Chandanpanda/ART-Forum-2017-Stan-Tutorial/sim/batline/README.md

# IMU bat: automated build and calibration line

A snapshot, 1 October 2026, of the design doc of the same name; and, from 2 October, the first five milestones (M0 to M4) of its simulation plan, "IMU bat line: MuJoCo implementation plan". Where the two differ, the plan wins: it keeps a person for six manual tasks, including the sleeves, and builds every station as a gantry module. Whether the 5-DOF arm stays is still open; none of the five depends on it.

`sim/batline` is the design of an unattended line that builds, calibrates and tests the IMU bat, the study that decided the bat, the specs, the derived bat and the fast line model that the rest of the simulation builds on, the station module that every station is a copy of, the calibration station's eight-camera rig, the IMU's calibration on its gimbal, and the tests: station 2's board self-test, the factory iPhone's test and the full-speed swing rig.

    python3 sim/scripts/batline/check_all.py                # check_bat, check_line, check_gantry, check_cameras, check_imu, check_calibration,
                                                            # check_link and check_swing, about 48 minutes on four cores
    python3 sim/scripts/batline/demo_bat.py [--bat adult]   # the bat rendered: twelve views, one contact sheet
    python3 sim/scripts/batline/demo_station.py [--station unseen] [--window T0 T1]
                                                            # a station commissioning itself and running every op, filmed at 0.1 fps
    python3 sim/scripts/batline/demo_rig.py [--bat unseen] [--window T0 T1]
                                                            # the rig calibrating itself and measuring a bat, through its eight cameras
    python3 sim/scripts/batline/demo_calibration.py [--bat adult] [--window T0 T1]
                                                            # a bat's IMU calibration plan, filmed beside its stream and the steppers' lag
    python3 sim/scripts/batline/demo_swing.py [--bat adult] [--weak] [--window T0 T1]
                                                            # the swing rig through the rated swing on its dummy pack, beside its traces
    python3 sim/scripts/batline/demo_phone.py [--bat adult] # what the factory iPhone sees through the slow swing, and where the app puts the bands
    cd sim && python3 -m batline.line [--demand 1000]       # the bat and the line sized for it, as text

| file | what it is |
| --- | --- |
| `README.md` | this design: the bat, the stations, transport, calibration, testing, unattended running, capacity, how it maps onto `sim/truss` and `sim/rfgyc26`, build order, risks; and what M0 to M4 found |
| `spec.py` | the facts (an AA cell's IEC envelope, the printer, the board's placeholder drawing, the knit), the product rules, the two task specs (`Bat`, `Line`), and the estimates (`Est`, `Faults`, `Person`), each naming the milestone that replaces it |
| `product.py` | the bat derived from a `Bat`: the handle's section, the board slot and its snap, the cell stack, the frame's truss, the sleeve blank, the bands' zones, the tube and the tray, every part's mass, and every fit as a margin |
| `mjcf.py` | the derived bat in MuJoCo, one body per part, with liners that measure the fits to the micrometre, and the views `demo_bat.py` renders |
| `line.py` | the line sized from a `Line` and a derived bat: station times, the floor, printers, mandrels, stores, trays, racks, the person's minutes, and which station saturates first; each station's module, and its moves timed on that module's own axes |
| `station/` | the station module (M1). `spec.py` derives a station from what its head must reach: the head, the travel, each axis' drive, preload, limits and dynamics. `mjcf.py` builds it in MuJoCo as built, play and all; `sim.py` runs it behind `hal.py`'s contract (steppers, encoders, home switches, the load cell, the camera); `vision.py` finds a fiducial's centre; `ops.py` is the executor; `commission.py` is the station measuring itself from its drawing |
| `rig/` | the calibration station's camera rig (M2). `spec.py` derives the gimbal, markers, balls, lens and standoff from the bat and the catalogue; `place.py` places the eight cameras; `mjcf.py` builds the rig as drawn or as built; `lens.py` is the camera model; `vision.py` is what the cameras see, modelled or rendered; `track.py` is association, self-calibration and tracking; `calib.py` is the bundle adjustment and the drift test; `pose.py` is the clamp's pose; `colour.py` reads the card and the bands; `inertia.py` is the gimbal's masses from its own MJCF, without MuJoCo; `judge.py` holds results against the truth, for the checks only |
| `imu/` | the IMU's calibration (M3). `kin.py` is the gimbal's motion in closed form; `part.py` the datasheet's IMU and its codes; `plan.py` designs the gimbal's plan from the targets; `fit.py` is the calibration fit and its verdict; `record.py` the record on the bat and the factory's database; `golden.py` the golden bat's daily check. For the checks only: `model.py` (the part's true errors), `scene.py` (the gimbal in MuJoCo), `sim.py` (a bat through the station) and `judge.py` |
| `board/` | the bat's board and link (M4). `power.py` derives what the board draws, its hold-up and the station's current limits from the parts; `sync.py` recovers the bat's sample clock on a central's; `procedures.py` is station 2's flash and self-test, the link station 4 writes the record over, and the factory iPhone's pairing; `hal.py` the instruments' contract. For the checks only: `firmware.py` and `radio.py` (the board as a state machine and its link as a channel) and `sim.py` (a board on the bench, with planted faults) |
| `phone/` | the factory iPhone's test (M4). `camera.py` is the phone's camera through the fold mirror; `app.py` the game app's fusion; `test.py` the slow swing, its limit from the accuracy budget, and the test. For the checks only: `sim.py` (the gimbal, the bat's stream and the camera's frames) and `picture.py` (the phone's view rendered in MuJoCo) |
| `swing/` | the full-speed swing rig (M4). `rig.py` fits the rig to the rated swing, picks its motors, plans its motion and runs the test; `hal.py` its contract. For the checks only: `sim.py` (the rig, its servo loop and the sprung dummy pack in MuJoCo) |
| `executive/des.py` | the fast line model: a month of the line, with faults, rejects and a robot outage, in under a second |
| `imu_fusion_sim.py` | Monte Carlo of how well an IMU bat, anchored by the phone camera, knows its sweet spot at contact. numpy only: `python3 sim/batline/imu_fusion_sim.py [--quick]`. `product.py` sizes the frame against its hardest swing |
| `m4_review.md` | the adversarial review of M4's changes: 38 open findings, 7 blocking, each with its fix |
| `imu_fusion_results.md` | what that simulation found |
| `results_raw.md` | its full output |
| `line-layout.png` | the line at a glance |
| `../scripts/batline/` | `check_all.py`, `check_bat.py`, `check_line.py`, `check_gantry.py`, `check_cameras.py`, `check_imu.py`, `check_calibration.py`, `check_link.py`, `check_swing.py`, `demo_bat.py`, `demo_station.py`, `demo_rig.py`, `demo_calibration.py`, `demo_swing.py`, `demo_phone.py` |

Every number in this folder is a model or a planning estimate, not a measurement.

## Milestone 0: the specs, the bat and the line model

Nothing in M0 is placed or sized by hand. The bat is derived from its envelope (length, handle, grip, width, depth) and the facts in `spec.py`; the line is sized from the derived bat and a `Line`. A second bat size is a second `Bat`, not a second drawing: `check_bat` derives an adult's bat the code was never developed on, and it passes unchanged.

**The kid's bat** (770 mm, handle 270, grip 32) weighs 214 g with two AA cells and 168 g as shipped, and balances at 0.26 of its length. Its frame is a 48 mm triangle of 2 mm chords and 1 mm diagonals with 30 joints, 14 g, inside the truss cell's gantry reach (891 x 216 mm of 1,400 x 300). Under the hardest swing in the accuracy study it takes 4.2 N m at the shoulder, with a buckling margin of 5.13 against the truss cell's rule of 5. All 33 fits pass. The adult's bat (860 mm, handle 300, grip 34) weighs 255 g, gets 3 mm chords and a buckling margin of 10.

**What M0 found that needs a decision or a later milestone:**

1. **The printed handle bends.** Under the rated swing the sweet spot moves 0.4 mm with the blade's bend but about 3.8 mm with the handle's (an estimate, for PETG at 2 GPa), against the 0.5 mm of lever-arm error the accuracy study assumed. M5 (`check_frame`) has to settle it; a stiffer handle may be needed.
2. **The bands have no room for the knit's stretch.** Each band's zone (5 mm either way) is used up by printing and placement scatter, and band 1 moves about 1 mm for every 0.01 of error in how much the knit narrows when it is stretched. M7's sleeve rig has to measure that, or the zone has to grow.
3. **The core only fits a 256 mm printer bed on the diagonal**, one a plate, so 13 of the 16 printers at 300 a month print cores.
4. **Cutting rods by hand is the person's biggest task**: about 5 of the 11.5 minutes a bat the event model measures (the sleeves take nearly 4). With rods bought cut to length, or cut by a machine at station 1 (`Line(rods_by_hand=False)`), the event model measures about 7.
5. **A tray of four bats is 816 x 296 mm and has to span the 700 mm between a dock's rails**, so bats lie along the aisle and docks sit 0.82 m apart. Each station's gantry is then longer than the truss cell's (0.8 to 3.3 m along the aisle, against 1.4 m), and the aisle is about 26 m long at 300 a month (41 m at 1,000).
6. **The 3-day promise has no slack for a bat that fails after its sleeve is fitted**: the new sleeve waits for the next visit. In ten simulated months that made one order late, by 0.9 days.

**The line at 300 a month** (16 hours a day, a visit each morning, a restock each week): station 1, the frame, takes 28 minutes a bat (23 by the truss cell's own planner, 4.5 of moves) and is the only busy station, at 31%; the other four are under 5% and the robot 8%. It needs 16 printers, 16 mandrels, a stock of 25 frames, and 13 bat, 8 tube, 8 stretcher, 4 mandrel and 11 parts trays. Ten simulated months with station and robot faults and an 8-hour robot outage shipped every order inside the promise apart from the one above, with no store running dry and no rack overflowing.

**At 1,000 a month station 1 saturates first**: it can build about 970 a month. The robot comes next by the plan's estimate (about 3,800), though the event model measures it 17% busier than that estimate at 300; then the sleeve station (about 6,700). At 1,000 the event model's frame stock runs dry every month.

**The checks.** `check_bat` (188 checks) holds every fit, overlap, mass and band on both bats, then builds both in MuJoCo and measures the fits against liners and the masses against the derivation. It also derives 13 bats that must fail; nine of them have one spec pushed 0.05 mm (or 0.05 g) past the room their fit reports, and must fail by exactly that much, which shows each margin is the real room. `check_line` (73 checks) tests the sizing maths against a direct sum and a simulation of the print farm, every fit of the plan, ten months at 300, and three lines that must fail: one asked for more than station 1 can build, one restocked short and one with too few stretchers.

**What is still an estimate:** every station's work inside a job (`spec.Est`), every fault and reject rate (`spec.Faults`), the person's minutes (`spec.Person`), the board's drawing, the knit, the robot's speed, and the dock. Each names the milestone that replaces it.

## Milestone 1: the station module

Every station is one module, copied: X, Y and Z on MGN12 rails, a NEMA 17 with an encoder on each axis, a head carrying that station's tools on a 3-axis load cell, and one camera looking down. Nothing about a copy is typed. `station/spec.py` takes what a station's head must reach (the docks, fixture and test pieces `line.py` laid out, and which tool works on each) and derives the head, the travel, each axis' drive, preload and speed limits, and the dynamics MuJoCo builds from. `check_gantry` then runs two copies in MuJoCo: the kid's electronics station (X 1,643 mm, four tools), which the module was developed on, and the adult's pack station (X 2,728 mm, five tools, two of them never carried before), which it had never seen. Both pass unchanged: 80 checks, about 5 minutes on four cores.

**The drives.** The plan's 12 mm ball screw whips before it reaches the rated 60 mm/s on any X longer than about 1.15 m, and a 20 mm screw past about 1.6 m. Four of the five stations need 1.6 to 3.6 m of X, so their X is rack and pinion (module 1, a 20-tooth pinion through a 16:1 planetary, 0.0196 mm a step), driven from both sides as a bridge is; chan chose this on 2026-10-02. The calibration station's X (0.8 to 0.9 m) and every Y and Z keep SFU1204 screws. A must-fail builds the adult's pack station on screws alone and shows it missing its rated speed and acceleration. Every axis reaches the rated speeds, so the line's times from M0 do not move: station 1 still takes 28 minutes a bat.

**Repeatability.** Each axis on both stations returns to the same place within 0.0001 mm, from both sides, at both ends and the middle of its travel, against the brief's 0.05 mm. That is the model's floor, not a prediction: the model has no rail wear and no drift during a run. What it shows is that nothing in the design loses repeatability once the next finding is in.

**Every axis needs a preload, not a one-way approach.** A rack's play (15 arcmin at the gearbox plus 0.05 mm at the mesh, 0.094 mm in all) is about twice the module's repeatability. Ending every move travelling the same way, as CNC machines do, did nothing in the rig: the rotor rings at the end of a move and the carriage stops anywhere in its play. What works is a constant force pulling each carriage toward home (a constant-force spring; on Z, a counterweight that overbalances), larger than anything that could pull it off the loaded flank: about 21 to 23 N on X, 9 to 11 N on Y and 12 to 14 N on Z. With it, every axis holds its place within 0.0008 mm under the largest force a process may put on it (11.2 to 11.6 N on X). Without it, X is pushed across its whole 0.094 mm of play; that is the must-fail. Plain moves without the preload still repeat to 0.032 to 0.038 mm, which is why a repeatability test alone never found this. The rule that follows: a process force must push the way the preload pulls, or stay under it.

**Lost steps and homing.** A jam mid-move (a stop in the carriage's path) is caught by the encoder, 5,236 and 8,700 steps short, and the move fails; homing again from the middle of the travel puts X back within 0.0012 mm. Homing seeks the switch at a quarter of full speed from wherever the axis is, backs off, and creeps onto it at 1 mm/s, the speed the switch's 0.005 mm repeat is quoted at.

**Commissioning: the station measures itself from its drawing.** Each build is drawn with its own errors (tools, camera offset and tilt, docks, fixture, home switches; `spec.Build`). The station homes, measures its camera's scale, turn and tilt using its own steps as the ruler, finds each dock and the fixture by their fiducials, and measures every tool against a reference pin by touching it from four sides and on top through the load cell. The kid's electronics station takes 333 s of station time for four tools; the adult's pack station takes 475 s for five. After that, every tool sent over the pin, and over the four corners of the farthest region it works on, lands within 0.035 mm on the kid's station (0.021 rms) and 0.030 mm on the adult's (0.023 rms), and at the height asked for within 0.020 mm. Sent by the drawing alone, the same tools miss by 1.5 and 0.8 mm.

**Accuracy is set by the camera, and the check says so.** The bound is not a millimetre figure picked to pass: each target must land within 4 sigmas of what the camera can know there. One look is good to about 0.0096 mm (0.07 px at the look range), growing to about twice that at a corner nobody looked at. The worst target was at 2.6 sigma. With the camera's noise switched off, commissioning lands within 0.008 mm rms, so the camera, not the mechanics, is the limit.

**What M1 found:**

1. **Two fiducials a region are not enough.** The head's steps are the ruler, and a rack or screw a few kelvin warmer than when it was cut is a longer ruler, each axis by its own amount. With two fiducials and a rigid fit, the adult's 1.7 m fixture was 0.14 mm out at each end; a fit that also took a scale still left 0.08 mm at the corner nobody looked at. Each region now carries three fiducials in an L, as a circuit board panel does, and an affine fit takes up each axis' scale and their squareness. Commissioning records the scale it found.
2. **The camera's centroid error is measured, not assumed.** The rendered frames put a fiducial's centre within 0.016 px rms of the model camera on the kid's station and 0.069 px on the adult's, a bias common to its flat discs that is not the light's fall-off, the headlight's reflection or the renderer's smoothing. The larger, 0.07 px, is now `HeadCam.CENTROID_PX`, and `check_gantry` re-measures it every run. It still has to be measured on the real camera.
3. **The camera must centre over what it measures.** The 20 mm reference pin seen off-centre is found 12 px away from where it is, by parallax; `look()` centres first.
4. **Unexplained:** the press reads the 2.0 N/mm test plunger 2.7% low (1.945 and 1.948 N/mm, inside the 10% it is held to). The load cell's own spring accounts for only 0.4% of that.
5. **Two MuJoCo modelling lessons**, kept so they are not relearned. A force that pulls from the frame (the preload, a disturbance) has to be applied to both the drive and the carriage, so the motor carries it; applied between them, it hid lost steps. And friction on a light, spinning joint did not stop the test nut spinning off its stud when the collet spun up, so a weld stands in for the self-locking thread and is released while the collet holds the nut.

**The checks.** `check_gantry` (80 checks) first holds every station of both bats to the module's rules in arithmetic: all ten meet their 20 to 22 rules, and each travel takes in every region and fiducial wherever 200 drawn builds put them, with 0.76 to 1.43 mm to spare. Then, in MuJoCo on each of the two stations, it checks repeatability, holding under process forces, lost steps and re-homing, commissioning and accuracy against the camera's bound, every op on the module's test pieces, and the camera's centroid against rendered frames. The ops are: each pick tool (gripper, vacuum cup, magnet, collet) takes a steel token and sets it back upright inside its nest's 0.25 mm clearance; the press reads the plunger's rate; the spindle runs a nut 8.8 turns down its stud until it seats; and the pogo block closes all five pins on its pad. Four must-fails show each finding is real: screws only on a long X, X without its preload, a tool sent by the drawing, and the pin seen off-centre. `check_line` now also holds every station's module to its rules when it sizes the line (176 checks, up from 73). `demo_station.py` films a station doing all of this at 0.1 fps, from the aisle and from a camera riding Z beside the tools; the frames of both stations were read for this milestone, and at 1 fps through the screw op, where the nut is seen to run down its stud and seat.

**What is still an estimate:** every hardware fact marked [VERIFY] in `spec.py` (the motor's pull-out curve, the rack and gearbox, the rails' drag and damping, the load cell, the camera, every tool), the build errors in `spec.Build`, and the test pieces. The ops ran on test pieces, not on bat parts; those come with the stations, M5 to M8.

## Milestone 2: the camera rig

Station 4 is the station module plus a two-axis gimbal that turns the bat through every orientation, and eight cameras round it that measure the clamp's pose in every frame and read the bands' colours. Nothing in it is placed by hand. `rig/spec.py` derives the gimbal, its markers, the ball size, the lens and how far the cameras stand off from the bat and the catalogue; `rig/place.py` places the cameras; the rig then calibrates itself from a certified bar. `check_cameras` runs all of it on the kid's bat, which it was developed on, and on the adult's, which it never saw, with two implementations of the cameras: a fast model, and frames rendered in MuJoCo and warped through each camera's true lens. Both bats pass: 116 checks, about 14 minutes on four cores.

**The rig.** For the kid's bat: 19 mm retroreflective balls on M3 stems, a 3.6 mm M12 lens, the cameras 1.35 m from the gimbal's centre (1.48 m for the adult's), eight markers on the inner ring and eight balls on the bar. The gimbal sweeps a ball 0.99 m across, its centre 0.50 m up. Station 4 needs 2.78 x 2.53 m of floor; its gantry homes above the sweep, so Z has 0.98 m of travel and the frame's rails sit 2.24 m up, clear of it. A bat takes 276 s there.

**The placement rule had to change.** The plan asked for every marker on the clamp to be seen by three cameras at every pose. No set of eight cameras does that: at some poses the ring hides its own balls from too many directions. The rule now is that with any one camera lost (blocked, knocked, dead), every pose still rests on at least three markers each seen by three cameras, and the pose is fixed within the rig's share of the calibration budget (a quarter of the 0.2 degree mounting and 0.5 mm lever-arm targets, 1 sigma). A view counts only if the tracker would use it: the ball whole on the sensor, nothing within a guard band of its outline, its stem side-on enough to correct, and its image clear of every other ball's. The solver searches 207 allowed camera positions against 288 gimbal poses and is judged on 576 poses it never saw. With any one camera lost, both bats' rigs keep at least 4 such markers, with the pose fixed to 0.0057 degrees and 0.054 mm (kid) and 0.0060 degrees and 0.059 mm (adult). The best seven cameras fail the rule on both bats (2 markers), so the eighth camera is needed. Eight cameras spread evenly at the gimbal's height also meet the rule, with one marker less to spare, so the solver buys margin here, not feasibility.

**Self-calibration finds the planted lens errors.** Each build is drawn with its own errors: every camera's place (5 mm), tilt (1 degree), focal length, principal point (15 px) and lens curve, the gimbal's axes and encoder zeros, the markers, the stems' pull, and each sensor's colour response. The gimbal turns the certified bar through an 8 x 8 grid of poses; the rig associates blobs to balls, bundle-adjusts every camera and marker, and repeats until the matches settle. Afterwards every calibrated camera puts every ball within 0.009 to 0.015 px rms of where the camera as built does with the model cameras (0.052 px at worst), and 0.008 to 0.019 px from rendered frames, against the 0.07 px centroid budget. Every lens parameter and marker lies within 4 sigmas of its own stated sigma, and every sigma is one the data fixed.

**The clamp's pose, on poses no calibration saw** (a quarter step off its grid, none of them a calibration pose), is good to 0.0047 degrees and 0.018 mm per axis with the model cameras on the kid's bat (0.0046 and 0.020 on the adult's), and to 0.0028 degrees and 0.006 mm from rendered frames (0.0013 and 0.005 on the adult's). The budget is 0.05 degrees and 0.125 mm, so the margin is at least 6 times. The gimbal's encoders alone, judged through the gauge that suits them best as the cameras are, are 0.14 to 0.22 degrees and 0.6 to 1.3 mm off, which is why the cameras are needed.

**The shift-start check** looks at the ring's markers at 16 poses and tests the residuals against the noise, and each camera's share of the balls it should have matched and did not. It passes the rig as calibrated. It catches a camera knocked by 0.05 degrees (the rig's whole rotation share), whichever of the eight it is, and names it; and it catches and names a camera gone dark, or knocked 1.5 degrees, so far that nothing it sees can be matched.

**Colour.** A designer's colours are sRGB; a print reflects their decoded, linear values, and the cameras read linear. A card of four printed patches (white, red, green, blue) of certified reflectance on the clamp gives each camera's colour response, fitted over the cosine and the ring light's fall-off with distance, and weighted by the sensor's own noise. The sleeve's own reflectance is then measured through the card, and each band is read against the sleeve beside it on the same flat face, which cancels what is left of the light and the angle. Every colour written reads back within 0.04 to 0.31 dE (CIE76), against the 2.3 dE limit: the design's colours, the two bands swapped, both bands the sleeve's white, one band printed 4.6 dE off, and the design's bands on a knit 4.6 dE darker than drawn. The line passes the design's bands, on either knit, and refuses the others, including the design's sRGB numbers printed as if they were reflectances (22 to 27 dE off).

**What M2 found:**

1. **The stems pull the centroids.** A ball's stem, seen from its own side, hides a strip of the ball and drags the centroid away from it, by up to about 0.3 px in the rendered frames, several times the noise. Placing cameras to avoid that cost about a third of all views and broke the placement rule. Instead the pull is corrected: its shape follows from the geometry, and its scale is one number for the rig, which self-calibration solves along with everything else (to about 0.02). Rendered frames pull 1.27 to 1.32 times the simple area model; after the correction, what is left is 0.023 to 0.025 px rms, against 0.17 to 0.18 px uncorrected. Left uncorrected, the shift-start check refuses a healthy rig.
2. **The placement must count only views the tracker will use.** At first about one view in ten that it counted was one the tracker refuses: a ball whose image touches another ball's, or with something just outside its outline. Judged by the tracker's own test, that placement left a pose with only 2 markers. The placement now uses the same test, `check_cameras` holds it to counting nothing the tracker refuses, and re-placed under it both rigs keep 4.
3. **A camera that sees nothing passes a residual test.** The shift-start check tested only the residuals of what it matched, so a camera gone dark, or knocked far enough that nothing matched, left no evidence and passed. It now also counts the balls each camera should have matched and did not, against all the cameras together, so no failure rate has to be assumed.
4. **The card has to be under the clamp too.** The gimbal turns a flank's normal only about its outer axis, so no pose faces a flank down the aisle, and two of the kid's cameras never saw the card. The card now also has a row on the clamp's underside, which can face any direction.
5. **The card buys margin, not a pass.** Without it the bands read 1.1 to 2.2 dE off: inside 2.3, with almost no room for a real sensor's drift.
6. **The supplier's lens curve alone already holds the pose budget.** Holding the lens curve at the catalogue value instead of solving it leaves the cameras 0.11 to 0.45 px off, 1.6 to 6.5 times the centroid budget, yet the pose stays within 0.008 degrees and 0.07 mm. Solving the lens is what lets the shift-start check work at the noise, not what holds the pose.
7. **The marker balls hide card patches.** A visibility test that ignored the balls let one camera read a patch half covered by a marker, which put that camera's colour response 10% out. Colour visibility now counts everything a ray can hit.
8. **The stated noise must be the budget, not the scatter.** Rendered centroids scatter by 0.02 px, but the solution's own sigmas built on that understated the markers' and poses' errors by up to 2.7 times, because the residuals cannot see what the solution absorbs. Calibration and tracking now state their covariances at the 0.07 px the rig is held to. That 0.07 px is a budget carried over from the head camera, not a measurement of this one: the rendered frames come in at 0.023 px, and `check_cameras` fails if they ever exceed it.
9. **The station gripper cannot take the bat by its handle.** `Gripper2` opens 20 mm and the grip is 32 to 34 mm. M3, which loads the bat into the clamp, needs a wider gripper or a different hold.
10. **The line model now uses common random numbers.** M2's larger station 4 changed the floor, which re-dealt the event model's random month and moved a `check_line` result that had nothing to do with it. Each source of chance (orders, each resource's faults, each station's rejects) now has its own random stream, so a change elsewhere deals the same month.

An adversarial review of M2 after it was pushed confirmed 24 findings. The ones that changed results:

11. **Colours are reflectances, not sRGB numbers.** The scene printed the design's sRGB numbers as if they were reflectances, and the card's certified values were compared with them as if both were the same thing. Everything is now linear until the band is encoded back to sRGB to compare with the design; a print with the sRGB numbers as reflectances reads 22 to 27 dE off and is refused.
12. **The ring light falls off with distance.** The card was fitted as if every patch were lit equally. Its fit now carries the cosine and the inverse square of the distance, and what it leaves is the sensor's own noise (chi-square per degree of freedom 0.72 to 1.27); fitted without the fall-off it leaves 12 to 460 times that.
13. **The sleeve is measured, not assumed.** Each band is read against the sleeve beside it, so a knit darker than drawn darkened every band. The sleeve's reflectance is now read through the card, to within 0.1 dE.
14. **No light reads below dark.** The sensor's colour mixing was drawn signed, so a channel could read negative light, which the sensor then clipped at zero; and a dark pixel's noise was clipped at zero too. Either way a band's 1 % green read 2 to 5 %, 3 to 10 dE off on half the cameras. A channel now leaks into its neighbours only positively, and the sensor reads on a black level, as real ones do, so a dark pixel keeps its noise either side of zero.
15. **The renderer's 8 bits are coarser than the sensor's 10.** A dark channel on the rendered canvas is a few counts, so the rendered card left twice the sensor's noise. The colour canvas is now drawn twice, the second time 16 times brighter, and the check states the canvas's remaining step beside the sensor's noise. A card patch is read at whole pixels, each once, so no two samples share a pixel's noise (a patch seen obliquely had been read nine times from the same four pixels).
16. **A ball's own stem hid it from the model camera.** A quarter of the most strongly pulled balls went missing in the model camera, unlike in rendered frames, so its checks ran on a thinned population. A ball's own stem no longer hides it there, in the tracker or in the placement; the pull correction is what accounts for it.
17. **The stems' pull is solved inside the bundle adjustment.** It was fitted between rounds, which gave it no honest sigma. As one more unknown of the solve it gets its marginal sigma, and the rendered tier now checks it against the scale the same frames measure: 1.318 against 1.275 for the kid, 1.304 against 1.265 for the adult, 2.2 and 1.8 sigma apart, with the area model's 1.0 refused at 12 to 14 sigma. The gap is a small share of the pull the free markers absorb.
18. **The checks were looser than they said.** The held-out poses included calibration poses (all 16 of them in the rendered tier); now none do, and a check says so. The encoders' must-fail was judged without the gauge the cameras get. A parameter the data did not fix passed its z test with a z of zero; now it fails. The procedures were trusted not to read the scene's truth on the strength of a text scan that missed the most direct ways; the checks now hand them an object that has only the cameras' contract (cams, snap, colour), and the scan, now of code only, is shown to catch a dozen ways of reaching past it.

**The checks.** `check_cameras` (116 checks): the placement on both bats, judged on held-out poses, with the best-seven must-fail and the tracker's own test; in arithmetic, the rig, its site and station 4's module against their rules, and a scan that no procedure reads the scene's truth; then, per bat, self-calibration, the held-out pose, the shift-start check and colour with the model cameras, and the centroids, self-calibration and pose from rendered frames, plus colour from rendered frames on the kid's. Its must-fails are: the supplier's lens curve held, the encoders alone, the best seven cameras, the stems' pull left uncorrected (in the centroids and in the shift-start check) or left at the area model's scale, the card fitted without the light's fall-off, the bands read without the card, four wrong band prints, and the truth scan shown a dozen ways of reading the scene. `demo_rig.py` films the bar's calibration sweep and the bat's poses through the eight cameras at 0.1 fps, with the drawing's and then the calibration's predicted ball positions drawn on each view; the kid's sheet was read for this milestone.

**What is still an estimate:** every [VERIFY] fact about the cameras, lenses, ring lights, markers, gimbal and card, the rig's build errors (`spec.RigBuild`), the scale of the stems' pull on a real ball, and the colour model (a matte surface lit from the lens). The IMU's own calibration from these poses is M3.

## Milestone 3: the IMU's calibration

Station 4 now calibrates the bat's IMU and checks itself at the start of every line day, and nothing in either is a recipe. `imu/plan.py` designs the gimbal's motion from the calibration targets and the gimbal's own limits; `imu/fit.py` fits each bat's errors from the board's stream, the encoders and the cameras' poses, and judges it; `imu/record.py` writes the result to the bat and to the factory's database; `imu/golden.py` sizes and judges the golden bat's daily run. `check_imu` holds the simulated IMU and gimbal to the physics, and `check_calibration` runs 120 healthy simulated bats through the station, plus faulted ones: 100 of the kid's, which it was developed on, and 20 of the adult's, which it never saw. Both suites pass, 80 checks each.

**The plan.** For the kid's bat it is 79.9 s: three stills and three spins (two about the outer hinge at 2.7 and 2.9 rad/s, one about the inner at 5.2), chosen by a greedy search over stills and spins, ordered into one closed tour from the gimbal's zeros and back to them, and checked against every term's threshold on the exact information of that tour. A term's threshold is the 1 sigma that lets 100 bats' RMS error meet its target at the qualification's 0.1% (`fit.thresholds`). The gimbal runs at its steppers' pull-out torque less gravity's and the rates', and every quiet interval starts once the ringing of the move before it, at that pose's own natural frequency, is below what a window of samples can see. The simulated lag, the steppers' sine-law compliance under every load in MuJoCo's dynamics, stays within the plan's own bound (0.280 of 0.326 degrees) and under the angle at which a stepper slips a step (at worst 62% of it). The adult's plan is 118.2 s: three stills and four spins. M2 timed station 4 by a hand recipe for the gimbal; the line now takes the plan's own duration, and station 4 takes 5.0 minutes a bat with the loads, the iPhone test and its share of the full-speed swings (M2's 4.6), and is 5% busy at 300 a month.

**The fit.** 46 parameters: each sensor's 3 x 3 map (scale, cross-axis and mounting together), the biases and their temperature coefficients, the gyro's g-sensitivity, the IMU's position in the clamp, gravity's direction, and the board's clock (its first sample and its rate), with the gimbal's own geometry refined jointly under the cameras' prior. On 100 kid bats every group's RMS error is within its target, the worst (the lever arm) at 0.34 of it; on 20 adult bats the worst is at 0.39. No term is biased, the fit's covariance covers its errors (pooled NEES 3029 on 2800 dof for the kid, 647 on 560 for the adult, both inside their bounds), and no healthy bat of either size is rejected. A stuck gyro axis, a noisy accelerometer axis, a part 8 sigma off its scale, a gap in the stream and a stream cut short at either end are each rejected for their own reason. A fit takes 4.7 s at worst, well inside the next bat's plan.

**The golden bat.** A rig fault the fit cannot absorb moves every bat's terms the same way: an encoder's scale (it reads (1 + eps) q where its axis turned q, so the fit reads every bat's gyro scale wrong by eps), the station's clock, an encoder's cyclic error. A golden day is the bats' own plan run on a golden bat, clamped once, before the day's first bat, as many times as it takes for the smallest drift that puts a group of bats out of target, along its worst direction, to stop the line 99 times in 100 while a healthy rig stops it once a year. The plan itself is designed for both: of the plan designed for the bats alone and one that also holds each watched term to what one golden run needs, the station keeps whichever makes its day shorter. On the kid's bat that is the second, 79.9 s run once, against 99.7 s run 19 times (879 s against 2893 s for the station's day of bats and golden runs). The golden bat watches the scale and cross-axis terms, one lever-arm term and the clock. It cannot watch the biases (each power-up redraws them by about their target) or the mounting and the rest of the lever arm (each re-clamp redraws them by more than their margin); the cameras' drift check guards the seat's, and the power-up's are a stated gap. Two golden bats run on alternate days, and after a stop the other decides between a drifted rig and an aged bat. Each is certified on 20 commissioning days, and the certificate, from what those days scattered by, sets how many runs its golden days take: both bats' came out at one run, the weakest group at lambda 87 and 67 against the 51.6 needed. No undrifted day stopped the line; the smallest encoder-scale drift that matters (8.9e-5 on the outer hinge, half what each bat's following-error test can see) stopped all six days it was planted on; and `attribute()` told a drifted rig from an aged bat.

**The record.** 512 bytes, written to the bat's flash and read back, and kept with its full covariance in the factory's database (`imu/record.py`). Every field's float32 step is within 1% of its target, the biases stay within it across the die's plausible excursion with the stored coefficients, the CRC covers the header too, and every single-bit flip and truncation is refused. A stored row cannot be changed, deleted or replaced. The bat's geometry (its axis, sweet spot and bands) is not in it yet; a later minor version appends it.

**What M3 found:**

1. **The gyro's rounding is not noise.** The part's gyro noise is 0.38 of a code, too little to dither its rounding, so a still's mean keeps a rounding error that averaging does not remove, and its variance depends on where between two codes the true rate sits: 1.11 times the white-noise model's on a code and 1.60 times halfway between (Widrow's quantisation theory; a Monte Carlo agrees within 1%). Modelled as white noise, 6 of 20 bats were refused, for gyro sigmas and spin chi-squares. The fit now carries the rounded noise exactly, each still's at its own place, and with the spins' own scatter in the noise solve every bat's measured noise is 1.00 ± 0.02 of its model.
2. **The cameras' misfit was counted twice.** The fit scaled the poses' covariance up by their chi-square, and the verdict then tested the same chi-square. The poses now enter as the cameras state them, and only the verdict judges their fit.
3. **No chi-square sees a stuck axis.** A channel that holds one code has no measured noise, so every test scaled by measured noise passes it, and the check's first must-fail had that backwards. Before the fix a stuck gyro axis threw the starting clock 235 ms off and the fit crashed. The station now refuses a channel that holds one code through the plan before it fits anything.
4. **The noise solve could run away.** A target that was not a number drove its root bracket to e^40 codes and the process to 12.9 GB before it was killed. The solve now has a closed form past 1.65 codes and refuses a target that is not finite.
5. **A noisy part is refused for what its noise costs, not for the noise.** An accelerometer axis measured at 1.8 times its datasheet's noise still meets every target and is accepted; at 4.7 times its sigmas pass their thresholds and it is refused. Screening a part on its noise alone is open.
6. **The steppers were planned past pull-out.** The gimbal's motors were modelled as linear springs. At the planned accelerations the spring carried 2.68 N m against the motor's 1.80 N m peak, 49% more than it has, and under the motor's true sine law the first plan would have lost a step 0.79 s in. Its check compared the linear model with itself, so it could not fail. The motor is now the sine law, which raises a lost step; the plan budgets every move's ring and keeps spins below the held hinge's resonance. The kid's accelerations fell from 1.9 and 9.5 to 0.65 and 3.0 rad/s^2 and its inner spin from 28.9 to 11.7 rad/s.
7. **The plan did not come home.** It ended with the gimbal's cable at full wrap, and the return to the zeros was outside its duration: 6.3 s on the kid's then 61.6 s plan (10%), 7.4 s on the adult's. The tour now closes at the zeros, inside the duration the line takes.
8. **Each corner rings at its own frequency.** The hinges' natural frequency falls from 28.8 to 25.5 rad/s across the kid's poses. With one frequency for all, quiet intervals started at twice the ring they allow. Each settle now uses its own corner's frequency.
9. **The golden day belongs in the bats' plan.** Run on the bats' plan alone, a golden day took 27 runs (3691 s, the kid) and 53 (5989 s, the adult), because nothing in that plan valued the golden bat's terms: the gyro's z scale sat at 0.77 of its target, leaving little margin to watch. Designing the plan for both makes the golden day one run.
10. **Ten days cannot measure the rig's scatter.** The golden test needs how much the golden bat scatters from day to day, and commissioning measures it. Guarded for being measured on ten days, the test lost the power it was sized for (lambda 37 and 39 against 51.6), or, once the certificate set the runs, took 2.5 runs a day and refused 15% of healthy rigs; taken as measured, a rig whose days scatter twice their measurement along one direction stopped the line 2.7 times as often as it may (2.4 times on 20 days: per-term variances cannot see a direction). Guarded on 20 days it stops 1 such day in 2000, 0.2 times as often, and the certificate, not the plan, sets the runs, so a golden bat that scatters more than the spec says runs more rather than failing. Commissioning is therefore 20 days (`Quality.GOLDEN_RUNS`).
11. **The golden bat guards the encoders' scale, not the gear ratio.** Each encoder is on its axis, so a belt that slips or stretches shows as following error, which each bat's own verdict refuses. The check had planted a gear-ratio drift as a change in the encoders' reading. The drift a golden bat must catch is an encoder's own scale, and the check now plants that, at the least size that puts a group out of target.
12. **SQLite's INSERT OR REPLACE deletes without firing a delete trigger.** The database's triggers refused an UPDATE and a DELETE, and a REPLACE overwrote a stored calibration anyway. Inserting onto a stored id is now refused too, and the check tries all four ways.
13. **The daily test failed open.** A failed golden run gave a T^2 that was not a number, which compares false with any threshold, so the line ran. A day whose runs give no calibration now stops the line, and a commissioning day with one refuses the certificate.
14. **The board's clock is not the station's.** The board starts sampling some time after power, and its oscillator's rate is off by 0.5% (1 sigma); one adult bat's was off by 1.2%. The first clock paired gyro and encoder events by time, and on the adult's longer plan it ended 470 ms off; still windows straddled moves, the noise read 4.7 times the datasheet's, and every adult bat was refused. Matching the two streams' rates of change over the oscillator's whole tolerance, then timing each move from rest by angle, puts every quiet sample within 3.4 ms of the bat's own clock on either size, inside the windows' 5 ms margin.
15. **The check's faults were on the wrong clock.** The check placed a gap in the stream by the datasheet's clock, in samples the fit did not use, so the fit saw no gap and the check reported it accepted. Faults are now placed on the bat's own clock, the fit reads the stream by its sample counter, and a gap mid-move, where nothing is read, costs nothing.

**The checks.** `check_imu` (80 checks, about 3 minutes): MuJoCo's gimbal against the closed-form kinematics and dynamics, the steppers' lag against the sine law, the simulated part against its datasheet (filter, noise, rounding, rails, clock, warm-up), and a scan that no production module reads the simulation's truth. `check_calibration` (80 checks, about 12 minutes): the plan on both bats; the fit on 100 kid bats and 20 adult, with its covariance, its starting clock, and two terms left out to show their bias is what the fit predicts; every rejection for its reason; the record; the golden bat's sizing, certificate, daily test, drifts and attribution; the same golden functions on 2000 drawn days; and the line's use of the plan. `demo_calibration.py` films a bat's plan through two of the eight cameras beside the stream it produced and the steppers' lag; the kid's sheet was read for this milestone.

**What is still an estimate:** every [VERIFY] fact about the IMU (`spec.Imu`: its datasheet, warm-up, power-up repeatability and the firmware's boot), the gimbal's steppers and belts, the clamp's seat, and the rig's build errors. Not modelled: the encoders' accuracy beyond their resolution, the steppers' microstep angle error, and noise a real part shows beyond its datasheet. Open: the plan's search is greedy, and the plan designed to the golden bat's tighter thresholds came out 20% shorter than the one designed for the bats alone, so the bats' own plan is not the shortest that meets their targets. Spins are capped below the held hinge's resonance, which on the kid's inner hinge is 11.7 rad/s; a stiffer gimbal would shorten the plan. Loading the bat into the clamp is station work for a later milestone, so M2's finding about the gripper stands.

## Milestone 4: test and swing

Every bat's board is now flashed and self-tested at station 2, every bat goes through the factory iPhone's test at station 4 after its calibration, and one bat in `Est.SWING_EVERY` is swung at full speed on a dummy pack in an enclosed rig beside the gimbal. None of the three is a recipe: each limit comes from a datasheet, a rule or the accuracy budget, and each station's time is its procedure's own plan. `board/` is the board, its power and its link; `phone/` is the iPhone's test and the app's fusion; `swing/` is the swing rig. `check_link` (51 checks) runs the board, the link and the iPhone's test with no physics, and `check_swing` (30 checks) runs the rig in MuJoCo. Both pass.

**Station 2.** The probe erases the board, flashes the image and writes the serial over SWD, then the self-test runs 20 steps: the supply, the debug port, the image read back, the serial, advertising and its current, connecting, the board's report of itself, the IMU answering, its own self-test, the stream, no stuck channel, gravity's direction and size, a still gyro, noise, the board's clock against the station's, the current streaming, the hold-up and the current asleep. Every limit is derived (`board/procedures.py`): the currents from the cells lasting `Rules.PLAY_H` streaming and `Rules.SLEEP_DAYS` asleep, less the instrument's accuracy, and each sensor's from its datasheet's spread, all sharing `Quality.TEST_ALPHA` by Bonferroni. Of 200 healthy simulated boards 1 is refused (4 allowed), and each of 19 planted faults, from a shorted supply to a leaky sleep, is refused at its own step. The station takes 5.51 s on the mean board against 5.55 s planned; M2 booked 40 s.

**The power.** The board runs straight off the two cells, so it must ride through a cell's contact opening. `board/power.py` derives what it draws in any window from the parts' currents and the radio's charge per event. Riding through a 10 ms bounce (`Rules.BOUNCE_S`) at 1.92 V, the cells at 90% of their life, streaming to the phone, needs 206 uF. A 220 uF part at its -20% tolerance falls short, so `Board.HOLD_C` is 330 uF until a board is chosen. In simulation a contact break browns the board out 31 to 45 ms later, never sooner than the derived 15 ms. A simulated board streams for 1,701 h on fresh cells, against the design doc's 200 h floor.

**The record and the clock.** M3's record goes to the bat over the station's dongle and reads back bit for bit. It survives a 30% lossy link, a link dropped mid-write and power lost mid-commit: 41 cuts leave the old record or the new, never neither. A stuck flash bit is refused with nothing stored, and a record gone bad in the field is refused at pairing and restored from the factory's copy. The bat's sample clock is recovered on the central's as the lower convex hull of the packets' arrival times against their counters, the linear-programming estimator for one-way delays (Moon, Skelly and Towsley, 1999). It comes within `Quality.SYNC_S`: 0.83 ms rms at the dongle, 0.76 ms at the phone, where least squares is 4.3 and 10.7 ms off.

**The factory iPhone's test.** The gimbal turns the bat through 58.4 degrees, the turn past which doubling buys no more power to catch a bad record. The phone films its bands at 4 m through a fold mirror while the app (`phone/app.py`) fuses: the record applied, the stance levelled, the heading given by the rig, the position solved from the two bands, then the IMU alone. The fused sweet spot is judged against the rig's by a chi-square on the budget, which is the accuracy study run on this swing. Of 30 calibrated simulated bats none is refused (2 allowed), and their errors sum to d^2 40.5 against a bound of 117.1. Of 30 fused with the datasheet's record instead of their own, 24 are refused, against at least 13 needed for the designed 77%. The test takes 4.32 s against 4.42 s planned; M2 booked 60 s.

**The swing rig.** A planar rig: an arm on a hub carries the hands round the rated swing's arc (a Kasa circle fitted to it), and a second motor on the hub turns the bat's clamp through a belt, so neither motor rides the arm. Its motors are picked from a servo catalogue: the arm is a 1 kW motor through 10:1, because the 750 W one's inertia ratio would be 18 against the drive's 10, and the wrist is a 200 W motor through 10:1. The rig's Newton-Euler torques equal MuJoCo's inverse dynamics to 1e-9. MuJoCo runs the rig, its servo loop at 1 ms on 17-bit encoders, and a sprung dummy pack of two supercapacitor cells on slides. The bat follows its plan within 1.1 and 1.9 mrad. On the dummy pack and on the shortest pair of cells the bay takes, the circuit never opens (the least plate force is 2.13 and 1.49 N), and the chip peaks at 2306 dps and 12.7 g against the 3861 dps and 31.0 g a part at the calibration's quantile reads without railing. A spring at half the swing's pull opens 39 times for up to 84.6 ms and is refused at "rides through the swing"; a 2000 dps part is refused at "never rails". The test takes 1.82 s against 1.84 s planned; M2 booked 120 s.

**The line.** Station 2 is 2.7 minutes a bat and 3% busy at 300 a month. Station 4 is 4.1 minutes a bat, with the loads, the iPhone test and its share of the swings (M3's 5.0), and 4% busy.

**What M4 found:**

1. **The bands are seen 7 mm off the bat's axis.** On the rounded-triangle section, seen side-on with a flat face edge-on to the lens (station 4's view: the bat face down, the camera level), a band's silhouette is centred R/4 off the axis: 6.9 mm on the kid's bat, 2.5 px at 4 m. Square on to a face it is on the axis. The app took each band's centre, and the simulated camera agreed with it, so no number showed it; `demo_phone`'s rendered frames did. Left in, it moves every fused sweet spot about 7 mm (3.7 mm right and 5.9 mm up on 30 bats), and the factory test passes all of them: its budget at the slow swing is 7.3 mm rms, too wide to see it. The app now puts each centroid on its band's silhouette (`app.seen`), the simulated camera traces the section's outline, and `check_swing` holds the app's model to a rendered picture within 0.29 px. In the game the bat rolls, so the offset turns with it; the game's app needs the same model, with the IMU's roll.
2. **A colour threshold's centroid is a further pixel off.** The band's shaded side falls outside a colour threshold, which moves its centroid 0.8 to 0.9 px from the silhouette's at the stance at full size, and 1.6 px at one pose of the swing. The band finder must find the band's outline, not its colour's mean.
3. **Hold-up is counted in connection events, not in microfarads.** Each radio event spends a step of charge, so a capacitor carries the board to the next event or not at all. At its low tolerance a 220 uF part carries 0.95 ms, not even one event; 330 uF carries 15.0 ms, one phone interval, past the 10 ms bounce.
4. **The phone's clock needs 3.3 s of stream.** Every packet's delay only ever adds, so least squares is pulled late by the queued ones, and the hull's own error, with the lab's characterisation of the central's delay floor, must fit inside 1 ms. At the phone's 15 ms interval that takes 3.3 s of stream (0.44 s at the dongle's 7.5 ms). The iPhone test's stance waits for it, where the bat is still and it costs nothing.
5. **The rig's moves must be smooth in jerk.** Trapezoidal moves step the acceleration, and the grid the simulated IMU runs its part's filter on (`imu/model.internal_rate`) never converged on them. The rig's moves are now minimum-jerk quintics (Flash and Hogan, 1985).
6. **The rig's return stood the bat on its pommel.** Going back to park by the nearest whole turn swung the bat through upright, which pulled the pack off its plate at 8.5 g. Each move is now stretched until it loads the pack no harder than the swing, and the rig picks whichever whole turn is fastest under that.
7. **A stiff contact never settles.** With a spring-damper contact stiffer than two time steps MuJoCo holds the pack in a chatter. The contacts are a sphere on each pip, one contact point each, their stiffness from the cells' restitution over four time steps.
8. **The swing rig needs its own cap.** The pommel cap, which carries the product's spring, goes on at the pack station, after station 4. The rig closes the bay with a cap of its own carrying the same spring.
9. **The rig is planar.** It leaves out the swing's tilt and roll, 547 and 591 dps at the chip, and is 3.6 dps (0.16%) under the swing about the axis it does turn.
10. **Healthy bats come in at 0.68 of the budget.** Their d^2 sum is 40.5 against the 60 expected, because the budget's study draws error terms, the accelerometer's nonlinearity among them, that the simulated part does not have. The test is that much looser on simulated bats than it will be on real ones.

**The checks.** `check_link` (51 checks, about 80 s): the power derivations against the simulated board, the firmware's states and its record commit under power loss, wake on motion, the stream to both centrals, the self-test on 200 healthy boards and 19 faults, the record over a lossy link, the clock, the HALs, a scan that no production module reads the simulation's truth, and the iPhone's test on 30 calibrated bats and 30 with the datasheet's record. `check_swing` (30 checks, about 50 s): the rig's load against the 3-D swing, its dynamics against MuJoCo's, its motors, its moves, the pack at rest and through the swing, the chip's signals, the circuit, the spring, the rails, the station's test on six bats, the HALs, the truth scan, and the app's band model against the rendered picture. `demo_swing.py` films the rig through the swing beside its traces, and `demo_phone.py` renders what the factory iPhone sees; the kid's sheets were read for this milestone.

**Open from the review.** An adversarial review of these changes (four reviewers, each finding put to a skeptic) left 38 findings standing, 7 of them blocking; none is fixed yet, and all are in `m4_review.md` with their fixes. The blocking ones:

- Station 2's hold-up step opens the supply between radio events, so it only ever sees the board's base draw and passes any capacitor above about 40 uF. It needs a direct measurement of the capacitance.
- The hold-up derivation spends the radio's currents as its datasheet states them at 3 V. At 1.7 to 1.9 V a DC/DC draws about constant power, so its current is 1.6 to 1.75 times higher; by that, 330 uF at its low tolerance rides 8.3 ms of the 10 ms bounce, and the part should be 470 uF.
- A board seated tilted is caught only on some rolls, because the model let the bat roll freely in station 2's cradle. The pogo block needs the window up, so the roll is known, and the test should use it. Check 11 runs each planted fault on one board, which hid this.
- The iPhone test leaves the gimbal at the end of its swing, 29 degrees from the zeros where the gantry unloads it. The move home, about 0.8 s, is missing from the test and its plan.
- The swing rig has no footprint, enclosure or clamp position on station 4's floor, and its loads are timed at the gimbal's clamp.
- `check_swing` 9's must-fail is an algebraic identity that cannot fail, and check 5's tolerances have no stated origin (its wording also has the stiffness change wrong: doubling `sim.RING` quarters the stiffness).

**What is still an estimate:** every [VERIFY] fact about the board, the radio SoC, the link, the firmware, the probe, the source-measure unit, the dummy cells, the servos, the rig and the phone, and the cells' restitution on a contact; the hosts' delays, the boards' current spread and how often a bat is swung (`Est`). Not built: the swing rig's stereo, which the design doc used to measure the swing's sweet spot (M4's contract is the rail and the contacts), its enclosure's place on station 4's floor (M11), and loading a bat into it, which still needs a wider gripper (M2's finding).

## Summary

One unattended line can build, calibrate and test the bat at 300 a month and stretch to 1,000. It uses the machines you already have: the truss assembler, the XYZ gantry, the 5-DOF arm, the mecanum robot and the multi-view camera rig. Only the electronics board is bought in, and customers fit their own AA batteries, so the line never handles a cell.

Running 16 hours a day, 300 a month means one finished bat every 96 minutes. At 1,000 a month it is one every 29 minutes. Speed is not the hard part; running for hours with nobody there is.

Five rules shape everything below:

- **Design the bat for the robot.** Every part goes in with one straight move against a datum. No cables, separate screws, batteries or loose fabric.
- **Measure, don't place precisely.** The camera rig measures where each part ended up, and those measurements become the bat's calibration, stored on the bat.
- **Coarse by robot, fine by dock.** The mecanum robot only brings a tray near a station. A kinematic dock sets its exact position.
- **Every bat is calibrated and tested.** A sample is also swung at full speed against a stereo reference.
- **Nothing waits for a person.** A failed bat goes to a reject rack, the line keeps running, and you get a message.

All times and costs here are planning estimates, not measurements.

## The bat, designed for the robot

The bat is six parts, and each goes in with one straight move against a datum. Only the board is bought.

| Part | Made by | Goes in by |
| --- | --- | --- |
| Handle core: battery tube, board slot, datum faces | printed in-house (my default) | gantry places it in the frame jig |
| Blade frame | truss assembler | built onto the core |
| Electronics board | bought, ready-assembled | slides into the slot and snaps against two datum faces |
| Battery contacts | bought springs | pressed into the core |
| Printed sleeve with two tracking bands | printed in-house | pushed off a mandrel onto the bat |
| End caps | printed in-house | pressed on along the bat's axis |

**The board** should carry:

- **An nRF52840-class microcontroller.** It runs straight from 2 AA cells (1.7 to 3.6 V) with no boost converter. Bluetooth streaming draws a few milliamps, so 2 alkaline AA should last on the order of 200 hours of play (estimate).
- **A ±32 g / ±4000 dps IMU**, for example the TDK ICM-42686-P (check the datasheet). The simulation showed ±2000 dps saturating on hard swings.
- **Test pads on one face for pogo pins:** power, programming and serial. The line powers, flashes and calibrates the bat without a battery.
- **A hold-up capacitor and brownout-safe firmware**, because AA cells can bounce off their contacts in a hard swing.
- **Wake on motion from the IMU**, so there is no power switch to fit.

**Three rules keep the calibration valid for the life of the bat:**

- The board seats in the fixed core, never in the removable battery cap. Otherwise every battery change would move the calibrated IMU.
- The customer fits 2 AA in line through a screw-on pommel cap. The line never touches a battery.
- The sleeve's two tracking bands sit in reserved zones of fixed colour, about 30 mm wide and 0.45 m apart. Everything else on the sleeve is free artwork.

## The line at a glance

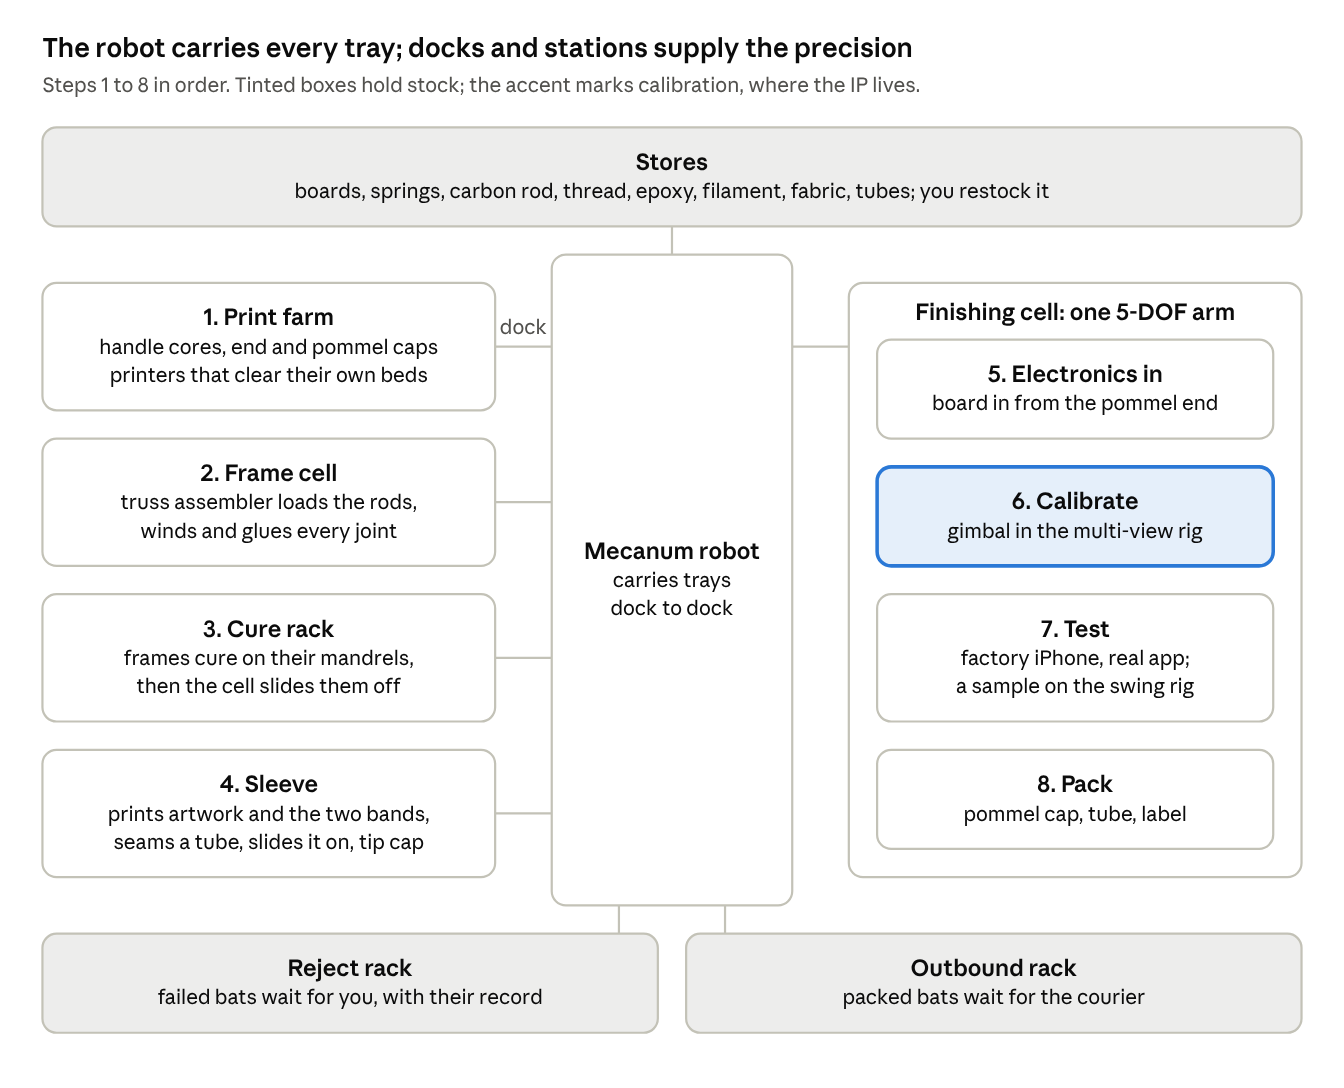
[picture p1: sim/batline/line-layout.png]
The robot carries every tray; docks and stations supply the precision


Every station has one dock. The robot sets a tray on it and later takes it away; all precise handling happens inside the station.

Steps 1 to 3 make identical frames to stock. An order enters at step 4 with its artwork, and the bought board only goes in at step 5, so boards are never tied up in unsold bats. You restock the stores and empty the two racks on your own schedule; nothing on the line waits for you.

## The stations

Each station reads the tray's tag and each bat's serial, does one job, checks its own work, and adds what it measured to the bat's record.

### 1. Print farm

Prints the handle cores, the blade-tip end caps and the pommel caps. Unattended printing needs printers that clear their own beds, such as belt printers or printers with an automatic plate changer, so finished parts drop into a tray at the dock. A camera at the dock checks the count, and that each core's board slot and battery bay are clear.

### 2. Frame cell

This is the truss assembler you already have. Its XYZ gantry loads carbon rods from magazines into a fixture on a collapsible mandrel, the C-ring winds Kevlar thread round each joint, and the dispenser puts epoxy on each band. For the bat, the handle core sits on the end of the mandrel, so the chords seat into its sockets and the frame is built onto it.

The bat's frame is a new task spec, and the existing code computes the fixture, the winding clearances and the cycle time from it. The cell's camera finds each joint before winding, and the inspector judges the finished frame from the ring's counted turns and where each rod was measured.

### 3. Cure rack

Wet frames cure on their mandrels in a rack, so the cell can start the next frame at once. When a frame has cured, the robot brings its mandrel back to the cell. The cell pulls the draw rod to collapse the mandrel (the one-pull release already designed in `collapse.py`), slides the frame off and reuses the mandrel. Finished frames wait on the rack as stock until an order needs them.

The number of mandrels follows from the cure time and the takt, so it is computed once the epoxy is chosen.

### 4. Sleeve

The one station that handles fabric, and the riskiest. It prints the customer's artwork, with the two tracking bands in their reserved zones, onto polyester knit by dye sublimation. A laser cuts the panel, which also seals the polyester's edges, and an ultrasonic head seams it into a tube; the cutter and the seam head ride an XYZ gantry.

A mandrel stretches the tube, a linear axis pushes the frame into it along the bat's axis, and the mandrel withdraws so the sleeve closes onto the frame. A press fits the blade-tip end cap, which clamps the sleeve's end. A camera checks the bands' colours and order against the artwork file; their exact positions are measured at step 6.

### 5 to 8. Finishing cell

The cell is built around the 5-DOF arm, which stays in this cell. The robot docks one tray of sleeved bats, and the arm takes each bat through four steps and puts it, packed, on an outbound tray.

- **5. Electronics in.** The arm slides the board into its own slot beside the battery bay, from the pommel end, until it snaps against its datum faces, then presses the contact spring in. A pogo block touches the board's pads at the pommel end to power it, flash the firmware, write the serial number and run a self-test: the IMU answers and reads gravity within its datasheet tolerance, and Bluetooth advertises. The board goes in this late so it never sees the epoxy's cure, and only ever into a bat that has an order.
- **6. Calibrate.** The arm loads the bat into a 2-axis gimbal inside the multi-view camera rig. The calibration section below covers what it measures.
- **7. Test.** A factory iPhone running the real app pairs with the bat and watches it at playing distance while the arm moves it slowly. A sample of bats also goes to an enclosed swing rig. The testing section below has the detail.
- **8. Pack.** The arm screws on the empty pommel cap, slides the bat into a cardboard tube with a quick-start card, caps the tube and applies a label with the serial and order number. A tube makes packing one axial move, which folding a box is not. A camera reads the label back against the order.

While the gimbal runs a calibration, the arm packs the previous bat and fits the next board, so one arm keeps up with the line.

## Moving bats between stations

- **Trays, never loose bats.** The robot carries trays. A tray holds several bats in V-cradles (four is my default) and carries a tag the stations read. Part totes, mandrels and packed tubes ride in trays of the same footprint, so one robot and one kind of dock move everything.
- **Coarse by robot, fine by dock.** Every dock is the same: two rails the robot drives between, carrying three balls. Each tray has three matching V-grooves underneath with chamfered lead-ins, a kinematic coupling. The robot only has to arrive within the lead-ins' capture range. When it lowers its lift, the tray drops onto the balls and lands in the same place every time, to well under a millimetre. The station's camera reads the tray's tag to confirm what arrived.
- **Where to stop is computed, never taught.** The stopping pose comes from the solver the competition robot already uses (`station.stand_for`), which ranks poses by their margin in millimetres against the dock's capture range. Moving a station is an edit to the floor map, not a re-teach.
- **Navigation.** Paths come from `nav.plan` on a costmap of the room built from the floor plan. The robot localises from wheel odometry and fiducial markers on the floor or walls, and the dock's camera corrects it over the last metre. Mecanum wheels let it slide sideways into a dock instead of shuffling.
- **One robot carries the volume.** Each tray makes about six to eight trips between print farm and outbound, shared by the bats on it, so a bat costs about two robot moves: a few minutes of robot time against a takt of 29 to 96 minutes (estimate).
- **But one robot is a single point of failure.** Every station's input and output buffers are sized to keep it working through a robot outage of the length you choose. A second robot then buys redundancy rather than throughput, and the fleet executive already in the code (`fleet.py`) handles two robots sharing narrow aisles.
- **Its own battery.** The robot charges at a dock between jobs, and the scheduler plans around its charge like any other resource. A LiFePO4 pack keeps the fire risk low; it is the least fire-prone common lithium chemistry.

## Calibration: the camera rig is the reference

The calibration cell needs neither a precise clamp nor a precise gimbal. The multi-view cameras measure where the bat actually is, at every moment, in 6-DOF, and the calibration fits the IMU's errors against that measured truth.

**What happens to each bat** takes a few minutes, mostly gimbal motion (estimate):

1. **Power and data.** The pogo block on the gimbal's clamp powers the board through a slip ring. The bat streams over Bluetooth, the link it will use in play.
2. **Geometry.** The cameras measure the bat's axis, its length, the sweet spot, and the two bands' positions and colours. These define the bat frame the game uses.
3. **Accelerometer.** The gimbal holds the bat still in a set of orientations, where gravity is the only input. The cameras measure each orientation, and a least-squares fit gives each axis's bias, scale and cross-axis error (the standard multi-position method). The same still periods give the gyro's bias and its sensitivity to gravity.
4. **Gyroscope.** The gimbal spins the bat through whole turns about each axis. The angle turned is known exactly from the counted turns, which the cameras confirm, so the fit gives each gyro axis's scale and cross-axis error.
5. **Mounting.** A spin about the bat's own long axis shows which direction the IMU takes as "along the bat", so the board's angle in the bat is measured, not assumed.
6. **Lever arm.** A spin with the IMU off the spin axis produces a centripetal acceleration that grows with its distance from the axis. With the cameras' geometry, that places the IMU relative to the sweet spot and the bands.
7. **Timing.** The offset between the bat's clock and the cameras' clock is estimated from the motion itself, by matching the gyro's rate to the rate the cameras see, as open-source camera-IMU calibrators such as Kalibr do.

**The target.** The simulation's 6 to 12 mm result assumed these residuals after calibration: gyro bias 0.02 dps, scale and cross-axis 0.05 %, accelerometer bias 2 mg, mounting 0.2°, lever arm 0.5 mm. Before any hardware exists, a check plants known errors in a simulated IMU, runs the gimbal plan through a camera model, and requires the fit to recover them to these values. Bias also drifts with temperature and each power-up, so the game keeps re-learning it in play; the factory's job is the terms that drift little.

**Keeping the rig honest.** Each shift starts with a golden bat, a reference bat measured many times. If its numbers move by more than the rig's own measured repeatability, the cell stops calibrating and messages you, rather than shipping bats calibrated by a drifting rig. The cameras are recalibrated against a target on the same trigger.

**Stored on the bat**, in its flash and in the factory database under its serial:

- serial number, firmware version, calibration date and temperature
- gyro and accelerometer bias, scale and cross-axis terms, and the gyro's gravity sensitivity
- the IMU's rotation and position in the bat frame
- the bat's geometry: axis, length, sweet spot, and the two bands' positions and colours
- a checksum

The game reads this record over Bluetooth when the bat pairs. The factory copy lets a corrupted record be restored, and lets a returned bat be compared with its day of manufacture.

## Testing: every bat slowly, a sample at full speed

**Every bat** is tested in the finishing cell straight after calibration:

- **Pairing.** A factory iPhone running the real app pairs with the bat and reads its calibration back.
- **Bands at playing distance.** The iPhone must find both bands from where a player's phone would stand. A mirror can fold that distance into the cell.
- **A slow fused swing.** The arm moves the bat along a slow path while the app fuses the IMU with its camera. The multi-view rig measures the same motion, and the fused sweet spot must agree with it within the product's accuracy budget for that speed. The limit comes from the budget, never from a number picked to pass.
- **Current draw**, asleep and streaming, measured through the pogo block. This catches a board that would flatten its cells early.

**A sample at full speed.** The arm cannot swing a bat at 20 to 30 m/s, so an enclosed swing rig beside the cell does. A motor swings the bat through a full arc while your Pi stereo rig, at high frame rate and short exposure, measures the true sweet spot to compare with the bat's own estimate.

During the swing the bat runs from a dummy pack of two AA-sized supercapacitors, weighted like two AA cells, which the rig charges. So the line still handles no batteries, and the swing still tests the contacts for bounce.

The first bat of each batch is sampled. After that, the sampling rate is set from how much bats turn out to differ, once a few hundred have been measured. Every result goes into the bat's record.

## Running with nobody there

- **One record per bat.** Each bat's record moves through fixed states: core printed, frame wound, cured, sleeved, electronics in, calibrated, tested, packed, then shipped or rejected. Every station writes what it measured. If the controller restarts, it rebuilds the line's state from the records and the tray tags.
- **Build to stock, finish to order.** Frames are made ahead whenever the frame cell is free. An order starts at the sleeve with its artwork, so it waits only for steps 4 to 8.
- **Who moves what next.** Stations, docks, mandrels and the robot are resources, and transport jobs are allocated by auction over one shared task list, as the repo's rules require. With one robot this reduces to a priority queue, and it extends to two unchanged. Travel times come from the path planner with a measured pace factor, never from a table.
- **Buffers instead of babysitting.** Buffer sizes are computed from the stations' cycle times and the longest outage you want the line to ride through, not picked. The stores hold enough for the time between your visits, and you get a reorder message when stock falls to a supplier's lead time.
- **Nothing hangs.** Every action has a timeout, the rule the competition robot's missions already follow. A step retries once only where a retry is safe, such as re-docking a tray. Otherwise the bat goes to the reject rack with its record, the station runs its own self-check, you get a phone notification, and the line carries on.
- **Stop only what threatens many bats.** A station that fails its self-check takes itself offline. A golden-bat failure stops calibration. A safety fault stops everything.
- **Safe when empty.** No cells are on the line. The printers, and the cure rack if it is heated, have independent thermal cut-outs, and a smoke detector cuts the power and messages you.
- **Visible from your phone.** The records and a camera view of the line are on your phone.

What you still do: restock the stores, empty the outbound and reject racks, and maintain the machines, on your own schedule.

## Capacity and cycle time

At 16 hours a day, 300 bats a month is one every 96 minutes, and 1,000 a month is one every 29 minutes. The times below are planning estimates unless marked as coming from the repo, and each is replaced by a measurement as its station is built.

| Station | Time per bat | At 300 a month | At 1,000 a month |
| --- | --- | --- | --- |
| Print farm | about 2 hours of printing, if a core and its caps print together (estimate) | 2 printers | 5 printers |
| Frame cell | not yet planned for a bat; the 300 mm test truss simulates at 9.4 min and the 1 m truss plans at 24.1 min (repo) | 1 cell | 1 cell, if the bat frame plans under 29 min |
| Cure rack | off the cell; set by the epoxy | mandrels = cure time ÷ takt, plus one | same rule |
| Sleeve | a few minutes of fitting; printing runs in batches (estimate) | 1 | 1 |
| Finishing cell | 5 to 10 min, mostly gimbal time (estimate) | 1 arm | 1 arm |
| Robot | about 2 moves per bat (estimate) | 1 | 1, plus 1 for redundancy |

Printers needed = printing hours per bat ÷ takt in hours, rounded up.

**What it means.** At 300 a month every station has slack, which leaves room for retries, maintenance and rejects. At 1,000 a month the printers and the frame cell set the pace, and both scale by adding a machine rather than by redesigning. Before anything is built, the whole line runs as a fast simulation with no physics, at both volumes and with robot outages and rejects injected, to size the buffers.

## How it maps onto the existing code

The line becomes a third fixture for the same codebase, beside the competition robot (`sim/rfgyc26`) and the truss cell (`sim/truss`). Most of the hard parts already exist in a general form. My default is a new package, `sim/batline`, with its own spec, hardware layer, model and check suite.

| Part of the line | Reuses | New work |
| --- | --- | --- |
| Frame cell | all of `sim/truss`: `spec`, `structure`, `fixture`, `collapse`, `approach`, `schedule`, `motion`, `process`, `hal`, `cell`, `vision`, `inspector` | the bat as a truss spec, swing loads in place of camera loads, the handle core as a fixture part |
| Docking | `station.stand_for` and `station.reachable` | the dock as the region, the lift as the effector, robot plus tray as the footprint |
| Robot transport | `nav` (its costmap already takes a size), `world`, `trajectory`, `estimator` | the workshop's floor map, and mecanum kinematics, since both competition robots are differential drive |
| A second robot | `fleet`: reservations, live avoidance, priority | aisles as the shared resources |
| Scheduling | the pattern of `planner` (an exact solver over a small task set) and the auction rule in `CLAUDE.md` | a flow-shop scheduler with buffers, with travel times from `nav.plan` and a measured pace factor |
| Calibration cell | the IMU error model from the fusion simulation (`imu_fusion_sim.py`, in this folder) as the simulated bat, and the two-implementation camera pattern of `truss/vision.py` | the gimbal, the calibration fit, the stored record |
| Test verdicts | `truss/inspector` and `rfgyc26/referee`: a pure function of what was measured against an acceptance table | the bat's acceptance table, from the accuracy budget |
| Hardware layer | both `hal.py` contracts: one file, a simulator backend and a machine backend, raise rather than lie | gimbal, pogo link, camera rig, arm, robot lift, printers |
| Review | `truss/filmstrip.py` contact sheets | none |

**New checks, each one a rig that can fail:**

- `check_calibration` plants known errors in a simulated IMU, runs the gimbal plan through the camera model, and requires the fit to recover them within the calibrated budget.
- `check_dock` compares the robot's arrival error, from the estimator, with the dock's capture range, as a margin in millimetres.
- `check_tray` measures the kinematic coupling's repeatability in MuJoCo, a mechanism question where physics earns its cost.
- `check_line` runs the whole line as a fast event model at 300 and 1,000 a month, with outages and rejects injected, and reports buffer levels and missed takt.

The repo's rules carry over unchanged: no dock pose, path, buffer size or pass limit is written by hand. Each is computed from the specs of the bat, the machines and the floor, so a new bat size is a new spec, not a re-tune.

## Build order

Each step replaces hand work, so bats can ship before the whole line exists.

1. **Measure real swings.** Put a ±32 g / ±4000 dps IMU logger in a prop bat, and film swings with the iPhone and your Pi stereo rig. This settles the IMU part, the accelerations the bat must survive, and how close the fusion gets to the simulation. It is the cheapest step, and every later one depends on it.
2. **The calibration cell, hand-loaded.** Gimbal, multi-view rig, calibration fit and golden bat. Prove that calibration buys the accuracy the simulation promised, by comparing calibrated and uncalibrated bats on the stereo swing test. This is the IP, so it comes first.
3. **The bat, designed for the robot.** Printed core, board slot, pogo access at the pommel end, sleeve. Hand-assemble the first 10 to 20 bats and put them in players' hands.
4. **Sleeve fitting**, prototyped alongside step 3, because it is the riskiest station.
5. **The frame cell for the bat**: the bat as a truss spec, the mandrel with the core, the cure rack.
6. **The finishing cell's arm**: board insertion, gimbal loading, the slow test swing and packing.
7. **Robot, trays and docks**, developed on the fast simulated line first, then on the floor.
8. **Stores and racks**, with stock counts and reorder messages.
9. **Unattended runs**: a watched overnight run, then unwatched ones, logging every stop and reject.

## Risks and open questions

**Risks, most serious first:**

- **Fabric handling.** Fitting a stretchy sleeve by machine is the step most likely to fail. If it cannot be made reliable, the fallback is printed panels that clip onto the frame.
- **Swings harsher than modelled.** More acceleration means more error, possible IMU saturation, and AA cells bouncing on their springs. Build step 1 measures this.
- **Carbon near the antenna.** Carbon fibre conducts and can weaken a 2.4 GHz antenna. Keep the antenna in the printed handle, clear of the chords, and test range early.
- **Heading at home.** The largest error in the simulation is the IMU's heading relative to the customer's phone. The factory cannot calibrate it, so the game must re-estimate it on every swing.
- **The robot and the floor.** Mecanum rollers dislike uneven or dusty floors, and one robot is a single point of failure. A sealed, clean floor and buffers sized for an outage cover both.
- **A frame the head can wind.** The winding ring sets a minimum truss section; the 300 mm test truss needed a 66 mm side. The bat's shape has to pass the existing clearance check before it is committed.
- **Epoxy cure** sets the number of mandrels and how long frames take to reach stock, so choose the epoxy with that in mind.
- **Radio approval.** Selling a Bluetooth product in India needs WPC approval; check what a pre-certified module on the bought board covers. I have not verified the current rules.
- **Google TV.** Whether the Streamer accepts a custom Bluetooth LE peripheral is unverified. The iPhone path works either way, at a slightly longer connection interval.

**Open questions for you:**

- **Bat sizes.** Kid and adult? Each is a spec rather than a redesign, but each needs its own tray cradles and mandrels.
- **Battery count.** Two AA in series suit the board directly. Three or four would need a regulator and add about 23 g per cell, so two is my default.
- **How long the line runs between your visits.** Overnight, a weekend or a week sets the size of every buffer and store.
