Chandanpanda/ART-Forum-2017-Stan-Tutorial/sim/batline/m4_review.md

# M4 adversarial review: open findings

Four reviewers read the M4 changes (the board and link, the factory iPhone's test, the swing rig, and their integration into the line), and a skeptic per area tried to refute each finding. These 38 survived, 7 of them blocking. None is fixed in the commit that adds this file. Each entry gives where, what, and the fix the skeptic agreed with (or corrected).

## Blocking

1. **Station 2's hold-up step only ever sees the base draw: undersized capacitors pass** (`board/procedures.py:402`, board)

   _holdup opens the supply 2*ci after the INFO answer arrives. That answer reaches the host about 1-6 ms after a connection event (dongle floor 1 ms plus 0.5 ms exponential spread). So the 10 ms open always ends before the next event at 15 ms, and no radio event or resent packet ever falls inside it. power.holdup_c_needed sizes the part for that event and those packets: 43 uC, 206 uF. The step only checks the ~7.6 uC the IMU and idle draw take. It cannot refuse a capacitor anywhere above about 40 uF. The planted fault is 10 uF (sim.FAULTS['no_holdup']), so small that the base draw alone browns it out, so check 11 cannot show this gap.

   Fix: Measure the capacitance directly. With the board in a steady state whose current the SMU has just read, open the supply and time it to reset (or read the droop). Compute C = I*t/(V0 - v_min). Accept only if the guard-banded value, C*(1 - Smu.ACC) less its floor (as power.accept does), is at least power.holdup_c_needed. Compare with holdup_c_needed itself, not holdup_c_needed/(1-HOLD_TOL): the measurement already is the part's actual value. Alternatively, inject the worst case explicitly: an open spanning an anchor with the queue pre-loaded to window_charge's 'sent' packets. Also add a planted fault with a capacitor just under holdup_c_needed (e.g. 0.8-0.9x), so check 11 shows the step catching an undersized part, not just a missing one.

   Skeptic: Confirmed. Probe over seeds 50000+ with draw_board(rng,'no_holdup',C): the hold-up step passed 12 of 12 boards at 40, 60, 100 and 150 uF. It starts refusing only at about 30-35 uF. The derived requirement is 206 uF (window_charge 43.3 uC over 0.21 V). Tracing the open: no connection event fell inside it in any run, and it started 1.5-3.1 ms after the last event. The open starts 2*ci after the INFO answer arrives (event + air + 1 ms dongle floor + exp(0.5 ms)), so the 10 ms open ends before the next event 15 ms later. The charge drawn during the open was 5.4-7.9 uC, i.e. base draw only. Check 11 cannot see this because the planted 10 uF part fails on base draw alone. One correction to the proposed fix: opening across an anchor with the bat streaming still would not reach the derivation's worst case. In 10 ms the stream makes only about one packet, while window_charge assumes 3 sends, 2 of them resent losses. That would refuse only parts below about 110 uF.

2. **Planted 'tilted' fault is caught only by the luck of one seed: station 2 misses it about half the time** (`../scripts/batline/check_link.py:535`, board)

   The bat lies in a V cradle with its roll free (Lying.roll uniform over 0-360 deg). The 'gravity along' test reads only the component along the bat's axis. A board seated 10 deg off about bat-y adds -sin(10 deg)*cos(roll) to that reading. When the roll puts gravity near the tilt axis, |cos(roll)| < 0.55 and the reading stays inside the 0.095 g limit, so the mis-seated board passes every step. Check 11 runs each fault once, on seed 100+i. Seed 111 has roll 158 deg, which happens to expose the tilt, so the check passes while station 2 cannot reliably see a mis-seated board. The same single-seed design makes the step names fragile: accel_range is refused at 'gravity along' instead of 'gravity size' on another seed.

   Fix: Make the seat pitch observable at any roll: key the cradle's roll, or take the still reading at a second roll about 90 deg away and test the tilt from both readings. In check 11, run each planted fault over many seeds and poses. Require the miss rate to be no worse than the step's designed power at the binomial's Z tail (binomial_least), not one seed per fault.

   Skeptic: Confirmed. Board.IMU_AXES is the identity, the cradle's roll is uniform over 0-360 deg, and 'gravity along' reads only a@along_axis + sin(pitch). A tilt about bat-y shows up as about sin(10 deg)*cos(roll), which is zero at roll 90/270 for any tilt size. A healthy board can match the other two components at some roll, so with an unknown roll the along component is the only thing that discriminates. Probe of run_station's draw at seeds 111+1000*j, j=0..19: 9 of 20 tilted boards passed station 2 outright (ok True, last step 'sleep current'). For example seed 3111 (roll 298, along -0.092), 8111 (roll 77, -0.062) and 19111 (roll 82, -0.0035), all against a limit of 0.0951 g. Check 11's own seed, 111 (roll 158), reads 0.124 and is refused, so the check passes on the luck of one seed.

3. **Hold-up derivation applies the radio's 3 V DC/DC currents at 1.92-1.71 V** (`board/power.py:177`, board)

   spec.Mcu says its currents are typical 'at 3 V on the DC/DC'. The board runs straight from the cells (no regulator ahead of it), and window_charge, holdup_s and holdup_c_needed spend those currents and charges (Q_EVENT, Q_NOTIFY, I_TX, I_CPU, I_IDLE) unchanged while the capacitor falls from v_hold = 1.92 V to v_min = 1.71 V. A buck converter draws roughly constant input power, so input current scales with about 3 V / V_in, which is 1.56-1.75x at these voltages. On the internal LDO the currents are larger still. The firmware sim draws the same constants, so check 6 agrees with the derivation and cannot catch it. A smaller effect pushes the same way: v_hold is the cells' open-circuit voltage, but the capacitor starts at N*(V_oc - I*R_cell), and power.py itself models R_cell at 0.705 ohm a cell at 90 %. That costs 2-15 mV of the 210 mV budget.

   Fix: Give the Mcu currents their reference voltage (V_REF = 3.0). In window_charge/holdup_s, treat the MCU's draw as constant power, I*V_REF/V, and integrate from v0 down to v_min. Do the same in firmware._drain (base current) and pulse (charge scaled by V_REF/v), so check 6 exercises it. Keep the IMU's I_RUN constant. Optionally start v0 at N*(V_oc - I_mean*R_cell). Then re-derive HOLD_C: by these numbers the next E6 value whose low tolerance clears the need, 470 uF.

   Skeptic: Confirmed. spec.Mcu states its currents are typical 'at 3 V on the DC/DC', and Q_EVENT/Q_NOTIFY come from a development kit, also at 3 V. power.window_charge/holdup_s/holdup_c_needed and firmware._drain/pulse spend them unchanged between v_hold = 1.92 V and v_min = 1.71 V. Decomposition of the 10 ms window: IMU 7.00 uC, MCU 36.32 uC. With only the MCU part scaled by 3/V: x1.56 gives 63.8 uC, so 304 uF is needed; x1.75 gives 70.7 uC, so 337 uF. The low-tolerance part is 264 uF. Integrating C dV/dt = -(I_imu + P_mcu/V) with P_mcu taken at 3 V: 264 uF rides 8.27 ms and 330 uF rides 10.34 ms, against Rules.BOUNCE_S = 10 ms. The firmware sim uses the same constants, so check 6 agrees with the derivation and cannot catch it. The LDO alternative is worse still. The cell-resistance point is real but small: 0.705 ohm a cell at HOLD_LIFE costs about 2 mV at the 1.65 mA mean.

4. **Check 9's must-fail is an algebraic identity and does not run the check's test** (`../scripts/batline/check_swing.py:363`, swing)

   Check 9 passes when `pull < SR.spring_force(d, SR.SHORTEST)`. Its must-fail never calls spring_force and never uses the shortest pair. It multiplies weak_rate(d) by the dummy pack's spring length, and that product is 0.5*n*m*F_MAX by the definition of weak_rate. pull = (n*m + tip)*F_MAX is always at least twice that, so `not pull < fw` is true for every spring, geometry, F_MAX and spring_force implementation. The must-fail cannot fail, which breaks the suite's own rule that the same test must reject a wrong variant.

   Fix: Run the passing comparison on the wrong spring: `with patched(CapSpring, RATE=weak_rate(d, SR.SHORTEST)): fw = SR.spring_force(d, SR.SHORTEST)`, then `check(..., not pull < fw)`. The value still comes out as 0.5*n*m*F_MAX by construction (probe: 0.195 N), but the must-fail now goes through the same spring_force, the same pack and the same inequality as the passing check. A spring_force that ignored RATE or the pack's seated length would then make it fail.

   Skeptic: Confirmed. weak_rate(d) defaults to the DUMMY pack, so fw = weak_rate(d)*(L_FREE - seated(d, DUMMY)[1]) is exactly 0.5*n*m*1e-3*F_MAX. Probe: fw = 0.195348 N, and 0.5*n*m*F_MAX*1e-3 = 0.195348 N. pull = (n*m + MASS/3)*1e-3*F_MAX = 0.3921 N, a ratio of 2.007. Because SHORTEST.m == DUMMY.m == Cell.MASS, `not pull < fw` holds for any F_MAX > 0 and any spring constants. The must-fail never calls spring_force and never uses the SHORTEST geometry the passing test uses, so it cannot fail and tells us nothing about check 9's test. That breaks the suite's own must-fail rule (header lines 15-17).

5. **Check 5: tolerances with no stated origin, a must-fail that misses the insensitivity half, and stiffness misdescribed** (`../scripts/batline/check_swing.py:303`, swing)

   (a) `rest` uses 1e-3*fs and `moved < 1e-2`. Neither number fits the origins the suite header allows (float rounding, a differencing step, a drive cycle, a Monte Carlo standard error), and neither says where it comes from. (b) The must-fail only shows that settle() raises ValueError with RING/2. Nothing makes the 'a softer contact changes nothing' comparison (`moved < 1e-2`) fail. If settle failed in the passing branch, `s.settle(MO.park)` would crash the suite with a traceback instead of reporting a FAIL. (c) The docstring says doubling sim.RING halves the contact stiffness. solref timeconst = RING*dt/zeta, and MuJoCo's k = d/(dmax^2*timeconst^2*dampratio^2), so doubling RING quarters the stiffness and halves the natural frequency. The 'twice as stiff' must-fail is really 4x as stiff.

   Fix: Derive the insensitivity tolerance from what it protects: for example, require the change in the run's least + plate force to stay under that force's margin above zero (check 8's criterion), stated as such. Give that half its own must-fail: a contact model that does move the least force, run through the same `moved` comparison. Wrap the passing branch's settle/run in try/except ValueError and report FAIL. Reword to 'quartering the contacts' stiffness (sim.RING doubled)' and 'the contacts four times as stiff (RING halved)', and fix the detail string.

   Skeptic: (a) `rest` uses `<= 1e-3*fs` and the insensitivity half uses `moved < 1e-2`. Neither states an origin, and neither fits the origins the suite header says every tolerance has (float rounding, a differencing step, a drive cycle, an MC standard error). The 1e-3 only repeats settle()'s own hand-set stop criterion. (b) Confirmed in the code: the must-fail only checks that settle raises with RING/2. Nothing shows `moved < 1e-2` rejecting anything. settle at line 300 and run_of are not wrapped, so a settle failure in the passing branch gives a traceback, not a FAIL. That still exits non-zero, so this part is robustness only. Probe: with RING=2, settle raises and ends with contact forces [0.0, 1.239] N, as reported. (c) solref = (RING*dt/zeta, zeta), and MuJoCo's k = d/(dmax^2*timeconst^2*dampratio^2) = d/(dmax^2*RING^2*dt^2). Doubling RING therefore quarters the stiffness, and RING/2 makes it four times as stiff, not twice. The header (lines 39-43) and the detail string ('twice the softness') are wrong. (c) on its own is a minor docstring fix; (a) and (b) break the stated tolerance-origin and must-fail rules.

6. **The swing rig is timed at the gimbal's clamp and has no floor space or gantry reach** (`line.py:503`, integration)

   Station 4's new 'swing' job loads the bat into the swing rig using `load`, which is the transfer from the slots to the gimbal's own fixture centre F, with the gimbal's rise. The station's footprint and `around` come only from the gimbal rig (`rig.footprint()`, `rig.reach()`). Nothing in line.py or swing/rig.py gives the swing rig a footprint, an enclosure or a clamp pose. As a result the floor plan, the station's reach (h.points) and the module travel derived from it (station_spec.from_line) all leave out a machine that sweeps a disc about 2.2 m across, which the README places 'beside the cell'. The comment 'its clamp where the head reaches as it reaches the gimbal's' sets the station pose by hand, and that pose is physically impossible because the gimbal already occupies that point.

   Fix: In swing/rig.py, derive the rig's envelope: the disc swept about Rig.hub, radius rig.L plus the hands-to-tip length plus the enclosure clearance, and the hub height that disc needs above the floor. Also derive the clamp's pose at Motion.park (hub + L(cos phi0, sin phi0), bat level). In line._layout, place it beside the gimbal, either widening station 4's footprint or adding it as its own floor item. Time the swing job's load and unload as h.transfer(slot, swing_clamp_uv, swing_rise) so that point enters h.points and st.reach. Give from_line a region for the rig's clamp so the module's travel covers it.

   Skeptic: Confirmed in line.py:476-509. Station 4's footprint and `around` come only from rig_spec.design(d) (the gimbal and its cameras). The new swing job times its load and unload with `load = _mean_transfer(h, slots, F, rise)`, the gimbal clamp's transfer and rise. station_spec.from_line (station/spec.py:752-791) builds regions only from the docks and the gimbal's `st.work`, so no module region, travel, footprint or floor_plan item contains a swing rig. A probe on KID gives L = 0.465 m, hub [0.002, 0.470] m and 629 mm from the hands to the tip, so the arm and bat sweep a disc of about 1.09 m radius. Nothing in swing/rig.py gives a hub height, a clamp pose or an enclosure. The comment 'its clamp where the head reaches as it reaches the gimbal's' stands in for a station pose that CLAUDE.md says must be computed. floor_plan therefore also leaves out a machine about 2.2 m across from the aisle length and the robot's trips. One caveat: the claim that the pose is 'physically impossible' reads too much into the comment, which more likely means 'at the same transfer cost'. The defect is that the pose is never computed. Also note that M2 already left the rig off the floor (an est op). M4 newly borrows the gimbal's pose for its timing.

7. **The iPhone test leaves the gimbal at q_b; the gantry unloads at the zeros and no move back is planned** (`phone/test.py:416`, integration)

   iphone_test moves the gimbal from its zeros to q_a, swings it to q_b, judges, and returns. Nothing brings the gimbal back to the zeros. imu/plan.py says the station's tour 'ends back at the zeros, where the gantry unloads the parked gimbal'. line.py goes straight from the iPhone test to 'the bat back into its slot'. The production procedure therefore hands the gantry a clamp tilted about 29 degrees. The plan() that line.py books also leaves out that move, which is about 0.8 s per bat.

   Fix: In iphone_test, after the verdict is decided on either path (a try/finally around the body, before disconnect), add home = K.Path(st.gimbal.encoders()).move(np.zeros(2), sp.lim.w_max, sp.lim.a_max, tag='home'); st.gimbal.run(home); st.clock.wait(home.T + settle_at_zeros), with the settle from kin.settle at the zeros' w_n (sp.settle was computed at q_a). Add a 'parks' entry to plan(): K.Path(sp.q_b).move(zeros, ...).T + that settle, and update the SwingPlan docstring to say the test ends at the zeros. check_link's timing check then covers it.

   Skeptic: Confirmed. In iphone_test (phone/test.py:390-423) the only gimbal motions are to_a (encoders to q_a) and sp.swing (q_a to q_b). Both the pass return (line 417) and the _Fail path (418-423) end with the gimbal wherever it is. No production code anywhere moves the gimbal back: grep finds encoders() used only in phone/test.py. imu/plan.py's module docstring makes the tour end 'back at the zeros, where the gantry unloads the parked gimbal', and line.py follows the iPhone test directly with 'the bat back into its slot' timed to the parked clamp F. M4 put the test between the tour and the unload and so broke that invariant. plan() (line 432) books only to_a.T + settle + 2 req + record_s. Probe (KID): q_b = [0, 0.510] rad, the home move = 0.820 s, and plan_s = 4.42 s, so the test's plan is about 19% short. check_link 25 cannot see this because the simulated procedure omits the same move.

## Minor

1. **Clock offset is held to Quality.SYNC_S only at the window's mean counter, the most favourable point** (`../scripts/batline/check_link.py:754`, board)

   recovered() measures the offset error only at cm.k0, the mean counter, where the envelope's error is smallest. sync.envelope_rms, and so packets_needed and listen_s, measure the error at the same point (err = t0 - k0/spp*dt). The ClockMap is used across the whole window, though. phone/app.fuse reads cm.at(k[0]) and cm.at(k[s]) at the stance, which starts at the window's first sample. The study applies sync_ms at the contact sample k_c. Away from k0 the rate error adds to the offset, and the error passes SYNC_S. Check 17 cannot see this, and the stream length is sized on it.

   Fix: Hold the error where the map is read. Have envelope_rms (and check 17) report the error at the span's ends, or the worst over the span the consumer uses, and size packets_needed/listen_s on that. Alternatively, have the app or game recover the clock from a window centred on the samples it reads (stance end or contact), and say in sync's docstring that SYNC_S holds at the window's mean counter.

   Skeptic: The facts check out. recovered() takes the error at cm.k0, and envelope_rms takes it at k0 too (err = t0 - k0/spp*dt). A Monte Carlo of sync's own model at packets_needed (phone n=176, 3000 trials) gives an RMS of 0.955 ms at k0, 1.231 ms at the first sample and 1.244 ms at the last. Dongle n=23: 1.008 / 1.718 / 1.301 ms. SYNC_S is 1.0 ms. app.fuse reads cm.at(k[0]) and cm.at(k[s]) with spare = Z*SYNC_S, so the spare assumes SYNC_S where the error is about 25 % larger. Downgraded to minor: in this milestone the map only selects stance frames. With Z=4 the spare is still about 3.2 sigma, k[s] already sits before motion (mv[0] - mem), and the fused sweet spot does not use the clock at contact. The gap matters for the game, where the contact is read near the window's end, and for sync's docstring, which says the recovered clock is held to SYNC_S.

2. **packets_needed bisects on Monte Carlo noise; the dongle's n=23 misses the sync budget** (`board/sync.py:185`, board)

   envelope_rms runs 200 trials with a different seed for each n (12345 + n), so its value moves by several percent and is not monotone in n. packets_needed doubles, then bisects for the first n whose noisy estimate falls under the budget, which favours an underestimate. For the dongle it returns 23, but a precise estimate at n=23 is over the budget. The phone's 176 is fine (0.955 ms), but only just.

   Fix: Use common random numbers: one seed, independent of n, drawing the same per-trial stream prefix. Run enough trials that the estimate's standard error is a small share of the budget. Compare rms + Z*se (the rms's standard error from the trials) with the budget, so the noise cannot favour an underestimate.

   Skeptic: Confirmed. envelope_rms seeds with 12345+n at 200 trials. Dongle values: 22:1.042 23:0.949 24:0.966 25:1.041 26:0.888 ms, which is not monotone in n. packets_needed returns 23 for the dongle, but at 5000 trials n=23 gives 1.011 ms against a budget of sqrt(SYNC_S^2 - HOST_FLOOR_SD^2) = 0.980 ms. The true first n under budget is about 24-25. The phone's 176 measures 0.950 ms at 3000 trials, so it passes but with little margin. At 200 trials n=180 reads 0.996 and n=170 reads 0.971, so the bisection's answer is noise-driven.

3. **Check 14's 'power lost mid-commit' cuts power before the commit reaches the bat** (`../scripts/batline/check_link.py:663`, board)

   brown() opens the circuit 1 us after the REC_COMMIT request is issued, with hold_c = 1 uF. The next connection event's Q_EVENT pulse browns the board out before the central's slot delivers the commit, so the firmware never receives that commit. What the scenario really tests is losing the staged buffer, not a cut between the page erase and the write. That case is covered only at firmware level, in check 7, without BleLink's retry.

   Fix: Cut from the firmware's receipt of the commit: wrap fw._commit to call open_circuit(t + Mcu.ERASE_PAGE_S/2, t + 0.15) after the original runs. Use a hold_c that survives the event pulses until then, or schedule the open inside the erase so the next pulse lands in it. Assert that a commit ran before the brown-out with its target page erased, and that the retry then restored the record.

   Skeptic: Confirmed by code and probe. brown() opens the circuit 1 us after the REC_COMMIT request is queued, with hold_c = 1 uF. At the next event, the central's fw.pulse(Q_EVENT) (5.5 uC on 1 uF) browns the board out before the slot delivers the commit. Probe: cut at 3.0549 s, browned at 3.0609 s, and the only _commit ran at 3.7527 s (boots 3, after 1 brown-out), with 1 retry. So the scenario tests a staged buffer lost to a brown-out plus BleLink's retry. It does not test a cut between erase and write, which the code comment ('browns it out inside the commit') and the check's name claim.

4. **Packet make-time (Firmware.CPU_PACKET_S) is missing from both the sim and sync's delay floor** (`board/firmware.py:296`, board)

   The firmware charges q_cpu but queues the packet at the instant of its last sample. spec.Firmware.CPU_PACKET_S says the CPU spends 0.3 ms reading the FIFO and handing the packet to the stack. sync.floor = HOST_FLOOR_S + link_floor leaves that time out too: the host floor's lab method times from the bat sending, not from the sample. On real hardware the recovered sample times would be at least 0.3 ms late, 30 % of SYNC_S. Check 17 cannot see the bias because the sim omits the same delay.

   Fix: Queue the packet at t + FW.CPU_PACKET_S in firmware.py. Add the bat's make time to sync.floor, or define HOST_FLOOR_S's lab measurement as starting from the sample, and keep the two consistent.

   Skeptic: Confirmed. firmware._on_event charges pulse(P.q_cpu()) but queues the packet at t, the time of its last sample: self.txq.append((t, "stream", pk, None)). spec.Firmware.CPU_PACKET_S (0.3 ms) is the time spent reading the FIFO and handing the packet to the stack. sync.floor = HOST_FLOOR_S + link_floor counts from the event's opening (link air) and from air to callback (host), so the bat-side make time is in neither. On hardware the lower envelope would sit at least 0.3 ms late, and check 17 cannot see that because the sim omits the same delay.

5. **Flash retry re-programs without erasing, breaking SwdHAL.program's 'erased' precondition** (`board/procedures.py:281`, board)

   _flash calls erase_all once, then program(0, img) up to twice. The second program writes over programmed flash. Flash programming can only clear bits, and SwdHAL.program's contract says '(word-aligned, erased)'. SimSwd.program's image path simply overwrites (fw.image = data), while its UICR path correctly ANDs. So the sim accepts a retry that real flash would not, for a bit wrongly programmed to 0.

   Fix: Erase before the retry (erase_all, or the image's pages), and re-write the serial afterwards if the retry needs erase_all. Make SimSwd.program AND the image into what is there (erased = 0xFF, starting from fw.image or all-0xFF), so a retry without an erase shows its effect.

   Skeptic: Confirmed. _flash calls st.swd.erase_all() once, then program(0, img) up to twice. SwdHAL.program's contract is '(word-aligned, erased)'. Real flash can only clear bits, so a retry over programmed words cannot repair a bit wrongly left at 0. SimSwd.program overwrites the image (fw.image = data) but ANDs in the UICR path, so the sim accepts a retry real flash would not. Check 11 is unaffected because image_flip corrupts every write.

6. **Check 2's must-fail runs a different, stricter test than the check** (`../scripts/batline/check_link.py:287`, board)

   The passing test counts bursts of windows over window_charge and compares the count with binomial_most(n_win, TAIL, TAIL). The must-fail checks got.max() <= mean*w, which fails on any single window over the bound. It does not show that the burst-count test rejects a wrong bound, which is the standard the suite's docstring states.

   Fix: Compute the must-fail's episodes with the same burst-count code, using P.draw(ci).streaming*w in place of P.window_charge(w, ci, pe) (at the bounce window, or every window), and require episodes_mean > binomial_most(n_win, TAIL, TAIL).

   Skeptic: Confirmed. The check is `episodes <= most`, a burst count over window_charge(w) against binomial_most. The must-fail is `mean_ok &= got.max() <= P.draw(ci).streaming * w` at w == BOUNCE_S, which rejects on any single window over the bound. That is a different, stricter test, so it does not show that the burst-count test rejects a wrong bound. The suite docstring requires the same test.

7. **Tolerances with no stated origin (checks 13 and 18)** (`../scripts/batline/check_link.py:633`, board)

   Check 13 passes pairing if p.seconds <= timeout(plan)/2, which is 1.5x the plan, while its name says 'within its plan'. Where the /2 comes from is not stated. Check 18 compares with 1e-9 s, 1e-15, 1e-12 s and 1e-18, also with no stated origin; presumably float rounding of counters near 2^32, but not derived.

   Fix: Derive check 13's bound, for example plan + Z*sd of the pairing time from the host spread and the advertising phase, or hold it to timeout(plan) and say so. For check 18, assert exact equality (the inputs are identical after unwrap and trimming), or write the bounds as k*EPS times the magnitudes involved.

   Skeptic: Check 13's `p.seconds <= PR.timeout(plan) / 2.0` is 1.5x the plan, and nothing says where the /2 comes from. Check 18's 1e-9, 1e-15, 1e-12 and 1e-18 are not derived from EPS as the rest of the suite's rounding tolerances are. A probe shows all four differences are exactly 0.0, because the unwrapped or trimmed inputs are identical integer and float arrays, so those bounds are harmless but have no stated origin.

8. **Link.LL_OVERHEAD misstates the L2CAP header and leaves out ATT's** (`spec.py:259`, board)

   The comment counts 'the L2CAP header's 2'. The L2CAP basic header is 4 bytes (length and channel ID), and a notification also carries ATT's 3-byte opcode and handle, which notification_bytes() (MTU - 3) excludes. Around a 244-byte value the true on-air overhead is 22 bytes, not 17: 244 + 3 + 4 = 251 = LL_PAYLOAD. The empty PDU used in link_floor (air_s(0)) has no L2CAP header and no MIC. Air time and q_air are a few percent off, and link_floor is off by tens of us.

   Fix: Split the constant into the link layer's own bytes (preamble 2 + access address 4 + header 2 + CRC 3, plus MIC 4 on encrypted non-empty PDUs) and the per-notification L2CAP 4 + ATT 3. Use the first alone for empty PDUs and both for notifications and control writes, in power.air_s, sync.air_s and radio's slots. Correct the comment.

   Skeptic: The comment is wrong. The L2CAP basic header is 4 bytes, not 2, and the ATT notification's 3-byte opcode and handle are not counted (MTU 247 + L2CAP 4 = 251 = LL_PAYLOAD). An empty PDU carries neither L2CAP nor MIC, about 11 bytes, but air_s(0) charges 17. The stated impact is overstated, though. q_air does not use LL_OVERHEAD: it is the measured Q_NOTIFY plus value bytes over 20. In link_floor the overcounted empty PDU (+6 bytes) nearly cancels the undercounted notification (-5 bytes): the code gives 1376 us against about 1372 us encrypted (1356 us unencrypted), so it is off by 4-20 us, not tens. Per-notification air time is about 20 us (2 %) short.

9. **Stale docstring: firmware.py's separation is held by check_link 21, not check_imu** (`board/firmware.py:3`, board)

   The docstring says 'no procedure imports this (check_imu's separation scan holds it to that)'. check_imu's scan covers only imu/ production modules against imu's TRUTH set (scene, model, sim, judge). board/firmware is held by check_link's check 21.

   Fix: Change the docstring to say check_link's truth-separation check (21) holds it to that.

   Skeptic: Confirmed. firmware.py line 3 says 'check_imu's separation scan holds it to that'. check_imu's TRUTH is ("scene", "model", "sim", "judge") under batline.imu and its PRODUCTION covers only imu/ modules. batline.board.firmware is in check_link's TRUTH, so check 21 holds it.

10. **check_swing 15: the reference picture is wrong by about its own tolerance, and the tolerance is one frame's noise when the app averages ~118 frames** (`../scripts/batline/check_swing.py:470`, phone)

   Check 15 holds app.seen to the rendered band centroid within Phone.SIGMA_PX (0.5 px). Two problems.  (1) The reference picture is wrong on the toe band. product.py:1127 bounds the toe band's centre by x_tip1, so the 30 mm band (centre 749.2 mm) runs to 764.2 mm. That is 2.7 mm past x_tip0 = 761.5 mm, where the sleeve's rounding steps from 1.8 to 3.25 mm over the tip cap. mjcf.band_parts (mjcf.py:300) draws the band at the blade's section along its whole width, so in picture.py's render the last 2.7 mm of the band sit inside the thicker sleeve and are hidden.  Band 0 meanwhile shows a real along-axis shift of about 0.3 px that app.seen does not model. The sleeve past the band's inner end hides the band's far half there, so the visible band is its near half, pushed outward. Band 2 should show the same outward shift, but the truncation pulls it the other way. So the 0.21-0.33 px gaps the check reports mix a real unmodelled effect with a rendering error of the opposite sign. The gap is not app.seen's accuracy.  (2) The tolerance does not match how the centroid is used. The app averages n ≈ 118 still frames, so its centroid noise is 0.5/sqrt(118) ≈ 0.046 px. A systematic model error of up to 0.5 px (1.3 mm at 4 m, about 1.4 sigma of the anchor's Z sd of 0.98 mm) passes check 15 and is in no budget term. phone/sim.SimCamera reproduces app.seen to 0.03 px, so check 23 cannot see such an error either.

   Fix: In mjcf.band_parts, split each band's prism wherever the sleeve's section changes under it (x_blade0, x_tip0), each piece at the local outer rounding + INK. Re-measure check 15. Changing the toe band's placement to x_tip0 is a product decision and should not be done to fix the picture. Model the along-axis shift in app.seen and SimCamera: project the visible near half's mean depth, not the axis's. Then derive check 15's bound from what the app uses: the pose shift (J^T W J)^-1 J^T W (uv - got) held within a stated fraction of sqrt(diag(anchor_cov)), or the residual gap added to anchor_cov as a systematic term. Do not use one frame's SIGMA_PX.

   Skeptic: Confirmed. product.py:1127 puts the toe band's centre at x_tip1 - hb - tol = 749.2, so the band runs 734.2..764.2 mm, past x_tip0 = 761.505. The sleeve over the tip cap is rtri(R, 3.25). mjcf.band_parts draws the band at rtri(R, 1.0 + 0.8 + 0.15 = 1.95) along its whole width, so the last 2.7 mm are buried in the sleeve. I built the plan at the designed 58.4 deg turn (n_frames 117) and rendered check 15's five poses at full resolution. Band 2 covers 175-179 px against band 1's 194-197: about 9% fewer, the same share as 2.7 of 30 mm. Both gaps lie along the bat's axis toward the handle: band 1 -0.23 to -0.33 px, band 2 -0.20 to -0.27 px. Band 1 sits at u=875, left of centre, so its shift is outward. That fits the near half's perspective: the visible surface is about 12 mm nearer than the axis, giving f*X*dY/Y^2 ~ 0.25 px, which app.seen and SimCamera do not model. Band 2 sits at u=1045, right of centre, where the same effect should push it about +0.25 px. Losing 2.7 mm should pull it about -0.51 px, and the net matches the measured -0.23. So band 2's gap mixes a rendering error with an unmodelled effect of the opposite sign. Tolerance: anchor_cov's Z sd is 0.98 mm. A common-mode 0.5 px error shifts the pose by 1.33 mm (probe), enters no budget term, and passes check 15. Today it is about 0.2 sigma of the budget, and the check's outcome would not flip, so this is minor, not blocking.

11. **The docstring says the station commissions the phone's View against the rig; nothing does, and that error enters the test's error 1:1 with no budget term** (`phone/camera.py:16`, phone)

   camera.py says the station commissions where the phone stands against the rig (View.c, View.R), and test.py:66 calls sp.view the phone's commissioned pose. In fact SwingPlan.view is the design pose from test._plan_for's view_at.  That design pose is used three ways: as the app's frame, for the reference (test.py:412, ref = sp.view.level(...)), and as the simulated camera's true pose (phone/sim.py builds SimCamera with sp.view). So no commissioning step and no commissioning error exist anywhere: not in anchor_cov, not in the budget, not in the sim.  The anchor is measured in the real camera's frame while the reference goes through the assumed View. Any yaw or position error of the unfolded camera therefore shifts e directly, and check 23 cannot see it.  mirror_size, motion_px and still_speed, which the docstring says size the fold mirror and the still frame, have no caller and no check.

   Fix: Reword camera.py, test.py (THE REFERENCE) and sim.py to say View is taken as built to the design. State the placement tolerance that assumption needs: about 0.01-0.02 deg of mirror tilt for a tenth of the budget. Alternatively implement a measured View, e.g. PnP on the bands or gimbal markers at several hinge angles. Give it a covariance that enters the budget, and draw that error in phone/sim.ready so check 23 sees it. Delete mirror_size, motion_px and still_speed, or give each a caller and a check.

   Skeptic: Confirmed. camera.py:15-17 says 'the station commissions where it stands against the rig, View.c and View.R'. test.py:63-66 calls the view the phone's commissioned pose, and phone/sim.py:32 says 'the commissioned view'. In fact the only source of sp.view is test._plan_for:193, view_at(...), the design pose. That one object is the app's frame, the reference (test.py:412) and SimCamera's true pose (sim.py:326), so no commissioning step or error exists anywhere. No phone commissioning appears under phone/ or in README.md. A yaw error of the unfolded camera shifts the anchor by 4 m x delta relative to the reference: 7 mm per 0.1 deg, against a budget X rms of about 7.3 mm. A grep finds no caller of mirror_size, motion_px or still_speed outside camera.py, though the docstring says they size the mirror and the still frame. It is a docstring/model gap, not a wrong result inside the simulation.

12. **moved() uses the Wilson-Hilferty chi-square approximation at 3 dof and a 1e-8 tail, outside its stated validity** (`phone/app.py:137`, phone)

   The docstring of rig/calib.chi2_quantile limits it to the hundreds-to-thousands of dof a rig check has. app.moved calls it with dof 3 at TAIL/len(w) ≈ 7e-9. There the cube-root approximation puts the threshold 10% high in chi-square (5% in rate).  As a result the stance detector's real false-alarm tail is about 8x smaller than the Module.Z_SIGMAS/Bonferroni tail the docstring states, and detection lags a little more than designed. The error is in the safe direction, but the stated tail is not the one the code applies. An exact closed form exists for 3 dof.

   Fix: In app.moved, use the exact 3-dof survival function, sf(x) = erfc(sqrt(x/2)) + sqrt(2x/pi) exp(-x/2), inverted by bisection. Or give calib.chi2_quantile an exact branch for small integer dof: the regularised upper gamma has closed forms for integer and half-integer dof. Leave W-H for large dof, where it is accurate.

   Skeptic: Confirmed by probe (Module.Z_SIGMAS = 4, TAIL = 3.17e-5). At 3 dof, Wilson-Hilferty gives a threshold 9-11% high in chi-square. For n = 1000/2000/5000 samples: 41.37/43.13/45.46 against exact 37.77/39.19/41.07. The true tail at the W-H threshold is 0.17/0.15/0.12 of the TAIL/n that app.py's docstring (Bonferroni over Module.Z_SIGMAS) states. calib.chi2_quantile's own docstring claims accuracy only at the hundreds-to-thousands of dof a rig check has. The error is conservative (fewer false alarms, slightly later detection), but the stated tail is not the one applied.

13. **Docstring geometry is wrong: square on to a face the silhouette's middle is on the axis; R/4 is when a face is edge-on** (`phone/app.py:47`, phone)

   app.py step 4 and demo_phone.py:22 say that square on to a face the band silhouette's middle is R/4 off the axis. app.seen itself shows the opposite. With the line of sight along a face's normal, the extent across is symmetric and the offset is zero. The R/4 offset (6.93 mm on the kid's bat) appears when the line of sight lies in a face's plane: at this station the camera looks along y, edge-on to the bottom face, with the apex up.

   Fix: Reword both docstrings: 'seen side-on with the flat face edge-on to the lens (as at this station: face down, camera horizontal), the silhouette's middle is R/4 off the axis, 7 mm on the kid's bat; square on to a face it is on the axis.'

   Skeptic: Confirmed with app.seen at p = (-0.137, 4, 0), rolling the bat about its axis. Roll 0: offset (0, 0, +6.928) mm. At this roll the line of sight (bat y) lies in the flat face's plane: the face is edge-on and the apex points up. Roll 30 deg puts a face normal along the line of sight, and the offset is (0, 0, 0). For an equilateral rounded triangle, the extent along e is symmetric whenever the camera looks along a face normal. It is R/4 off-centre when e runs along a vertex direction, which happens when the line of sight is parallel to the opposite face. So 'square on to a face ... R/4 off the axis' in app.py:46-48 and demo_phone.py:21-23 states the opposite of what the code, correctly, computes.

14. **PICTURE_ZNEAR is a fraction of the model's extent, not metres** (`phone/picture.py:23`, phone)

   MuJoCo's visual/map znear and zfar are multiples of the model's stat.extent, not distances. The comment '# m' and the docstring's 'at mjcf.scene's 1 mm ... at 50 mm' treat them as metres. On the kid's bat, extent = 0.81 m, so the near plane is 40.6 mm (scene's original 0.8 mm), and zfar=20 is 16.2 m, not 20 m. The depth-resolution conclusion still roughly holds (about 0.024 mm at 4 m), but the unit is wrong and will mislead the next person who sizes it, for example for a larger bat or a scene that includes the mirror.

   Fix: Either keep a distance constant and convert it: build once, read m.stat.extent, and write znear = PICTURE_ZNEAR_M / m.stat.extent (or pin it with <statistic extent=...>). Or relabel PICTURE_ZNEAR as a fraction of the model's extent and correct the docstring's distances: 0.8 mm for the scene's default, about 41 mm here.

   Skeptic: Confirmed. I probed a minimal MJCF: with a box 0.1 m in front of the camera, znear=0.05 at extent 4.98 clips it, and znear=0.01 does not. So the near plane is znear * stat.extent, not metres. On the kid's scene, extent = 0.8117, so PICTURE_ZNEAR = 0.05 puts the near plane at 40.6 mm and zfar=20 at 16.2 m. The scene's original 0.001 is 0.8 mm, not 1 mm. The 24-bit depth step at 4 m is 0.023 mm, so the docstring's conclusion of about 0.02 mm still holds. Only the unit, the '# m' comment and the quoted distances are wrong.

15. **In the physics, the rig's own move to the stance loads the pack harder than the swing (planned at zero margin, plus encoder-velocity noise)** (`swing/rig.py:447`, swing)

   gentle() stretches each move until its planned pack load equals the swing's peak exactly, which leaves no margin. In sim._drive the D term uses an unfiltered difference of a 17-bit encoder over one cycle. The arm is commanded to hold still during the move to the stance, but in MuJoCo it jitters at about 3 rad/s^2, which adds about 0.1 g along the bat. The move to the stance becomes the run's harshest moment on the cells. This contradicts motion()'s docstring ('without loading the pack harder than the swing does') and check 4's claim. Check 4 holds only the planned kinematics, so it passes. On the shortest pair the move takes the + plate force below CapSpring.F_MIN, while the swing itself does not.

   Fix: Estimate velocity in sim._drive with a standard filter, either a first-order low-pass at the loop's bandwidth wc or a tracking observer, rather than (enc - enc_prev)/CYCLE_S. Or give gentle() a margin equal to the loop's stated acceleration error times its lever along the bat. Add a MuJoCo assertion to check 8 that the least + plate force during the moves is at least the least during the swing, with an unstretched Move as its must-fail. Do not reword motion()'s docstring; it describes the plan correctly.

   Skeptic: Physics reproduced. Least + plate force: dummy pack 2.1262 N during the move to the stance (t = 0.083 s) vs 2.1669 N in the swing; shortest pair 1.4921 N vs 1.5008 N (CapSpring.F_MIN = 1.5). True pack_load averaged over each drive cycle: 0.970 g during the move vs 0.864 g in the swing. Arm acceleration error during the move: RMS 1.20, max 3.51 rad/s^2. With Servo.ENCODER_BITS = 24, the arm's error RMS drops to 0.014 rad/s^2 and the move's least force becomes 2.1812 N against 2.1782 N in the swing. That confirms the unfiltered encoder difference in the D term, on top of gentle() planning to exactly f_max, as the cause. One overstatement: motion()'s docstring and check 4 are explicitly about the planned kinematics (check 4 sits under 'THE RIG, no physics'), and those claims hold. The real defect is that in MuJoCo the rig's own move is the run's harshest moment on the cells, and no physics check notices. No current verdict flips: check 8 tests opens, not F_MIN.

16. **Check 10 tests the rig's planar swing at the chip, not the rated swing the contract names** (`../scripts/batline/check_swing.py:366`, swing)

   The contract is 'fails if the IMU saturates at the rated swing'. Check 10 tests only the rig's MuJoCo run (r0). At the chip, the planar rig falls short of the rated swing on the main gyro axis and has no x/z rate and no y specific force. Check 1 already computes the rated swing's chip rates (w3) but only prints them. The margin to the rail is large today (2311 vs 3861 dps), but no check would catch it if it were not.

   Fix: In check 10, compute the rated swing's chip signals: w3 as check 1 does, plus f3_chip = Rc^T (second difference of the chip's position - GW), taken at the chip's own position p_imu rather than the pack's centre. Then require max(|r0.w|, |w3|) <= gy and max(|r0.f|, |f3_chip|) <= ac per axis. Run the 2000 dps must-fail through the same combined comparison.

   Skeptic: Confirmed. Check 10 holds only r0, the rig's planar run, against usable(z). Probe at the chip, per axis: rig |w| = [0, 2307.7, 0] dps and |f| = [12.62, 0, 8.91] g; rated swing (Swing.pose, finite differences at the chip) |w| = [547.4, 2311.3, 591.2] dps and |f| = [12.00, 3.90, 7.24] g; usable 3861 dps and 31.0 g. The rig falls 3.6 dps short of the rated swing's main-axis peak and puts nothing on x/z rate or y force, so check 10 does not test the contract's 'at the rated swing'. Margins are large today. One correction to the proposed fix: check 1's f3 is the scalar load along the bat at the pack's centre, not the chip's 3-axis specific force, so it cannot be reused as 'the matching f3 at the chip'.

17. **Check 6's tolerance cannot detect the computed-torque feedforward; its must-fail only exercises the clip branch** (`../scripts/batline/check_swing.py:321`, swing)

   The tolerance is one drive cycle's travel at peak rate: 21.4 mrad (arm) and 40.3 mrad (wrist). That is about 10 times the error of a loop with the whole Newton-Euler feedforward removed. A wrong-sign or missing coupling term in the computed torque, which THE LOOP's docstring describes, would therefore pass. The must-fail (the arm on the 750 W motor) fails because of clipping, so the `err <= lim` branch is never shown to reject anything.

   Fix: Keep the one-cycle-travel tolerance. Add a must-fail that exercises the err branch without clipping: drive the rig on its plan delayed by two drive cycles (FF and PD on Qd(t - 2*CYCLE_S)) and hold the error against the undelayed plan. The error then reaches about 2*lim at peak rate with commands unclipped, and the same `np.all(err <= lim) and not sat.any()` must reject it.

   Skeptic: Both facts confirmed. With the arm on the motor below, the error is [3.04, 1.98] mrad against lim [21.4, 40.3]: err <= lim holds on both joints, and the must-fail fails only through clipping (2.0% of arm steps). With SR.torques zeroed in sim._drive: errors [2.02, 3.94] mrad, no clip, check 6 passes. So the err <= lim half is never shown to reject anything. But the tolerance does state an origin the header allows (a drive cycle's travel at peak rate), and computed-torque correctness is check 2's job (NE against MuJoCo's inverse dynamics), not check 6's. The proposed fix is wrong: removing the feedforward moves the error only from 1.1 to 2.0 mrad (healthy error is unchanged even with a 24-bit encoder, so it is systematic), and a tolerance placed between those would be a tuned threshold of the kind CLAUDE.md forbids.

18. **sim.py docstring and solref comment describe the unstable RING=2 contact; the tip-coil claim is also wrong** (`swing/sim.py:33`, swing)

   The module docstring says a contact 'rings at half the step's rate (the stiffest MuJoCo integrates stably, a hundred times the cap spring's own rate)'. The solref comment says 'a natural frequency of half the step's rate is 2 dt / zeta'. The code uses RING = 4.0. The 'half the step's rate' setting is RING=2, and that is exactly the one that chatters and never settles (check 5's must-fail). The docstring also says the spring's tip coil 'is folded into' the last cell, but xml() gives the last cell only pack.m (CapSpring.MASS is never used in sim.py). It also says the coil pushes 'a few hundredths of a newton' against the preload; at the swing's largest pull it is about 1.4 mN.

   Fix: Reword the module docstring and the solref comment for the coded value: solref (RING*dt/zeta, zeta) gives omega_n = 1/(RING*dt); RING = 4 is a quarter of the step rate in rad/s (f_n = step rate/(8*pi)), about 86x the spring's sqrt(k/m) on the pack; RING = 2 chatters (check 5's must-fail). Say the tip coil is left out of MuJoCo and added statically in check 9 (about 1.4 mN), or add CapSpring.MASS/3 to the last cell's inertial in xml().

   Skeptic: Confirmed. RING = 4.0 at dt = 1/32000 gives omega_n = 1/(RING*dt) = 8000 rad/s, f_n = 1273 Hz, 1/25 of the step rate. The docstring's 'half the step's rate' and the solref comment's '2 dt / zeta' describe RING = 2, which chatters and never settles (probe: settle raises, plate force 0.0 N). That contradicts 'the stiffest MuJoCo integrates stably'. CapSpring.MASS is never read in sim.py (grep: only check_swing.py:357), so the tip coil is not 'folded into' the last cell. Its third of the mass times F_MAX is 1.42e-3 N, not 'a few hundredths of a newton'. The ratio to the spring's sqrt(k/m) is 85.8x, close enough to 'a hundred' but best stated.

19. **demo_swing --weak draws the healthy spring's preload in the plate-force prediction** (`../scripts/batline/demo_swing.py:109`, swing)

   The green 'spring less the pack's load' trace adds SR.spring_force(rig.d, SR.DUMMY), which reads CapSpring.RATE. With --weak the Sim runs at the weak rate, so the black trace (that run's plate force) is drawn against a prediction offset by the healthy preload. The demo exists to show where the circuit opens, so this misleads.

   Fix: Pass the rate used to traces(rig, mo, r, rail, rate) and draw rate*(CapSpring.L_FREE - SR.seated(rig.d, SR.DUMMY)[1]) - m_pack*pack_load. Default rate to CapSpring.RATE.

   Skeptic: Confirmed. traces() adds SR.spring_force(rig.d, SR.DUMMY), which reads CapSpring.RATE (2.57 N preload). The --weak rate (0.195 N preload) goes only to SS.Sim via kw['rate'], so under --weak the green prediction sits about 2.4 N above the black plate-force trace it is meant to explain.

20. **swing_angles says 'unwrapped from the stance' but takes a bare arctan2** (`swing/rig.py:226`, swing)

   phi = arctan2(h_z, h_x) lies in (-pi, pi], and only swing_state's central difference handles the branch. The rated swing's arm angle spans -158.7 to -3.0 degrees, 21 degrees from the cut. A swing, or a hub fit, that carries the hands above the hub on the -x side would make q jump by 2*pi, and Motion and the servo loop would then plan a full arm turn. The code claims to work for any swing spec.

   Fix: In fit(), store m = the unit hub-to-hands vector at the arc's mid angle. In swing_angles, use phi = atan2(m_z, m_x) + arctan2(cross2(m, h), m.h), which is continuous for any arc under 360 deg. Alternatively, correct the docstring and raise if any |phi - phi_stance| exceeds pi.

   Skeptic: Confirmed. swing_angles computes phi = np.arctan2(h_z, h_x) with no unwrap, yet the docstring says '(phi, alpha) ... unwrapped from the stance'. Only swing_state's three-point branch fix touches it. Probe: over the rated swing phi runs from -158.705 to -2.974 deg, 21 deg from the cut. Rules.RATED_SWING does not depend on the design, so nothing breaks today. A swing spec whose hands pass above the hub on the -x side would make q jump by 2*pi, and Motion would then plan a full arm turn.

21. **Check 12 is one-sided: any over-booked plan passes** (`../scripts/batline/check_swing.py:402`, swing)

   The check only requires mean <= plan + z*se, and its must-fail only tests an under-plan (no move back). A plan that double-counts the run or a request would still pass, so line.py could book the station's time wrongly without anything failing. check_link's timing checks share this pattern.

   Fix: Make the check two-sided with the plan's stated approximation as the downward allowance: plan - 4*(request_s(ci) - the request's mean) - zshare(2)*se <= mean <= plan + zshare(2)*se. Better still, have plan() book each request at its mean and keep request_s for the timeout, then use |mean - plan| <= zshare(2)*se. Add a must-fail with the move back counted twice (plan + MO.back.T) and require it to fail.

   Skeptic: Confirmed. `within = secs.mean() <= plan + zshare(2)*se and ...` is one-sided, and the only must-fail under-books. A plan with the move back counted twice (plan + back.T = 2.105 s) would pass, even though the header says the test 'takes its planned time'. One correction to the proposed fix: the plain two-sided form fails on today's code. Probe over the 6 healthy bats: mean 1.8245 s, se 0.0022 s, plan 1.8411 s, a gap of 7.6 se. PR.request_s books 2*ci per request where the simulated requests average about 1.5*ci, so the plan over-books its four requests by about 17 ms.

22. **Check 10's accelerometer half has no must-fail** (`../scripts/batline/check_swing.py:372`, integration)

   Check 10 passes when `pw <= gy and pf <= ac`. Its must-fail (a 2000 dps part) only exercises the gyro comparison. The accelerometer comparison, half of the plan's contract that 'the IMU does not saturate', is never shown able to fail. It currently passes with a 2.5x margin, so any error in the force path under that factor (units, the chip's lever, gravity sign) would go unnoticed.

   Fix: Add `with patched(Imu, ACC_FS=8.0): gy3, ac3 = usable(z)` and `check('must fail: an 8 g accelerometer (10)', not (pw <= gy3 and pf <= ac3), ...)`. Recompute both outputs under the patch, since ACC_FS also enters the gyro's g-sensitivity term. Note that a 16 g part would not fail at 12.6 g, so the variant must go below the peak force.

   Skeptic: Confirmed at check_swing.py:370-378. The check's predicate is `pw <= gy and pf <= ac`, but its only must-fail patches GYRO_FS and evaluates `not pw <= gy2`, so the accelerometer half is never shown able to fail. The margin there is large (about 12.6 g of 31 g, per the reported probe). Checks 7 and 1 cross-check the force path in other ways, so this is a gap in coverage, not a wrong result.

23. **The truth wall's fresh-interpreter load test has no must-fail (checks 21 and swing 14)** (`../scripts/batline/check_link.py:922`, integration)

   Check 21, and check_swing 14 which copies it, passes only if both the source scan and the fresh-interpreter load test are clean. The must-fail runs only the source scan (`imports_truth`) on board/sim.py, phone/sim.py and swing/sim.py. The load half, a formatted `code` string run in a subprocess, is never shown able to fail. check_imu 15 does run its load test on imu/sim.py as a must-fail. The load test works today: a probe shows it reports batline.board.sim and the others. But a regression in it would pass silently.

   Fix: In both checks, add `p = subprocess.run([sys.executable, '-c', code, 'batline.board.sim'], ...)` (and 'batline.swing.sim' in check_swing) with `check('must fail: the same load test on board/sim.py', bool(p.stdout.strip()), ...)`.

   Skeptic: Confirmed. Check 21 (check_link.py:904-923) and check_swing 14 (lines 417-440) pass only if the source scan and the fresh-interpreter load test both come back empty. Their must-fails run only imports_truth on the sim modules. The subprocess `code` string is never run on a module that must report something. check_imu 15 does exactly that (subprocess on batline.imu.sim). A regression in the load test, such as a mis-formatted TRUTH tuple or a wrong module-name filter, would pass silently. An import failure would still show, because 'failed to import' is non-empty.

24. **HOLD_C's comment claims a check that does not exist (smallest E6 value)** (`spec.py:151`, integration)

   The comment says check_link holds HOLD_C to 'the smallest E6 value that clears' power.holdup_c_needed at its low tolerance. Check 1 only asserts the lower side: c_low >= need. HOLD_C is effectively a computed answer (206 uF divided by 0.8, rounded up to E6 gives 330 uF). If BOUNCE_S, HOLD_LIFE or the draw change, 330 uF stays put silently whenever it still clears; 470 or 680 uF would also pass. This is the 'a constant can only be wrong silently' case the comment says is covered.

   Fix: Add power.hold_c(): the least E6 value v (across decades) with v*(1 - HOLD_TOL) >= holdup_c_needed(). Either use it wherever HOLD_C is a requirement, or add to check 1 `Board.HOLD_C == P.hold_c()`, with the next E6 value down as a must-fail. Otherwise reword the comment to say only that the lower bound is checked.

   Skeptic: Confirmed. spec.py:145-151 says check_link holds HOLD_C to 'the smallest E6 value that clears it'. check_link power_checks check 1 (lines 247-256) tests only c_low >= need and t_low >= BOUNCE_S, plus a 100 uF must-fail. Today 330 uF is in fact the smallest such value (need 206.3 uF; 220 x 0.8 = 176 fails; 330 x 0.8 = 264 passes). But if the draw, BOUNCE_S or the tolerance changed, 330 would stay put and nothing would flag it. The comment claims a check that does not exist, and the value is a computation done by hand.

25. **RING = 4 contradicts the 'rings at half the step's rate' docstring; check_swing 5 misstates the stiffness change** (`swing/sim.py:102`, integration)

   The module docstring and the comment at solref both say the contact rings at half the step's rate, the stiffest stable setting, with a time constant of 2 dt / zeta. The code uses RING * dt / zeta with RING = 4, which is twice MuJoCo's two-step floor. check_swing 5's must-fail shows that RING = 2 chatters. MuJoCo's stiffness goes as 1/timeconst^2. So check_swing's 'halving the contacts' stiffness (sim.RING doubled)' actually quarters it, and 'twice as stiff' (RING halved) is four times as stiff.

   Fix: Document RING as the contact's period in units of 2*pi steps: omega_n = 1/(RING*dt), a quarter of the step's rate at RING = 4, and RING = 2 (half the step's rate) chatters, as check_swing 5 shows. In check_swing, say that doubling RING quarters the contacts' stiffness (halves their frequency) and that the must-fail makes them four times as stiff.

   Skeptic: Confirmed. MuJoCo's solref (timeconst, dampratio) gives stiffness k proportional to 1/(timeconst^2 * dampratio^2), so omega_n is about 1/(timeconst*zeta). With timeconst = RING*dt/zeta, omega_n = 1/(RING*dt), as settle() itself assumes: its block of one contact period is ceil(2*pi*RING) steps. The docstring (line 33) and the solref comment (117-118) describe RING = 2 ('half the step's rate ... 2 dt / zeta'), but RING = 4.0 (line 102), which is a quarter. check_swing's docstring (lines 40-43) and its detail text call RING doubled 'halving the stiffness' and RING halved 'twice as stiff'. Since k goes as 1/RING^2, those are a quarter and four times. The finding's suggested wording 'twice MuJoCo's 2-step floor' is not right either: MuJoCo's floor applies to timeconst = RING*dt/zeta, not to RING*dt.

26. **SWD connect time is a bare '64 words', shared by the plan and the simulated probe** (`board/procedures.py:524`, integration)

   The plan's 'swd' step is 64 SWD words with no stated origin. The simulated probe waits exactly the same expression, so check_link 12, which holds the simulated procedure to the plan, cannot test this number. It is a hand-set derived count; the effect is tiny (0.7 ms).

   Fix: Name it once, either as a [VERIFY] probe fact (e.g. Probe.CONNECT_BITS or CONNECT_S, from the probe's documentation) or as a function that counts ADIv5's connect sequence (line reset of 50 or more clocks, the 16-bit JTAG-to-SWD sequence, line reset, idle, IDCODE read, CTRL/STAT power-up write and poll). Use it in both procedures.plan and SimSwd.connect, with the same min(Probe, Mcu) clock as the other SWD timings.

   Skeptic: Confirmed. procedures.py:524 `"swd": 64 * Mcu.SWD_WORD_BITS / Probe.SWD_HZ` and board/sim.py:326 `self.b.clock.wait(64 * Mcu.SWD_WORD_BITS / Probe.SWD_HZ)` share the same bare 64 with no origin. The check that holds the simulated procedure to its plan therefore cannot test it. The effect is 0.74 ms, negligible. It is still an unexplained count, which CLAUDE.md asks to name. A smaller inconsistency: connect uses Probe.SWD_HZ while every other SWD timing uses min(Probe.SWD_HZ, Mcu.SWD_HZ).

27. **current_window() does not deliver what its docstring states for advertising** (`board/procedures.py:156`, integration)

   The docstring says the window holds 'enough radio events that one more or less moves the mean by less than the instrument's own accuracy'. The code uses ceil(1/Smu.ACC) * ADV_FAST_S = 10 x 20 ms. The mean advertising interval is ADV_FAST_S + ADV_JITTER/2 = 25 ms, so the window holds about 8 events. The radio supplies about 98% of the advertising draw, so one event more or less moves the mean by about 12%, more than Smu.ACC = 10%. Harmless for now, because the advertising limit (13.9 mA) is 18x the draw, but the stated property is false.

   Fix: Size the window on the longest interval: `(ceil(1.0 / Smu.ACC) + 1) * (Link.ADV_FAST_S + Link.ADV_JITTER)`, which guarantees at least ceil(1/ACC) + 1 events. Better, take the state's interval as an argument, since the same window is used for the sleep current.

   Skeptic: Confirmed. current_window() returns ceil(1/Smu.ACC) * ADV_FAST_S = 0.2 s (probe). power.draw uses a mean advertising interval of ADV_FAST_S + ADV_JITTER/2 = 25 ms, so the window holds about 8 events. The radio's share of advert_fast is Q_ADV/0.025 out of 0.778 mA, about 98%, so one event more or less moves the mean by about 12%, more than Smu.ACC = 10%. The docstring's stated property does not hold. It is harmless today, given the wide advertising limit.

28. **The camera's line of sight is typed as [0, 1, 0] instead of read from the gimbal's swing hinge** (`phone/test.py:193`, integration)

   The view is meant to be square to the swing plane, looking along the inner hinge's axis. That direction is hard-coded as station +y, which holds only because Chain.drawn() happens to put the inner hinge on E[1]. This is a derived direction typed in as a constant: re-drawing or re-building the gimbal (Chain.of with other axes) would silently put the camera edge-on to the swing.

   Fix: Take the sight from the kinematics: `sight = rot(kin.w1, q_a[0]) @ kin.w2`, which reduces to kin.w2 at q_a[0] = 0. Keep up as the station's +z, the frame gravity is defined in.

   Skeptic: Confirmed. _plan_for uses `C.view_at(centre, [0,0,1], [0,1,0])`. The sight [0,1,0] is the inner hinge's axis only because Chain.drawn() is built with E[0] and E[1] (kin.py:277-278), so kin.w2 = E[1]. A gimbal drawn with other axes would silently put the camera edge-on to the swing. The 'up' half of the proposed fix is not needed: +z as the station's up is the frame's own convention, used for gravity in GimbalTruth (np.array([0,0,-sp.g])) and throughout.

29. **LL_OVERHEAD = 17 counts the L2CAP header as 2 bytes and leaves out the ATT header** (`spec.py:259`, integration)

   air_s(payload) is called with the notification value (sync.link_floor passes PACKET_HEAD + 19 samples = 235 bytes). On air that value carries the 3-byte ATT opcode and handle, the 4-byte L2CAP basic header, and 15 link-layer bytes (preamble 2, access address 4, header 2, MIC 4, CRC 3): 22 bytes, not 17. The spec itself treats the L2CAP header as 4 bytes (LL_PAYLOAD 251 = MTU 247 + 4) and the ATT header as 3 (hal.notification_bytes = MTU - 3). The air time is 20 us short per packet in both the production sync floor and the simulated radio, so no check can see it.

   Fix: Set LL_OVERHEAD = 15 (preamble 2, access address 4, header 2, MIC 4, CRC 3, for a non-empty encrypted PDU). Add an explicit L2CAP (4) + ATT (3) header where a notification's or request's air time is computed. Give the empty PDU its own 11 bytes (2+4+2+3), with no MIC and no L2CAP.

   Skeptic: Confirmed. spec.py:259-260 has LL_OVERHEAD = 17 with the comment 'plus the L2CAP header's 2'. The L2CAP basic header is 4 bytes, which the same spec relies on (LL_PAYLOAD 251 = MTU 247 + 4). The ATT notification header (3 bytes; hal.notification_bytes = MTU - 3) is missing. air_s(n) is called with the notification value (sync.link_floor: PACKET_HEAD + samples; radio.py: len(head[2])), so each bat packet is 5 bytes, 20 us, short. Correction to the finding: link_floor's net error is not -20 us. air_s(0) charges an empty PDU 17 bytes, where the truth is 11 (no L2CAP and no MIC on an empty PDU), so +6 and -5 bytes roughly cancel. Plan and sim share the function, so no check sees it. The effect is microseconds.

30. **Check 13 holds pairing to 1.5x its plan with no stated origin, though the docstring says 'within its plan'** (`../scripts/batline/check_link.py:633`, integration)

   The docstring for check 13 says the factory iPhone 'pairs to it within its plan'. The code accepts any single pairing up to timeout(plan)/2 = 1.5 x plan (Module.OVERRUN = 3). The tolerance has no stated origin, and the must-fail (a newer database record) does not exercise the timing part.

   Fix: State the bound's origin: plan plus one run's stated spread (the advertising phase's maximum less its mean, (ADV_SLOW_S + ADV_JITTER) - ADV_SLOW_S/2, plus each request's host Z-tail). Or make it explicitly a timeout check (<= PR.timeout(plan)) and say so in the docstring. Add a must-fail for the timing half, e.g. a pairing timed against a plan without the record read.

   Skeptic: Confirmed. check_link.py:629-633 accepts p.seconds <= PR.timeout(plan)/2 = 1.5 x plan (Module.OVERRUN = 3), with no stated origin. The docstring (item 13) says 'pairs to it within its plan'. A single pairing's time is random (its advertising phase can be up to ADV_SLOW_S + ADV_JITTER, against the plan's mean of ADV_SLOW_S/2), so 'within its plan' cannot be what is meant. The must-fail (a newer database record) exercises only the record-equality half.

31. **stations() now runs the iPhone budget's Monte Carlo, about 23 s per bat, for the M1/M2 checks too** (`line.py:497`, integration)

   _layout calls phone_test.plan_s(d), which runs slow_swing's design: up to four turns, each with two 2000-trial study.run Monte Carlos. It runs even with timed=False, which check_gantry (KID and ADULT) and check_cameras (KID and ADULT) use only to get the station modules, and in check_calibration's line_checks and check_line. Each runs in its own process, so the in-memory cache does not help. Nothing breaks (probed on KID and ADULT), but every pre-existing suite now depends on and waits for M4's budget design.

   Fix: Make station 4's plan ops lazy, e.g. Op durations as callables resolved by job_s, so a modules-only caller (timed=False) never designs the iPhone swing. Or cache slow_swing's chosen turn and budget on disk, keyed by the design and the spec values it reads.

   Skeptic: Confirmed. _layout calls phone_test.plan_s(d) unconditionally, and stations(timed=False) still calls _layout once. My probe: the first slow_swing(KID) takes 23.4 s (four turns tried, each with two 2000-trial Monte Carlos). The callers check_gantry.py:93, check_cameras.py:109 and check_calibration.py:1276 (all timed=False, wanting only the modules) and check_line's plan_line each pay it per bat per process, since the cache is in memory. Nothing gives a wrong result; it is cost and coupling only.
