Chandanpanda/ART-Forum-2017-Stan-Tutorial/ex1.png

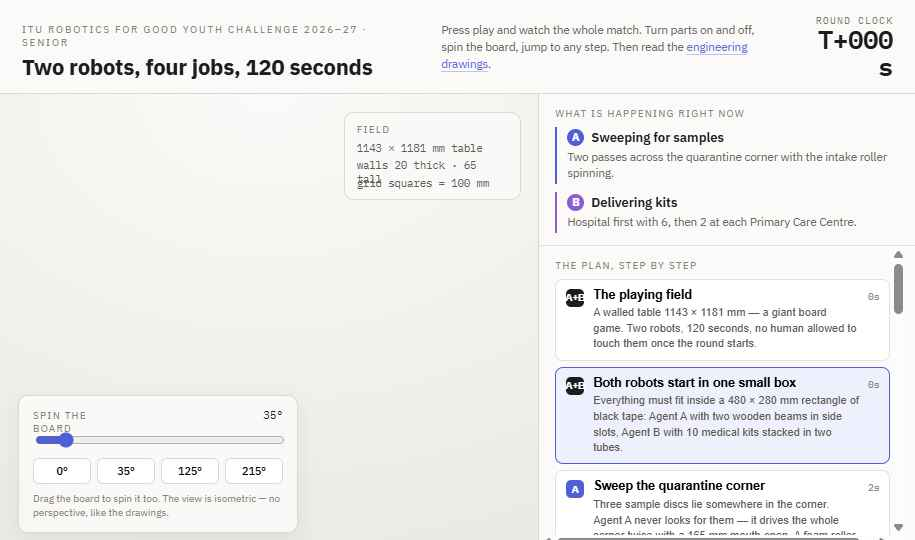
ex1.png
