Chandanpanda/ART-Forum-2017-Stan-Tutorial/s1.png

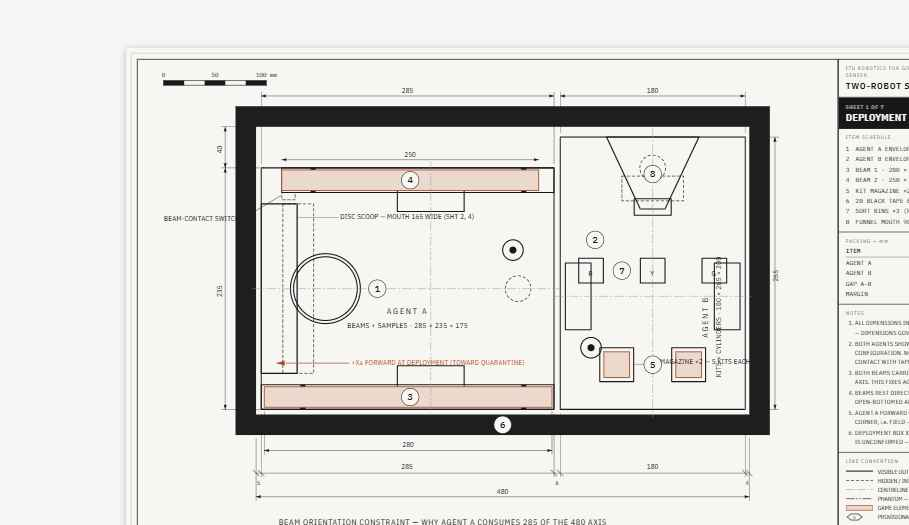
s1.png
