Chandanpanda/ART-Forum-2017-Stan-Tutorial/s2.png

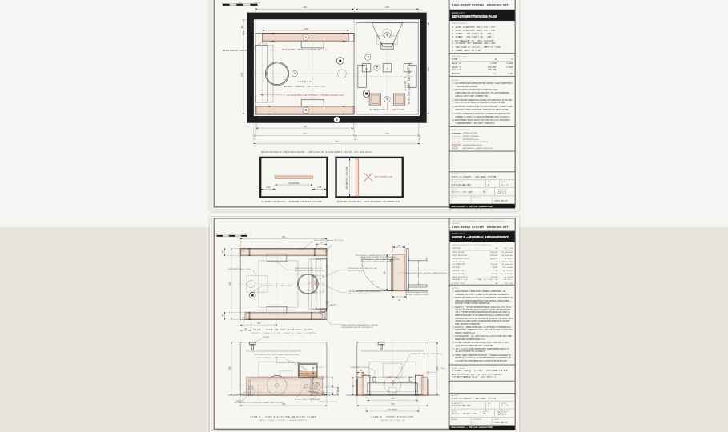
s2.png
