Chandanpanda/ART-Forum-2017-Stan-Tutorial/s-full3.png

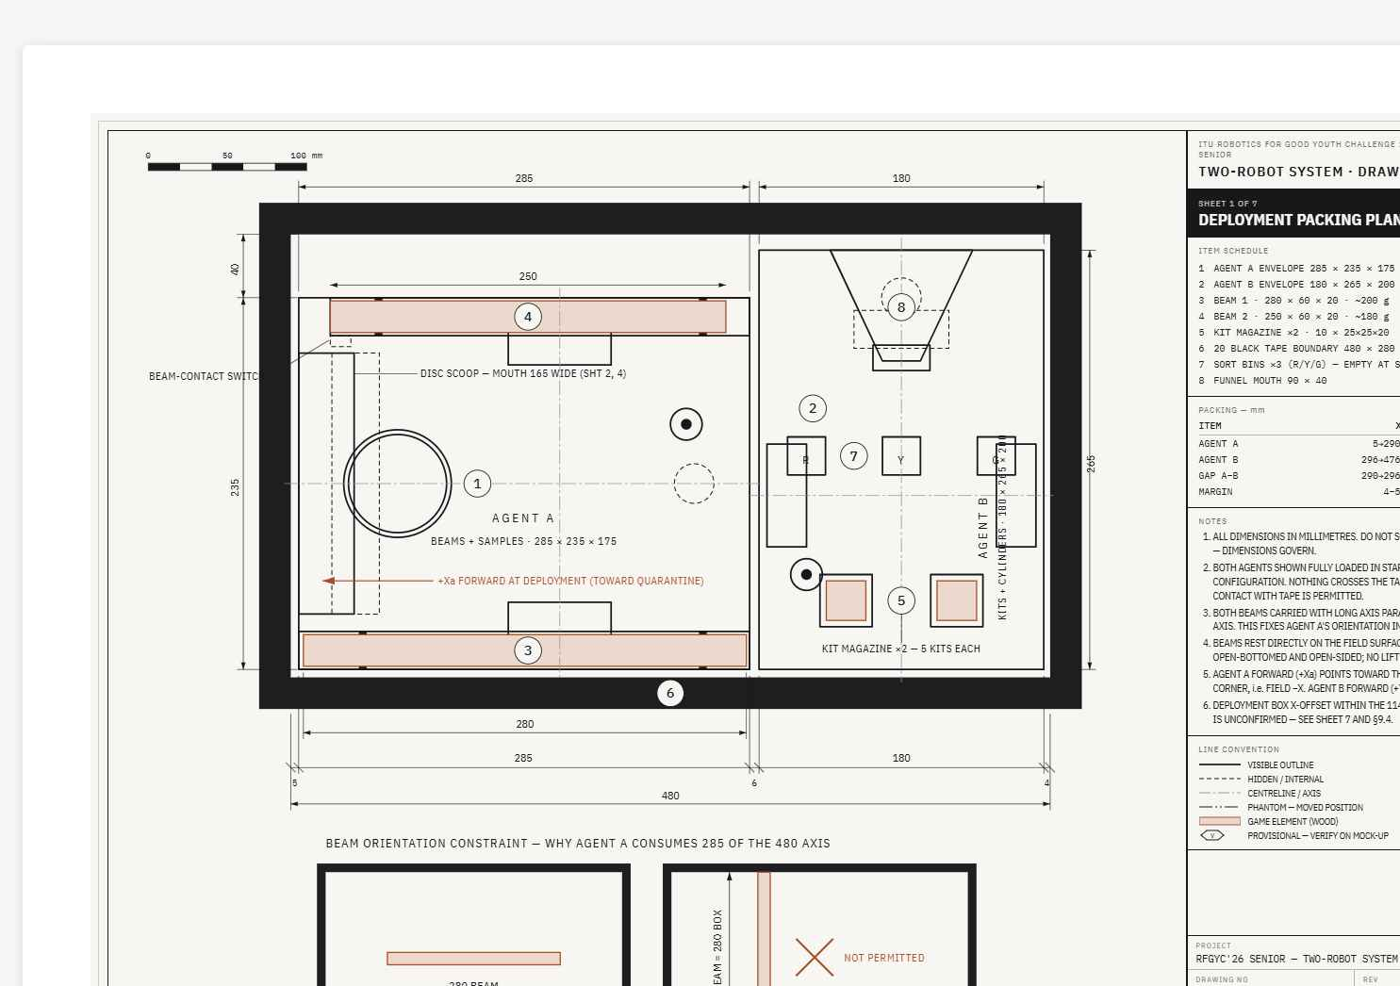
s-full3.png
