Chandanpanda/ART-Forum-2017-Stan-Tutorial/sheet2-detail.png

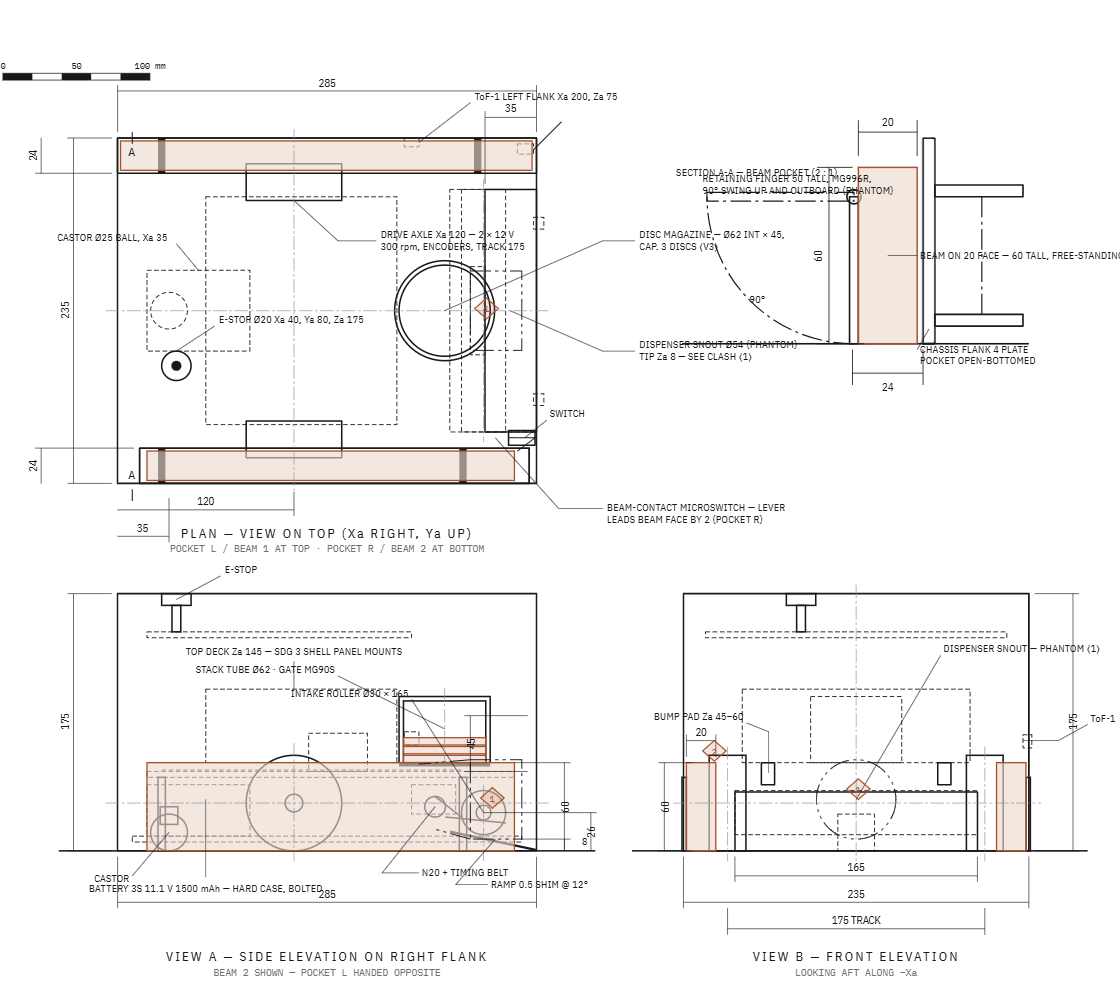
sheet2-detail.png
