Chandanpanda/ART-Forum-2017-Stan-Tutorial/sheet5.png

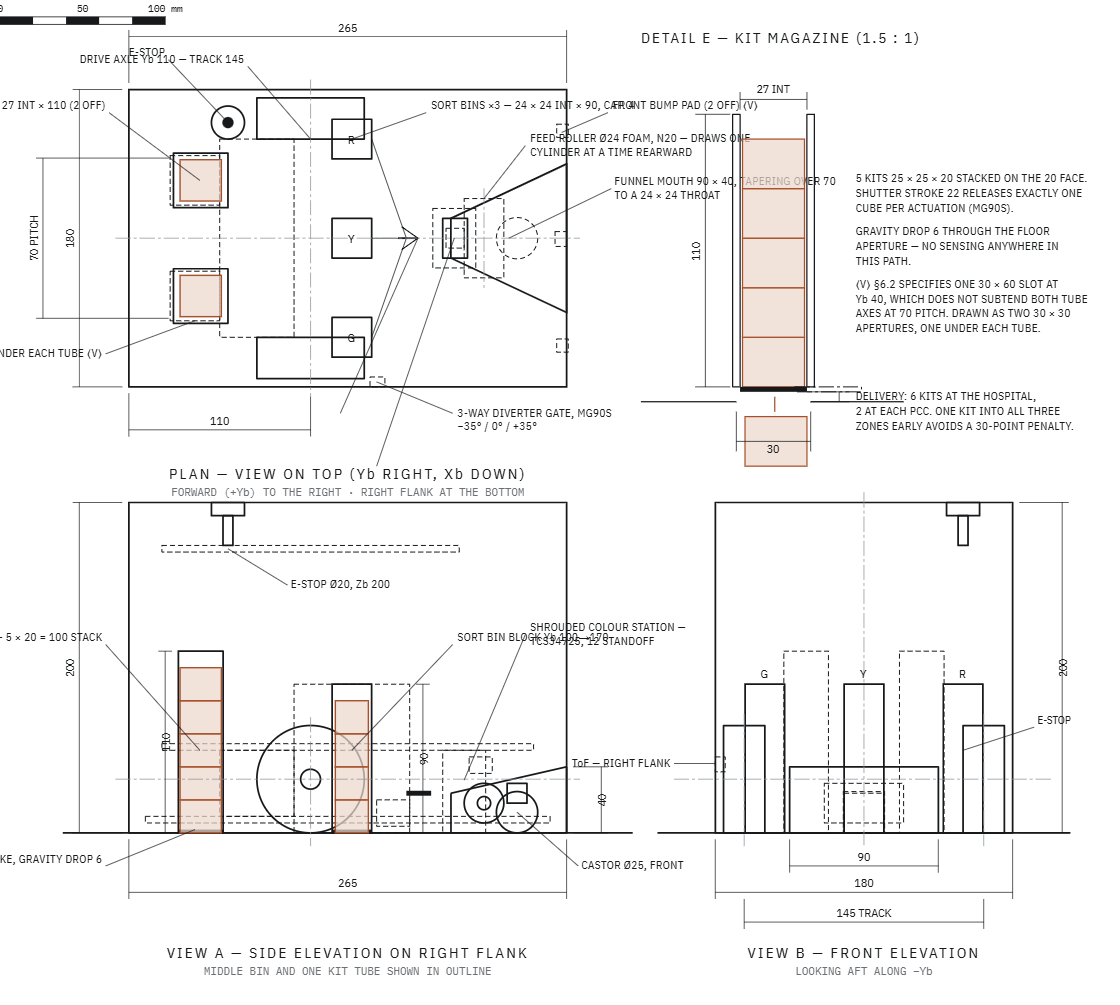
sheet5.png
