Chandanpanda/ART-Forum-2017-Stan-Tutorial/sheet7.png

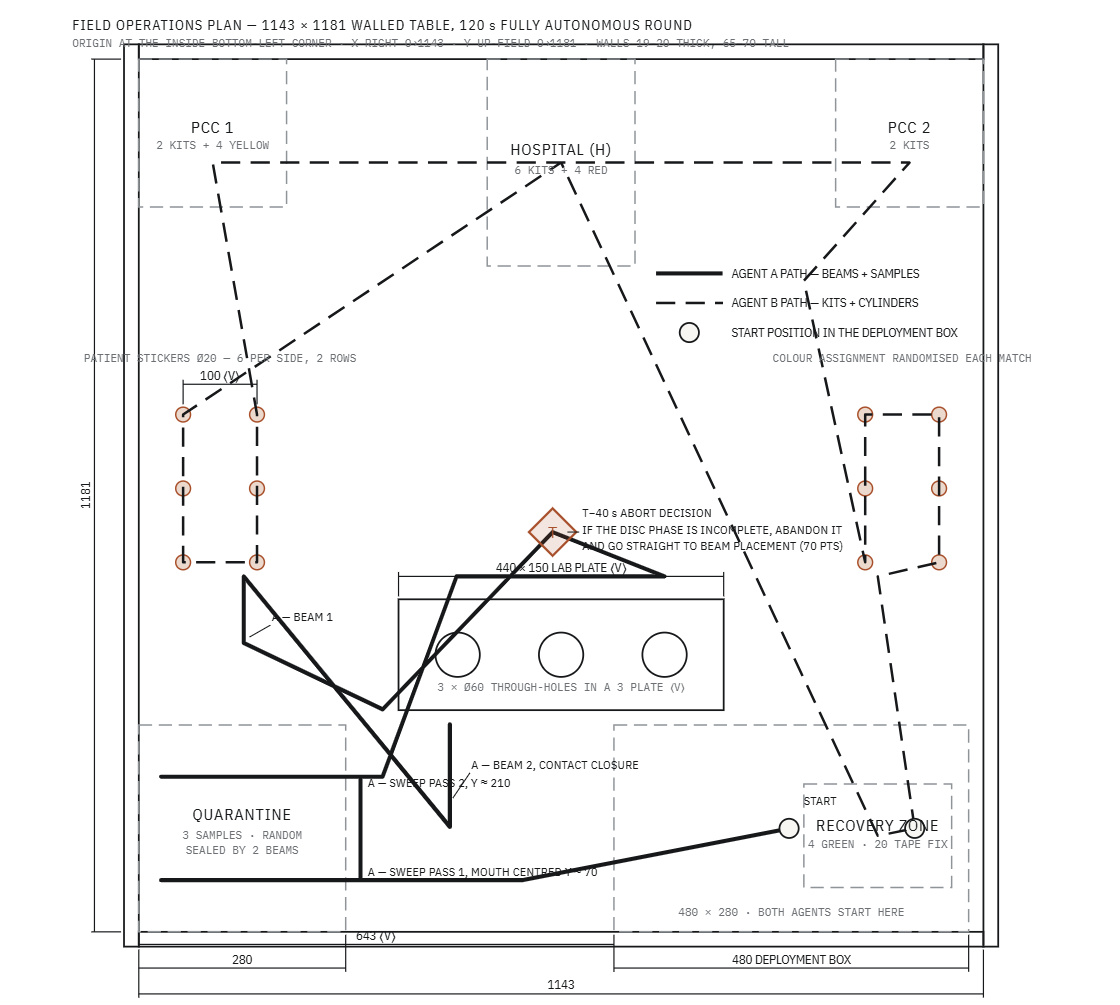
sheet7.png
