Chandanpanda/ART-Forum-2017-Stan-Tutorial/sim/cad/plate.dxf

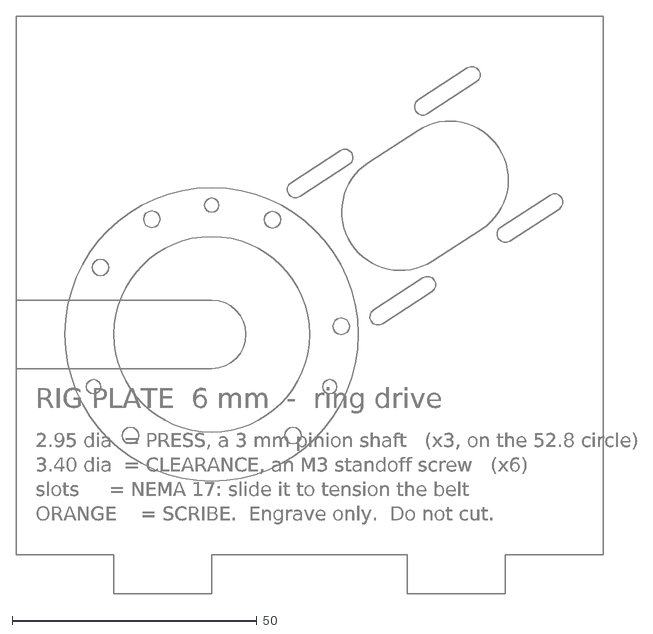
[picture p9: CAD file, 2026-09-16]
sim/cad/plate.dxf
RIG PLATE 6 mm - ring drive
2.95 dia = PRESS, a 3 mm pinion shaft (x3, on the 52.8 circle)
3.40 dia = CLEARANCE, an M3 standoff screw (x6)
slots = NEMA 17: slide it to tension the belt
ORANGE = SCRIBE. Engrave only. Do not cut.
