Chandanpanda/ART-Forum-2017-Stan-Tutorial/sim/cad/ring.stl

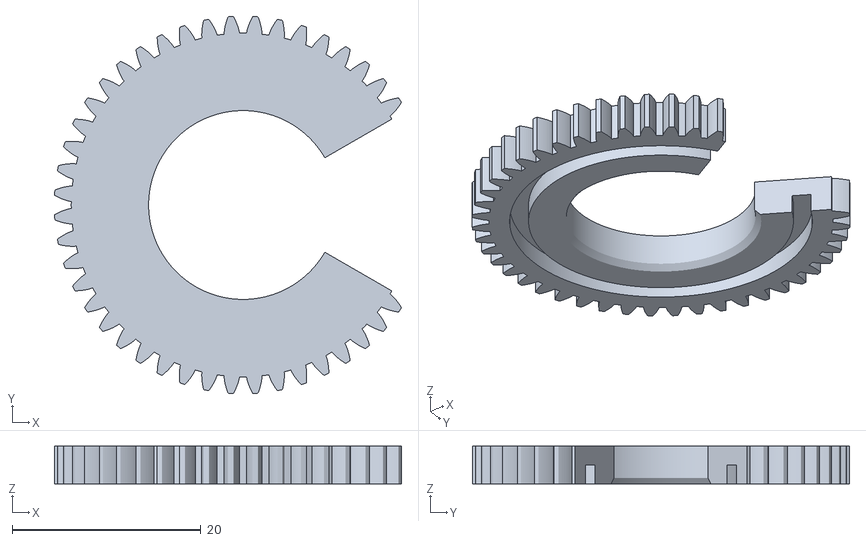
[picture p10: CAD file, 2026-09-16]
sim/cad/ring.stl
36.8 x 39.9 x 4.00
