Chandanpanda/ART-Forum-2017-Stan-Tutorial/sim/cad/base.dxf

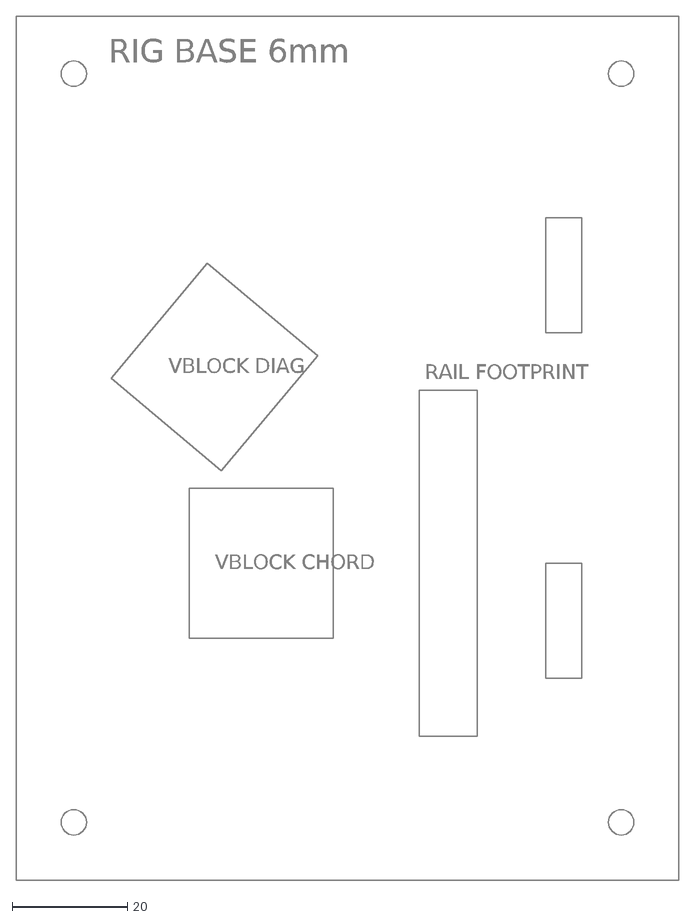
[picture p11: CAD file, 2026-09-16]
sim/cad/base.dxf
RAIL FOOTPRINT
RIG BASE 6mm
VBLOCK CHORD
VBLOCK DIAG
