Chandanpanda/ART-Forum-2017-Stan-Tutorial/sim/cad/vjig_chord.stl

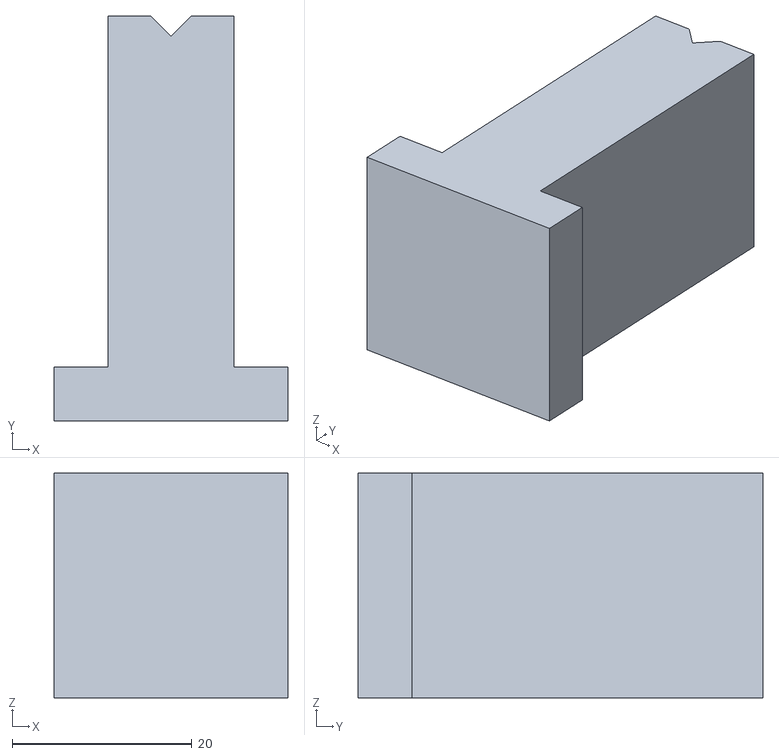
[picture p12: CAD file, 2026-09-16]
sim/cad/vjig_chord.stl
26.0 x 45.0 x 25.0
