Chandanpanda/ART-Forum-2017-Stan-Tutorial/sim/cad/pinion.stl

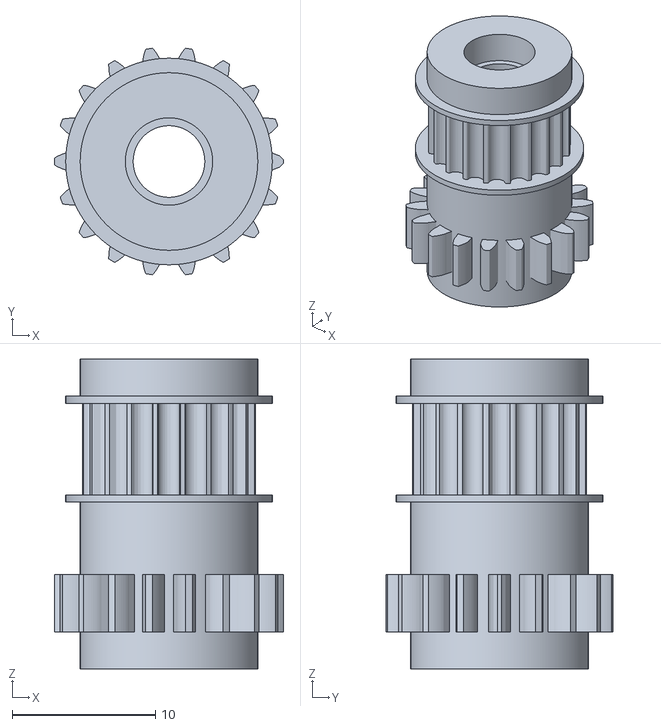
[picture p13: CAD file, 2026-09-16]
sim/cad/pinion.stl
16.0 x 15.8 x 21.6
