Chandanpanda/ART-Forum-2017-Stan-Tutorial/sim/cad/race_short.stl

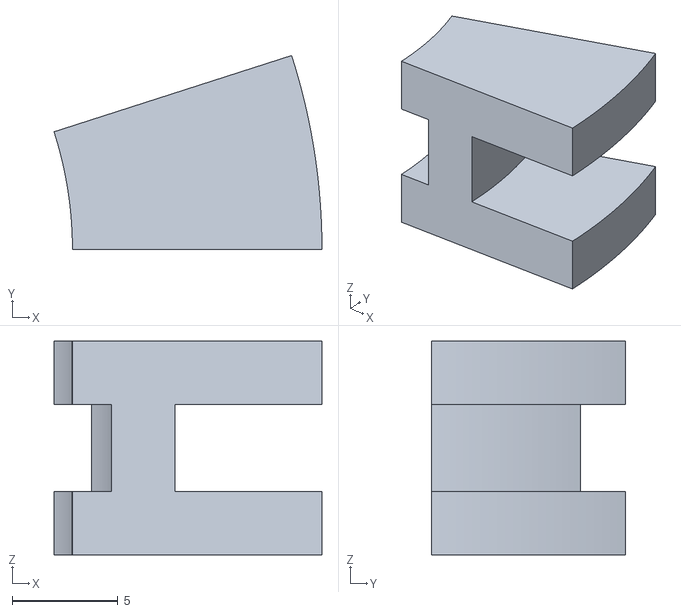
[picture p14: CAD file, 2026-09-16]
sim/cad/race_short.stl
12.7 x 9.17 x 10.1
