Chandanpanda/ART-Forum-2017-Stan-Tutorial/sim/cad/race_long.stl

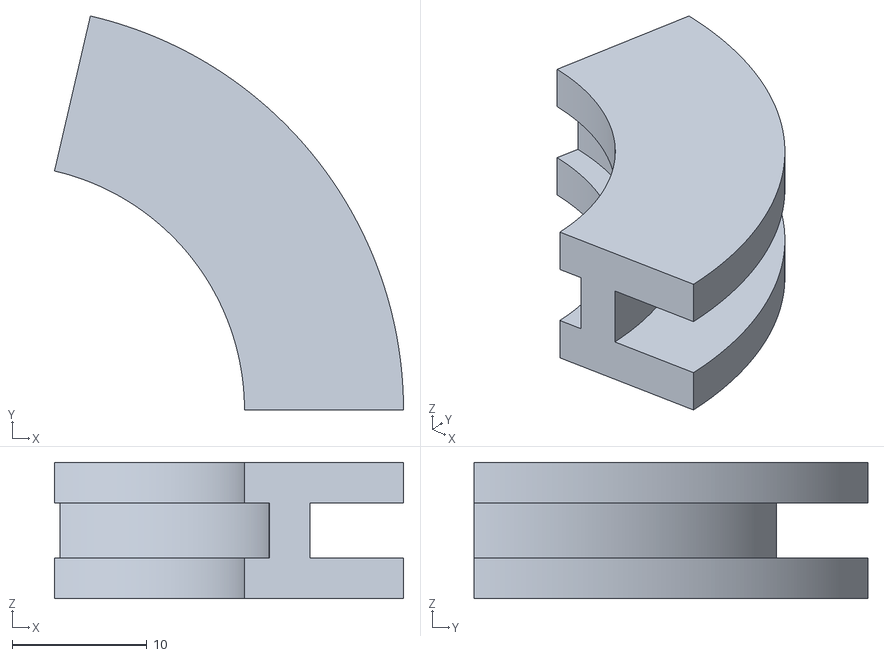
[picture p15: CAD file, 2026-09-16]
sim/cad/race_long.stl
25.9 x 29.2 x 10.1
