Chandanpanda/ART-Forum-2017-Stan-Tutorial/(list of files, cad)

Other CAD files:
sim/cad/vjig_diag.stl
