Chandanpanda/ART-Forum-2017-Stan-Tutorial/sim/RP-009992-DS-1-camera-module-3-sensor-assembly-standard-normalfov-datasheet.pdf

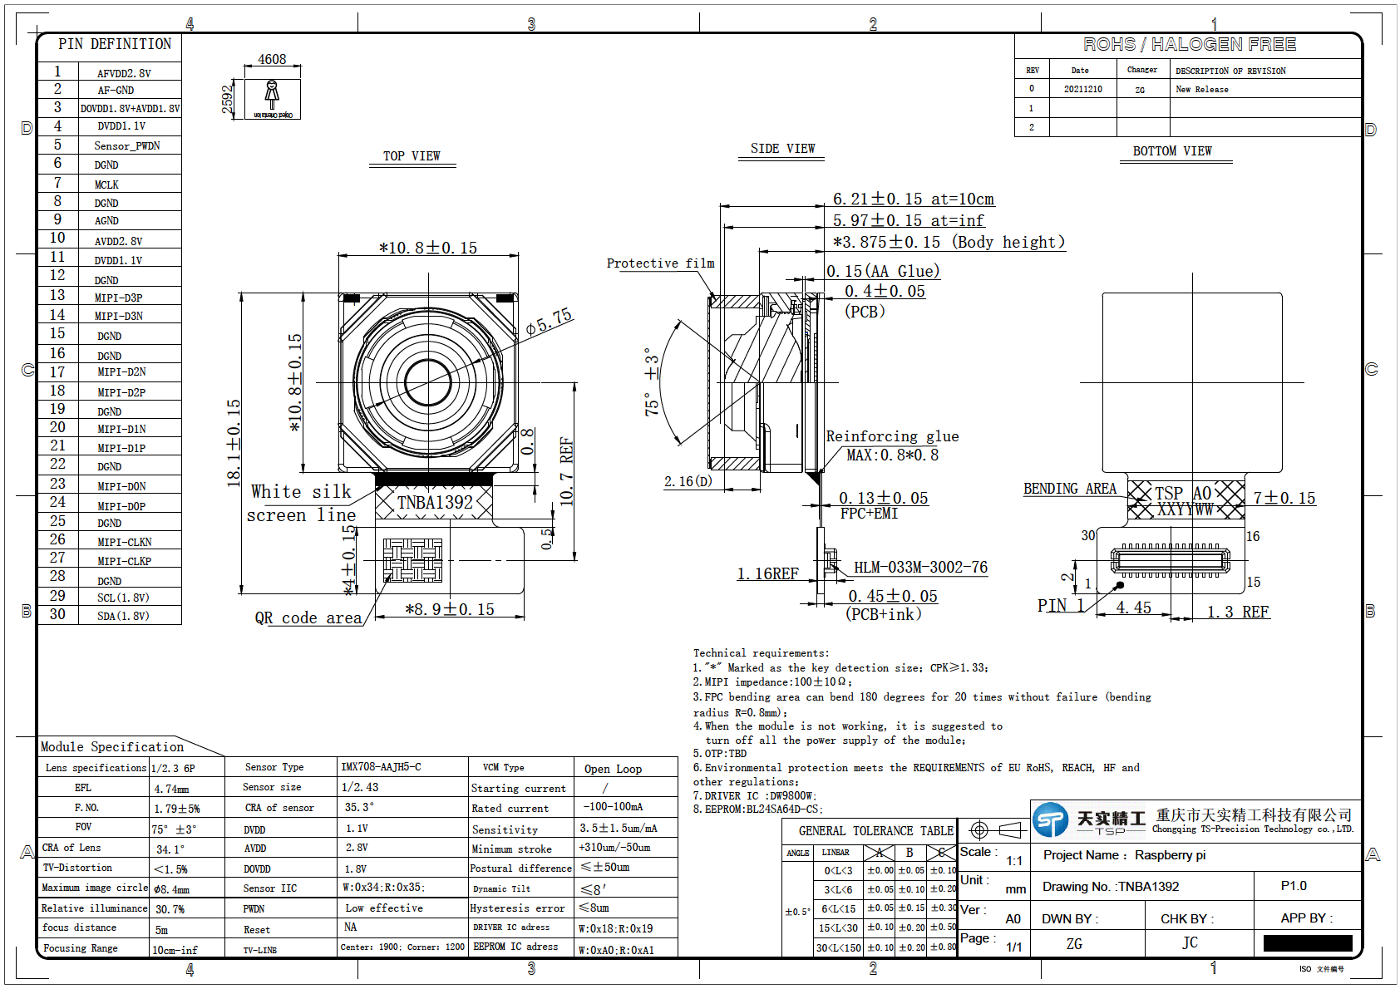
[picture p16: page 1]
