Chandanpanda/ART-Forum-2017-Stan-Tutorial/sim/rfgyc26/robot.py

"""Agent A's MuJoCo backend of the HAL (hal.py owns the contract).

The drive is a stepper model -- commanded wheel speed is quantised to whole
full-steps per second, and step loss can be injected, because the spec calls a
skipped step 'silent' and that is the design's main odometry risk.  odometry()
books exactly what a TMC2209 step counter would: the commanded steps, losses
included, integrated over the time each command was actually in force.

Everything below the "ground truth" marker exists only in simulation: the
referee and the check suites read it freely, mission code is losing it step
by step (design doc paragraph 13 -- pose and qvel go in step 3, see_lab is the
synthetic stand-in for the rendered camera pipeline that lands in step 2).
"""
import numpy as np, mujoco
from . import hal
from .params import Chassis, AgentA, Piece, Field, Vision, M2, mm

WHEEL_R = Chassis.WHEEL_D / 2000.0          # m
HALF_TRACK = Chassis.TRACK / 2000.0         # m
STEP_RAD = 2 * np.pi / Chassis.STEPS_PER_REV
# The IMU's imperfection, owned by the backend (hal.DriveHAL.gyro_z): an
# MPU6050-class gyro after the pre-match still-calibration keeps a residual
# bias, drawn ONCE per match, plus white noise per read.  deg/s.
GYRO_BIAS_SD  = 0.04
GYRO_NOISE_SD = 0.08


# How close robot 2 has to be before robot 1 slows for it, and how slow
# it gets.  Surface gap in mm between the two body models (F137).
FLEET_NEAR  = 150.0
FLEET_CRAWL = 80.0


class AgentARobot(hal.DriveHAL, hal.DeviceHAL):
    def __init__(self, model, data, step_loss=0.0, rng=None, vision="model",
                 nav="truth"):
        self.m, self.d = model, data
        self.rng = rng or np.random.default_rng(0)
        self.step_loss = step_loss
        self.fleet = None            # set by the runner; see rfgyc26.fleet
        self.fleet_name = "r1"
        self.fleet_blocked = False
        # "model": the synthetic camera (geometry + the Vision error budget,
        # fast -- the regression double).  "render": real frames through
        # mujoco.Renderer into perception.LabPipeline -- the same pixels-in
        # pipeline the Pi cameras feed, and the one that gates releases.
        # Headless machines need MUJOCO_GL=osmesa (or egl) for "render".
        self.vision_mode = vision
        self._pix = None
        # nav="est": .pose is the ESTIMATOR's belief -- odometry + gyro +
        # camera fixes, the only pose the real robot will ever have.  The
        # simulator's oracle stays available as .pose_truth for the referee,
        # the checks, and the estimator's own error report.  nav="truth" is
        # the A/B control and never touches the imu rng, so truth-mode runs
        # are bit-identical to the pre-estimator baseline.
        #
        # TRUTH IS STILL THE DEFAULT, deliberately (F85).  The estimator is
        # built and measured (check_estimator), but the hand-written route
        # was tuned for months around oracle navigation and measurably
        # cannot ride a 30 mm belief: 12 seeds went +93.2 -> -2.5 when the
        # flip was tried -- open-loop legs, blind loop exits, cascading
        # deadlines.  Hardening THAT route against honest navigation is the
        # planner and tracker's whole job (design doc steps 4-5); the
        # default flips to "est" when they land, not before.
        self.nav = nav
        self.est = None
        if nav == "est":
            # spawn: derives an independent stream WITHOUT advancing the
            # match rng, so vision-model noise draws stay aligned across
            # nav modes.
            self._rng_imu = self.rng.spawn(1)[0]
            self._gyro_bias = float(self._rng_imu.normal(0.0, GYRO_BIAS_SD))
            self._imu_th = None                 # set on the first flush
        gid = lambda t, n: mujoco.mj_name2id(model, t, n)
        self.bid   = gid(mujoco.mjtObj.mjOBJ_BODY, "agentA")
        self.a_l   = gid(mujoco.mjtObj.mjOBJ_ACTUATOR, "a_drive_l")
        self.a_r   = gid(mujoco.mjtObj.mjOBJ_ACTUATOR, "a_drive_r")
        self.a_fl  = gid(mujoco.mjtObj.mjOBJ_ACTUATOR, "a_finger_l")
        self.a_fr  = gid(mujoco.mjtObj.mjOBJ_ACTUATOR, "a_finger_r")
        self.a_shim  = gid(mujoco.mjtObj.mjOBJ_ACTUATOR, "a_shim")
        self.a_roller= gid(mujoco.mjtObj.mjOBJ_ACTUATOR, "a_roller")
        self.a_gate= gid(mujoco.mjtObj.mjOBJ_ACTUATOR, "a_gate")
        self.a_feed= gid(mujoco.mjtObj.mjOBJ_ACTUATOR, "a_feed")
        self.a_blade = gid(mujoco.mjtObj.mjOBJ_ACTUATOR, "a_blade")
        self.a_cr = [gid(mujoco.mjtObj.mjOBJ_ACTUATOR, "a_cradle1"),
                     gid(mujoco.mjtObj.mjOBJ_ACTUATOR, "a_cradle2")]
        self.eq_beam = [gid(mujoco.mjtObj.mjOBJ_EQUALITY, "beam%d_hold" % i)
                        for i in (1, 2)]
        self.s_tof = gid(mujoco.mjtObj.mjOBJ_SENSOR, "a_tof")
        self.s_gyro= gid(mujoco.mjtObj.mjOBJ_SENSOR, "a_gyro")
        self.s_mag = gid(mujoco.mjtObj.mjOBJ_SENSOR, "a_mag")
        self.a_trim= gid(mujoco.mjtObj.mjOBJ_ACTUATOR, "a_trim")
        self.j_trim= gid(mujoco.mjtObj.mjOBJ_JOINT, "A_trim_j")
        # Commanded-step odometry: wheel mm/s currently in force, the mm each
        # wheel has accumulated, and when the accumulator was last brought up
        # to date.  (Replaces odo_steps, which integrated each command over
        # ONE physics substep instead of the whole control period it was in
        # force -- a 20x under-count.  Nothing consumed it, so it never bit.)
        self._odo_v  = np.zeros(2)
        self._odo_mm = np.zeros(2)
        self._odo_t  = data.time

    # --------------------------------------------------------- where am I
    @property
    def pose_truth(self):
        """(x_mm, y_mm, heading_deg) ground truth.  SIM ONLY: the referee,
        the checks, and the estimator's error report.  Mission code gets
        .pose, which in nav="est" is the belief."""
        p = self.d.xpos[self.bid]
        q = self.d.qpos[3:7]
        th = np.degrees(np.arctan2(2*(q[0]*q[3]+q[1]*q[2]), 1-2*(q[2]**2+q[3]**2)))
        return p[0]*1000.0, p[1]*1000.0, th

    def _est(self):
        """The estimator, born on first use from the hand-placed start pose
        (the team sets the robot against its jig; that is knowledge).  Read
        from qpos, not xpos: qpos is valid straight from the XML, while
        xpos is zeros until the first mj_forward -- initialising from it
        once started the belief a metre away and the mission navigated to
        nowhere all match."""
        if self.est is None:
            from .estimator import Estimator
            jadr = self.m.jnt_qposadr[self.m.body_jntadr[self.bid]]
            q = self.d.qpos[jadr+3:jadr+7]
            th = np.degrees(np.arctan2(2*(q[0]*q[3]+q[1]*q[2]),
                                       1-2*(q[2]**2+q[3]**2)))
            self.est = Estimator(self.d.qpos[jadr]*1000.0,
                                 self.d.qpos[jadr+1]*1000.0, th)
        return self.est

    @property
    def pose(self):
        """(x_mm, y_mm, heading_deg) -- what the MISSION navigates on.
        nav="est": the estimator's belief, the only pose real hardware has.
        nav="truth": the oracle (A/B control, pre-estimator baseline)."""
        if self.nav == "est":
            return self._est().pose
        return self.pose_truth

    @property
    def pose_odo(self):
        """The jump-free ODOMETRY frame -- what terminals (the dock's
        relative machinery) track in, so a camera fix landing mid-approach
        cannot yank a frozen target (see estimator).  nav="truth": the
        oracle, which never jumps anyway."""
        if self.nav == "est":
            return self._est().odo_pose
        return self.pose_truth

    def speed(self):
        """Believed speed, mm/s -- frozen to zero while stalled, which is
        what makes stall_drive's is-it-moving test honest on both machines.
        nav="truth" reads the oracle so baseline behaviour is unchanged."""
        if self.nav == "est":
            return self._est().speed()
        return float(np.linalg.norm(self.d.qvel[0:2]))*1000.0

    def to_local(self, world_xyz):
        """TRUTH-frame world->robot -- a rig/check measurement helper."""
        x, y, th = self.pose_truth
        t = np.radians(th)
        dx, dy = world_xyz[0]*1000.0 - x, world_xyz[1]*1000.0 - y
        return (dx*np.cos(-t) - dy*np.sin(-t), dx*np.sin(-t) + dy*np.cos(-t), world_xyz[2]*1000.0)

    def chute_xy(self, offset_mm):
        """World position of the O58 chute axis -- it sits `offset` behind the axle."""
        x, y, th = self.pose
        t = np.radians(th)
        return x - offset_mm*np.cos(t), y - offset_mm*np.sin(t)

    def tof_mm(self):
        v = self.d.sensordata[self.m.sensor_adr[self.s_tof]]
        return 1e9 if v < 0 else v*1000.0

    # ------------------------------------------------------------ actuation
    def _odo_flush(self):
        """Book the command in force since the last flush -- and hand the
        same interval to the estimator: wheels, gyro, stall flag.  One
        source, two consumers; they can never disagree."""
        t = self.d.time
        if t > self._odo_t:
            dt = t - self._odo_t
            d_mm = self._odo_v * dt
            self._odo_mm += d_mm
            if self.nav == "est":
                # THE GYRO IS RATE-INTEGRATING.  Sampling gyro_z() once per
                # 20 ms flush and rectangle-integrating aliased every fast
                # transient -- a P-controlled pivot's decaying rate lost
                # 1-2 deg PER PIVOT and a contact-rich sweep jittered whole
                # degrees more; measured, heading drifted 7-11 deg by the
                # beam phase and took 250 mm of position with it.  A real
                # IMU integrates internally at kHz, so the honest model of
                # the DELTA it reports is the true yaw increment plus the
                # bias and noise we own.
                tt = self.pose_truth[2]
                if self._imu_th is None:
                    self._imu_th = tt
                dth = (tt - self._imu_th + 180.0) % 360.0 - 180.0
                self._imu_th = tt
                dth += self._gyro_bias*dt + \
                    float(self._rng_imu.normal(0.0, GYRO_NOISE_SD))*np.sqrt(dt)
                # 0.30, the threshold stall_drive itself trusts; the
                # estimator, not this flag, decides when steps are fiction.
                self._est().predict(float(d_mm[0]), float(d_mm[1]),
                                    dth, dt, stall_raw=self.stalled(0.30))
        self._odo_t = t

    def gyro_z(self):
        """Yaw rate, deg/s (hal.DriveHAL): the A_imu gyro, plus the
        per-match bias and per-read noise the contract demands.  nav="truth"
        reads it clean -- that mode is the oracle A/B control and draws
        nothing from any rng."""
        w = np.degrees(self.d.sensordata[self.m.sensor_adr[self.s_gyro] + 2])
        if self.nav == "est":
            w += self._gyro_bias + float(self._rng_imu.normal(0.0, GYRO_NOISE_SD))
        return float(w)

    def drive(self, v_mm_s, omega_deg_s):
        """Differential drive.  Wheel speeds are quantised to whole steps/s.

        ROBOT 1 NEVER BRAKES FOR ROBOT 2 (F125).  This is the whole of the
        collision protocol on this side, and the omission is the design.

        It used to stop here, mirroring a stop on robot 2's side, and two
        agents that both yield do not avoid each other -- they wedge.  Seed
        3, rendered: from T+72 the two chassis are in contact in the
        north-west and neither moves again for forty-eight seconds, robot 1
        holding a beam it never seals.  Robot 1 stopped because robot 2 was
        near; robot 2 could not leave because robot 1's body was the wall.
        The wait-for graph had a cycle, so it deadlocked, and no amount of
        adjusting the standoff removes a cycle.

        Prioritised planning (Erdmann and Lozano-Perez) breaks it by making
        the graph acyclic: the high-priority agent plans as though the other
        does not exist and simply executes; the low-priority agent plans in
        the space-time complement of that published trajectory and carries
        the entire avoidance burden.  Exactly one agent ever waits, so
        nothing can wait on a waiter.

        Robot 1 is that high-priority agent -- its stations are worth 18 to
        45 points for 10 to 35 seconds, against robot 2's +8 patient -- so
        all it owes the fleet is to say where it is, loudly and every tick,
        which is the observe() below.  Being predictable IS its half of the
        contract.  See rfgyc26.fleet for robot 2's half.
        """
        if self.fleet is not None:
            x, y, th = self.pose
            self.fleet.observe(self.fleet_name, (x, y, th), vel=abs(v_mm_s))
            # SPEED FOLLOWS CLEARANCE (F137).  Not braking for robot 2 is
            # right; driving at it unchanged is not.  With the veto gone
            # entirely, seed 1 measured 3511 ticks of robot-on-robot
            # contact between T+36.0 and T+37.8, peaking at 38 N -- eighteen
            # times the 2.1 N that started this whole line of work, and
            # quite enough to put both robots somewhere they did not plan
            # to be.
            #
            # A STOP is what deadlocks: two agents that both wait have a
            # cycle in their wait-for graph and sit in it, measured, for
            # forty-eight seconds.  A SPEED LIMIT has no such failure mode
            # -- robot 1 keeps moving, so nothing can wait on it -- and it
            # buys the same thing the stop was for: at 80 mm/s a touch is a
            # nudge rather than a shove, and robot 2's escape reflex has
            # time to work.  This is the clearance taper robot 2 already
            # uses on the laboratory plate (F121), applied to the one
            # obstacle robot 1 can see move.
            g = self.fleet.gap(self.fleet_name)
            self.fleet_blocked = g < FLEET_NEAR
            if self.fleet_blocked and v_mm_s != 0.0:
                f = float(np.clip(g / FLEET_NEAR, 0.0, 1.0))
                lim = FLEET_CRAWL + (abs(v_mm_s) - FLEET_CRAWL) * f
                v_mm_s = float(np.sign(v_mm_s)) * min(abs(v_mm_s),
                                                      max(lim, FLEET_CRAWL))
        self._odo_flush()
        v, w = v_mm_s/1000.0, np.radians(omega_deg_s)
        wl = (v - w*HALF_TRACK) / WHEEL_R
        wr = (v + w*HALF_TRACK) / WHEEL_R
        out = []
        for om in (wl, wr):
            steps = np.round(om / STEP_RAD)                    # whole steps/s
            if self.step_loss and self.rng.random() < self.step_loss:
                steps -= np.sign(steps)                        # a silent skipped step
            out.append(steps * STEP_RAD)
        self.d.ctrl[self.a_l], self.d.ctrl[self.a_r] = out
        # What odometry believes: the QUANTISED command, losses included --
        # which is precisely what the TMC2209's step counter would say.
        self._odo_v = np.array(out) * WHEEL_R * 1000.0

    def stop(self):
        self._odo_flush()
        self.d.ctrl[self.a_l] = self.d.ctrl[self.a_r] = 0.0
        self._odo_v[:] = 0.0

    def odometry(self):
        """(dL_mm, dR_mm) commanded wheel travel since the previous call."""
        self._odo_flush()
        dl, dr = self._odo_mm
        self._odo_mm[:] = 0.0
        return float(dl), float(dr)

    def fingers(self, opened=True):
        # RADIANS -- actuator ctrlrange is not converted by compiler angle="degree"
        if self.a_fl < 0:            # fingerless build: ctrl[-1] would hit the cradle
            return
        a = np.radians(AgentA.FINGER_OPEN if opened else AgentA.FINGER_RAKE)
        self.d.ctrl[self.a_fl] = a
        self.d.ctrl[self.a_fr] = -a

    def intake(self, collecting, rpm=None):
        """Knife down + brush roller spinning, or roller stopped + knife up.

        The knife is servo-lifted SHIM_LIFT deg on every non-collecting leg: pressed
        to the floor it bulldozes already-placed discs.  Ordering matters on
        the real machine -- spinning fingers strike a LIFTED knife tip (they
        clear a lowered one by ~2 mm) -- so the roller stops before the knife
        lifts and the knife drops before the roller starts; here both commands
        land the same tick and the model's masks make the order moot.
        """
        if self.a_shim < 0:
            return
        if collecting:
            self.d.ctrl[self.a_shim]   = np.radians(AgentA.SHIM_DROOP)
            self.d.ctrl[self.a_roller] = 2*np.pi*(rpm or AgentA.ROLL_RPM)/60.0
        else:
            self.d.ctrl[self.a_roller] = 0.0
            self.d.ctrl[self.a_shim]   = -np.radians(AgentA.SHIM_LIFT)

    # ------------------------------------------------------------ mission 2
    def _find_kits(self):
        if not hasattr(self, "_kit_eq"):
            self._kit_eq = []
            for i in range(64):
                e = mujoco.mj_name2id(self.m, mujoco.mjtObj.mjOBJ_EQUALITY,
                                      "kit%d_hold" % i)
                if e < 0: break
                self._kit_eq.append(e)
        return self._kit_eq

    def kits_aboard(self):
        eq = self._find_kits()
        return sum(1 for e in eq if self.d.eq_active[e])

    def drop_kits(self, n):
        """Release the next n kits, in index order.  Kept for the rigs."""
        eq = self._find_kits()
        live = [e for e in eq if self.d.eq_active[e]]
        for e in live[:n]:
            self.d.eq_active[e] = 0
        return min(n, len(live))

    def open_hopper(self, dest):
        """Open one destination's flap.  The rules let kits start ON the robot
        (g.1) and they are loaded already grouped, so this is the ONLY verb
        Mission 2 needs for a kit -- no pick-up, no sorting, no singulation.
        One MG90S per hopper, opened once each in the match.

        In the model it is a weld going inactive: the kits then fall under
        gravity from wherever the hopper is, and the referee reads where they
        land, exactly as it does for a beam.
        """
        eq = self._find_kits()
        n = 0
        for i in M2.KIT_GROUPS.get(dest, ()):
            if i < len(eq) and self.d.eq_active[eq[i]]:
                self.d.eq_active[eq[i]] = 0
                n += 1
        return n

    def feed(self, down):
        """Positive-feed plunger.  Parked its face is 33 mm above the highest a
        piece ever reaches, so the drop path stays clear; one stroke presses the
        column down onto the stack and re-seats anything shaken loose."""
        self.d.ctrl[self.a_feed] = -mm(AgentA.FEED_STROKE) if down else 0.0

    def gate(self, opened):
        """Escapement shelf: two leaves that carry the column and retract to
        OPPOSITE sides to release one.  The command is the coupled tendon's
        length, which is the sum of both leaf strokes -- one pinion, two racks
        (F68)."""
        self.d.ctrl[self.a_gate] = 2*mm(AgentA.ESC_Y) if opened else 0.0

    def blade(self, inserted):
        """Escapement retainer: two 1 mm knives that take the column at the
        joint above the bottom disc, so the shelf can retract from under just
        that one.  Parked they are clear of the bore."""
        self.d.ctrl[self.a_blade] = 2*mm(AgentA.ESC_BLADE_PARK) if inserted else 0.0

    def cradle(self, which, carry):
        """Beam cradle 1 (pocket R, beam 1) or 2 (pocket L, beam 2).

        carry=True lifts the beam CARRY_Z off the field -- which is how it
        crosses the laboratory and how the robot is allowed to pivot at all
        (F46).  carry=False sets it down on the field; the shelves then sit in
        the floor plane and the robot can simply back away from the piece.
        """
        a = self.a_cr[which - 1]
        if a >= 0:
            self.d.ctrl[a] = 0.0 if carry else mm(AgentA.CARRY_Z + AgentA.CRADLE_DROP)
        # The clamp goes with it: carried means wedged against the pocket wall,
        # released means standing on the field on its own (F50).
        e = self.eq_beam[which - 1]
        if e >= 0:
            self.d.eq_active[e] = 1 if carry else 0

    def cradle_down(self, which, tol=0.6):
        """Has the cradle finished its stroke?  A limit switch reads this."""
        j = mujoco.mj_name2id(self.m, mujoco.mjtObj.mjOBJ_JOINT, "A_cr%d_j" % which)
        full = AgentA.CARRY_Z + AgentA.CRADLE_DROP
        return self.d.qpos[self.m.jnt_qposadr[j]]*1000.0 > full - tol

    # ------------------------------------------------------------- trim slide
    def trim(self, y_mm):
        """Aim the posting head.  +y is the robot's LEFT (F68)."""
        if self.a_trim < 0:
            return
        self.d.ctrl[self.a_trim] = mm(float(np.clip(y_mm, -AgentA.TRIM_Y,
                                                    AgentA.TRIM_Y)))

    def trim_at(self):
        """Where the slide actually IS, mm -- a servo's own feedback pot."""
        if self.j_trim < 0:
            return 0.0
        return self.d.qpos[self.m.jnt_qposadr[self.j_trim]]*1000.0

    def trim_settled(self, tol=0.25):
        want = self.d.ctrl[self.a_trim]*1000.0 if self.a_trim >= 0 else 0.0
        return abs(self.trim_at() - want) < tol

    def mag_count(self):
        """Pieces in the magazine, from the bore rangefinder.  Empty reads the
        shelf at Za 11; each piece brings the surface up 5 mm."""
        r = self.d.sensordata[self.m.sensor_adr[self.s_mag]]
        if r < 0:                        # no return at all
            return 0
        top = 70.0 - r*1000.0            # site is at Za 70 looking down
        return int(max(0.0, round((top - AgentA.CHUTE_Z0) / Piece.DISC_T)))

    # ------------------------------------------------------------ perception
    def _cam(self):
        if not hasattr(self, "_cam_id"):
            self._cam_id = [mujoco.mj_name2id(self.m, mujoco.mjtObj.mjOBJ_CAMERA,
                                              "A_cam_%s" % t) for t in ("l", "r")]
            # THE EXTRINSIC IS A BIAS, NOT NOISE.  Where the camera plate sits
            # relative to the bore is a bracket on a robot that gets driven into
            # walls on purpose; it is wrong by the same amount all match, and a
            # model that redraws it every frame averages it away and flatters
            # itself.  Drawn once, at construction, from the match's own seed.
            self._ext = self.rng.normal(0.0, Vision.EXT_SIGMA, 3)
            self._ext_a = np.radians(self.rng.normal(0.0, Vision.EXT_ANG_SIGMA))
            # Per-SLOT detection bias: a rim fit's residual is a property of
            # that slot's marking and the angle it is seen from, so it is the
            # same all match for a given slot and different between slots.
            self._det = self.rng.normal(0.0, Vision.DET_BIAS,
                                        (len(Field.LAB_HOLE_X), 2))
        return self._cam_id

    def cam_frame(self, i=0):
        """(origin_world_mm, R) for one camera.  MuJoCo's camera looks down its
        own -z with +x right and +y up, which is also how a rectified pair is
        described, so the columns of R are the image axes."""
        c = self._cam()[i]
        return self.d.cam_xpos[c]*1000.0, self.d.cam_xmat[c].reshape(3, 3)

    def _project(self, p_world_mm, i=0):
        """(u, v, z) in pixels and mm along the view axis, or None if behind."""
        o, R = self.cam_frame(i)
        cam = R.T @ (np.asarray(p_world_mm, float) - o)
        z = -cam[2]
        if z <= 1e-6:
            return None
        f = Vision.f_px()
        return (f*cam[0]/z, f*cam[1]/z, z)

    def _visible(self, p_world_mm, i=0):
        """In frame AND in line of sight, for camera i.

        Occlusion is cast with mj_ray rather than argued about: the robot's own
        tail shell, the mast, a carried beam and the laboratory's lip are all in
        the model, so the honest test is whether the ray gets there.
        """
        uv = self._project(p_world_mm, i)
        if uv is None:
            return None
        u, v, z = uv
        if abs(u) > Vision.W/2 or abs(v) > Vision.H/2 or z > Vision.Z_MAX:
            return None
        o, _ = self.cam_frame(i)
        vec = np.asarray(p_world_mm, float) - o
        rng = np.linalg.norm(vec)/1000.0
        u3 = vec/np.linalg.norm(vec)
        # START THE RAY OUTSIDE THE HOUSING.  Cast from the optical centre it
        # hits the camera's own plate a few mm out and every slot reads
        # occluded.  45 mm clears the plate and the mast, and everything that
        # could really be in the way -- the tail shell, a carried beam, the
        # posting head -- is further out than that.
        SKIN = 0.045
        gid = np.zeros(1, np.int32)
        hit = mujoco.mj_ray(self.m, self.d, o/1000.0 + u3*SKIN, u3, None, 1, -1, gid)
        if hit >= 0 and hit < rng - SKIN - 0.0015:
            return None
        return (u, v, z)

    def _sees_slot(self, p, i):
        """Is the WHOLE rim of a slot centred at p in camera i's frame?

        Checked against an actual depth render: a blob that runs off the edge of
        the image has no centroid worth having, and the model was reporting
        those as measurements.  Four rim points catch it and cost nothing.
        """
        if self._visible(p, i) is None:
            return None
        r = Field.LAB_HOLE_D/2.0
        for o_ in ((r, 0, 0), (-r, 0, 0), (0, r, 0), (0, -r, 0)):
            if self._visible(p + np.array(o_), i) is None:
                return None
        return self._visible(p, i)

    def see_lab(self, plate_top=None):
        """Measure the laboratory's slots.  Returns [(x, y, z, mode)] in the
        ROBOT frame, for the slots the rig can actually see.

        Two modes, and they are different physics on the same pair of images:

          * 'stereo' -- the slot is in BOTH frames, so its centre triangulates.
            No disparity search, therefore no minimum range: this is why a
            self-built pair beats a depth-map module here, whose 173-697 mm
            floor would blind it for the whole approach.
          * 'mono'   -- only one camera has it, but the slot is a circle of
            KNOWN diameter (rules 3.2 give 60 mm), so its range comes from the
            apparent size instead.  Lateral is unaffected; range costs a factor
            of two, and lateral is the axis the trim slide spends.

        The error that survives either way is the plate-to-bore calibration and
        the mast's flex, which is why both are modelled as bias rather than
        noise -- see Vision.

        vision="render" swaps this synthetic model for the real thing: the
        frames are rendered and perception.LabPipeline measures them, with
        the same output contract.  (The rendered path carries the mount bias
        through its calibration; mast flex stays model-only for now -- the
        camplate is welded in the MJCF -- and the budget carries it as
        margin.)
        """
        if self.vision_mode == "render":
            return self._feed_est(self._see_lab_px())
        self._cam()
        top = Field.LAB_PLATE_T if plate_top is None else plate_top
        out = []
        # TRUTH pose: this block GENERATES the measurement, and a camera
        # measures relative geometry -- the physics does not care what the
        # robot believes.  The belief enters where it does on hardware: in
        # the estimator that consumes the measurement (_feed_est).
        x, y, th = self.pose_truth
        t = np.radians(th)
        speed = float(np.linalg.norm(self.d.qvel[0:2]))*1000.0
        flex = np.radians(Vision.FLEX_DEG * min(speed/Vision.FLEX_REF, 2.0))
        for si, hx in enumerate(Field.LAB_HOLE_X):
            p = np.array([hx, _LAB_HOLE_Y(), top])
            vis = [self._sees_slot(p, i) for i in (0, 1)]
            if vis[0] is None and vis[1] is None:
                continue
            i = 0 if vis[0] is not None else 1
            u, v, z = vis[i]
            both = vis[0] is not None and vis[1] is not None
            sl = Vision.sigma_lat(z)
            sz = (Vision.sigma_z_stereo(z) if both
                  else Vision.sigma_z_mono(z, Field.LAB_HOLE_D))
            # flex tilts the whole rig, so it moves the answer by range*angle
            sz = np.hypot(sz, z*flex)
            sl = np.hypot(sl, z*flex)
            f = Vision.f_px()
            o, R = self.cam_frame(i)
            m = np.array([(u*z/f) + self.rng.normal(0, sl) + self._det[si, 0],
                          (v*z/f) + self.rng.normal(0, sl) + self._det[si, 1],
                          -(z + self.rng.normal(0, sz))])
            ca, sa = np.cos(self._ext_a), np.sin(self._ext_a)
            m = np.array([ca*m[0] - sa*m[1], sa*m[0] + ca*m[1], m[2]]) + self._ext
            w = o + R @ m
            dx, dy = w[0] - x, w[1] - y
            out.append((dx*np.cos(-t) - dy*np.sin(-t),
                        dx*np.sin(-t) + dy*np.cos(-t),
                        w[2], "stereo" if both else "mono"))
        return self._feed_est(out)

    def _feed_est(self, out):
        """Every slot measurement is also an absolute fix: the slots' world
        positions are map knowledge.  Fed here, transparently, so route code
        neither knows nor cares that looking IS localising."""
        if self.nav == "est" and out:
            hy = _LAB_HOLE_Y()
            self._est().slot_fix(out, [(hx, hy) for hx in Field.LAB_HOLE_X])
        return out

    def _see_lab_px(self):
        """The rendered path: frames from the tail cameras, measurements from
        perception.LabPipeline.  Built lazily so the model-camera path never
        pays for a GL context -- and never consumes the rng draws the bias
        needs, keeping model-camera runs bit-identical with or without this
        code existing."""
        if self._pix is None:
            from . import perception
            cams = SimCameras(self.m, self.d, rng=self.rng)
            self._pix = (cams, perception.LabPipeline(cams.calib()))
        cams, pipe = self._pix
        imgL, imgR, _ = cams.frames()
        return pipe.slots(imgL, imgR)

    # ------------------------------------------------------------ stallguard
    def stalled(self, thresh=0.42):
        """TMC2209 StallGuard stand-in: both drivers at torque saturation.
        Unreliable below ~0.1 m/s, exactly as the real part is."""
        return (abs(self.d.actuator_force[self.a_l]) > thresh and
                abs(self.d.actuator_force[self.a_r]) > thresh)


def _LAB_HOLE_Y():
    """The laboratory's slot line.  Imported lazily so robot.py does not depend
    on mjcf.py at import time (mjcf imports params, params imports nothing)."""
    from .mjcf import LAB_HOLE_Y
    return LAB_HOLE_Y


class SimClock(hal.Clock):
    """The simulator's control tick: one tick = CTRL_DECIM physics substeps.

    Owns the decimation the run scripts hard-code today (1 kHz physics to
    50 Hz control), derived from the model's own timestep so a model change
    cannot silently skew the control rate.  The Pi's clock sleeps to the
    next 20 ms wall boundary instead; mission code cannot tell them apart.
    """
    def __init__(self, model, data, decim=None):
        self.m, self.d = model, data
        self.decim = decim or int(round(self.PERIOD / model.opt.timestep))

    def now(self):
        return self.d.time

    def tick(self):
        for _ in range(self.decim):
            mujoco.mj_step(self.m, self.d)


class SimCameras(hal.CameraHAL):
    """The tail pair, rendered: the simulator's CameraHAL.

    frames() renders both eyes offscreen at the perception resolution; the
    physics is untouched (rendering reads d, never writes it).  calib() is
    built from Vision.cam_pose -- the same statement the MJCF emits the
    <camera> tags from -- plus, when an rng is given, the per-match mounting
    bias, folded into the calibration rather than the render: the world does
    not move when a bracket is bent, the robot's belief does.
    """
    def __init__(self, model, data, rng=None):
        self.m, self.d = model, data
        self._r = None
        from . import perception
        self._calib = perception.sim_calib(rng)

    def _renderer(self):
        if self._r is None:
            self._r = mujoco.Renderer(self.m, Vision.H, Vision.W)
        return self._r

    def frames(self):
        r = self._renderer()
        r.update_scene(self.d, camera="A_cam_l")
        imgL = r.render().copy()
        r.update_scene(self.d, camera="A_cam_r")
        return imgL, r.render(), float(self.d.time)

    def calib(self):
        return self._calib
