Chandanpanda/ART-Forum-2017-Stan-Tutorial/sim/truss/spec.py

"""Single source of truth for the truss cell: the task, the machine, the fixture.

All lengths MILLIMETRES, masses GRAMS, angles DEGREES, forces NEWTONS.
Convert with mm()/g() at the point of use -- MuJoCo works in metres and
kilograms.

Three kinds of thing live here, and the distinction is the whole point of
the file (CLAUDE.md, "constants that ARE legitimate"):

  * FACTS about the world -- the stock's modulus, a NEMA17's step, the
    ring's outer diameter, the camera's pixel pitch.  Measured or bought.
  * THE RULES OF THE PRODUCT -- the angular budget, the tip masses, the
    mass ceiling, the prop excitation band.  Given by the brief.
  * A TASK SPEC -- one particular truss.  `Truss` is a dataclass, not a
    module constant, because the machine has to make more than one, and
    the default trusses are the OUTPUT of structure.design(): derived from
    the rules above, never typed in.

What is deliberately NOT here: joint positions, head poses, lift heights,
cage angles, tool paths, cycle times.  Those are answers, and the modules
that compute them (geometry, approach, schedule) take a Truss and a cell
spec as arguments so they answer for the next truss too.
"""
from dataclasses import dataclass
from math import (pi, tan, sin, cos, asin, acos, atan, radians, sqrt, floor,
                  ceil, atan2, degrees)


# ---------------------------------------------------------------- conversions
def mm(x):
    return x / 1000.0


def g(x):
    return x / 1000.0


# ============================================================= THE MATERIAL
class Stock:
    """Pultruded unidirectional carbon rod (brief 2.3, 3.1).

    The brief's own numbers: 230 GPa fibre at ~65 % volume fraction gives
    ~150 GPa axial for the rod; 11.3 g/m for 3 mm, which is 1.60 g/cm^3.
    Other diameters scale by area -- same fibre, same fraction.
    """
    E           = 150e3        # N/mm^2, axial modulus of the rod
    RHO_LIN_3   = 11.3         # g/m, 3 mm rod, measured
    TG          = 170.0        # deg C
    DIAMETERS   = (1.0, 1.5, 2.0, 3.0)      # what the shop keeps
    CUT_TOL     = 0.3          # mm, hand-cut length scatter (1 sigma) [VERIFY]

    @staticmethod
    def rho_lin(d):
        """g/m for a rod of diameter d."""
        return Stock.RHO_LIN_3 * (d / 3.0) ** 2

    @staticmethod
    def area(d):
        return pi * d * d / 4.0

    @staticmethod
    def I_rod(d):
        """Second moment of the rod's own section, mm^4."""
        return pi * d ** 4 / 64.0

    @staticmethod
    def density():
        """g/cm^3, from the measured linear density."""
        return Stock.RHO_LIN_3 / (Stock.area(3.0) * 1e-3)


class Carrier:
    """The camera's kitting carrier, and why there has to be one.

    THE GRIPPER CANNOT HOLD A CAMERA.  Its jaws open 8 mm -- sized for a
    3 mm rod with clearance -- and the module is 11.3 mm through its thin
    way, its metal enclosure 10.8 mm square.  Nothing on it is 8 mm except
    the lens barrel, and that is the one part a machine must not touch.

    AND OPENING THE JAWS IS NOT THE FIX.  The magazine's slot pitch is
    bounded below by JAW_OPEN/2 -- a rod has to clear the pads that
    straddle its neighbour -- and the diagonal racks pitch along x, and the
    gantry's X travel is already 1359 mm of 1400 on the chosen truss.  Jaws
    wide enough for the enclosure put the racks at 1409.  The machine would
    need a longer axis to be able to pick up a camera.  Both measured, in
    check_mount.

    So the module is pressed into a printed carrier at kitting -- the same
    manual step as pre-cutting the rods -- and the carrier presents a BOSS
    of the largest stock diameter, coaxial with the spine.  To the loader
    it is then a chord: the jaws already span it, the V already captures
    it, the rack pitch does not move, and the pose is yaw zero at any cage
    angle.  Nothing about the machine changes.

    IT GRIPS THE BOARD, NOT THE ENCLOSURE.  The six struts bond to the
    enclosure, so nothing of the carrier may be on it.  The carrier takes
    the board's two long edges instead -- the part the mount deliberately
    does not use, and the part the module's own designers put four holes
    in.
    """
    WALL        = 1.5          # mm, printed
    NEST_WALL   = 2.0          # mm, the kitting nest's pocket walls
    FIT         = 0.10         # mm interference on the board's edges
    MASS        = 2.0          # g [VERIFY: print one and weigh it]
    GRIP_CLEAR  = 4.0          # mm of boss beyond the pads, both ends

    @classmethod
    def nest_front(cls, payload=None, d_rod=1.5):
        """Where the nest's front wall stands from the module's centre, mm:
        one process clearance in front of the whole kit -- the grid, not the
        housing."""
        p = Payload if payload is None else payload
        return (p.BOX[1] / 2.0 - p.CASE_PROUD + cls.kit_proud(p, d_rod)
                + Process.SEAT_CLEAR)

    @classmethod
    def nest_over(cls, payload=None, d_rod=1.5):
        """(past the boss's root, across the boss) how far the NESTED kit
        reaches beyond the slot the magazine thinks it is racking, mm.

        THE SLOT IS THE BOSS AND THE PART IS NOT.  Off the boss's root hang
        the module, the collar and the wound grid, inside a printed pocket
        whose walls are outside those again -- 14.0 mm past the root and
        20.05 across it, against a boss of 3.  Racked as if the boss were
        the part, a kit's grid stood 1.30 mm inside the strut in the next
        slot: measured on the built scene, by the check that measures every
        racked part against everything it does not own.
        """
        p = Payload if payload is None else payload
        return (p.BOX[1] / 2.0 + cls.nest_front(p, d_rod) + cls.NEST_WALL,
                cls.kit_half(p, d_rod)[0] + cls.NEST_WALL)

    @classmethod
    def boss_d(cls):
        """The boss is a stock rod diameter ON PURPOSE: every clearance,
        capture and pitch rule in the cell has already been checked for
        it."""
        return max(Stock.DIAMETERS)

    @classmethod
    def boss_l(cls, payload=None, d_rod=1.5):
        """How long the boss has to be, mm.

        TWO RULES, and the second is the one that bites.  The pads have to
        take it with clearance either side -- and the HEAD has to be able to
        come down over it.  A head kit is not a rod: it is a 25 x 24 mm
        board with a collar on it and a tic-tac-toe of rods wound on that,
        standing in the rack perpendicular to the boss, so it reaches 18 mm
        above the grip point and 18 mm to one side of it.  The ring's
        raceway comes down to within 14.3 mm of the grip point at that
        offset -- so at a boss the pads alone would size, the head lands on
        the kit before the jaws reach the boss.  Measured, in the assembly
        run, as `rod35_p` against `race17`.

        WHAT IT IS MEASURED AGAINST IS THE WHOLE KIT.  The grid overhangs
        the collar by OVERRUN on all four sides and stands a layer above
        it; sized against the plate alone the boss is 4 mm short of what
        the part that actually arrives needs.

        The boss therefore reaches until the whole carrier is outside the
        head's static envelope: nothing of it within race_r_out() of the
        ring's centre when the gripper is down on the boss.
        """
        p = Payload if payload is None else payload
        pads = Gripper.PAD_L + cls.GRIP_CLEAR
        # the ring's centre sits this far above the grip point
        H = Head.GRIP_STROKE - Head.TIP_PARK
        R = race_r_out() + Process.SEAT_CLEAR
        # the carrier's nearest corner to the ring's axis, as a function of
        # how far the module's face is from the grip point
        half_z = max(p.BOX[2] / 2.0, Bracket.plate_half(p, d_rod)[1],
                     cls.kit_half(p, d_rod)[1])
        # the carrier's nearest corner to the ring's axis is its top edge at
        # the module's near face; push that face out until it clears
        gap = abs(H - half_z)
        need = 2.0 * sqrt(R * R - gap * gap) if gap < R else 0.0
        return max(pads, need)

    @classmethod
    def kit_half(cls, payload=None, d_rod=1.5):
        """(across the spine, across `up`) half-extents of the head kit as
        it arrives from station B, mm -- module, collar and the wound grid.

        WHAT THE CELL ACTUALLY HANDLES.  The grid overhangs everything else
        on the part, so the plate's outline is no longer the silhouette;
        the rack's pitch, the nest and the boss are all sized off this."""
        p = Payload if payload is None else payload
        gx, gu = Bracket.grid_half(p, d_rod)
        o = Bracket.overrun(d_rod) + d_rod / 2.0
        px, pu = Bracket.plate_half(p, d_rod)
        return (max(p.BOX[0] / 2.0, px, gx + o),
                max(p.BOX[2] / 2.0, pu, gu + o))

    @classmethod
    def kit_proud(cls, payload=None, d_rod=1.5):
        """How far the kit stands in front of the board's own face, mm --
        the collar's seat plus the two layers of grid on it."""
        return (Bracket.layer_l(1, payload, d_rod) + d_rod / 2.0
                - Bracket.seat_l(payload)[0])

    @classmethod
    def span(cls, payload=None):
        """What the jaws would have to open to if there were no carrier --
        the module's own thin way, and its enclosure's."""
        p = Payload if payload is None else payload
        return (p.BOX[1], p.CASE[0])

    @classmethod
    def reach(cls, standoff_mm, payload=None, d_rod=1.5):
        """How far past the chord ends the loaded carrier reaches, mm.

        THE BOSS IS RADIAL, NOT AXIAL, and that is what keeps this number
        down to the camera's own outer face.  Pointed along the spine it
        would add its whole length to the room the cage has to leave, and
        the racks that sit beyond the end plate would follow it.  Pointed
        out of the module's BACK -- 180 degrees from the optical axis, so
        it can never be in shot -- it costs nothing axially, and the cage
        turns it under the jaws exactly as it does a diagonal.

        WHAT REACHES IS THE KIT, not the module: the grid overhangs the
        board by OVERRUN on every side, so this is 6.5 mm further out than
        the board's own face and the cage's end freedom follows it.
        """
        p = Payload if payload is None else payload
        return standoff_mm + cls.kit_half(p, d_rod)[0]

    @staticmethod
    def boss_axis(look):
        """The boss's direction: straight out of the camera's back, so it
        is as far from the field of view as a direction can be."""
        import numpy as _np
        v = _np.asarray(look, float)
        return -v / _np.linalg.norm(v)


class Bracket:
    """The collar: ONE LASER-CUT ALUMINIUM PLATE per camera, and why.

    THE CAMERA HAS NO THREE-POINT SURFACE OF ITS OWN.  A hexapod needs its
    landings in a plane, spread, on something stiff.  The module offers two
    candidates and the frame model refuses both: its lens housing is the
    only surface in the end triangle's plane and is too thin to be a
    triangle (1.08 of the yaw budget), and its own mounting holes make a
    proper triangle and then work through FR4 that is twenty-six times
    softer than the strut bonded to it.

    SO: A FLAT PLATE PARALLEL TO THE BOARD, with a CLOSED SQUARE APERTURE
    cut to the lens housing.  The plate drops over the housing and seats on
    the board's front face; the housing is bonded on all FOUR flanks of the
    aperture.  That orientation is the whole correction, and it was found by
    looking at a render:

        THE PLATE USED TO BE A FIN STANDING ON EDGE, in the plane
        perpendicular to the spine -- parallel to the end triangle, which is
        where a hexapod's platform wants to be.  A fin through the camera's
        centre is INSIDE THE CAMERA.  It reached 4.60 mm either side of the
        module's mid-plane and the module is only 4.50 mm thick, so its back
        half, and the two grid rods laid along it, were buried in the PCB:
        6 of 19 elements at one end, the deepest 4.50 mm in.  Every number
        the mount reported was for a part that cannot exist.

    A plate on the housing can only lie parallel to the board.  It is the
    one orientation in which the aperture is a closed hole -- four walls of
    bond instead of three -- and in which nothing of the mount is behind the
    module's front face at all.

    WHAT THE PLATE IS SHAPED LIKE.  Not a solid rectangle: at the size the
    struts need it would be 3 g of aluminium per end against a 4 g camera.
    It is a FRAME -- a band round the rectangle the four grid rods lie on,
    four ribs in to a ring round the aperture.  The rods land on the band's
    corners, which is where a frame is stiffest, and every rod is bonded
    along the band rather than at a point.

    NOTHING HERE IS CHOSEN.  The aperture is the housing plus a bond gap;
    the ring is the aperture plus a wall; the band is a rod plus a wall
    either side; the plate's outline is where the grid has to be for the
    STRUTS to clear the module (see `grid_half`); and the mass is the cut
    area times the sheet.
    """
    SHEET       = 1.5          # mm, stock aluminium sheet
    E           = 69.0e3       # N/mm^2
    RHO         = 2.70e-3      # g/mm^3
    BOND_GAP    = 0.10         # mm, the aperture cut oversize for adhesive
    WALL        = 1.5          # mm of metal beside a cut edge

    @classmethod
    def overrun(cls, d_rod=1.5, thread_d=None, turns=None):
        """How far a grid rod runs past its crossing, mm.

        THE CROSSING HAS TO HAVE ROD EITHER SIDE OF IT to wind against
        rather than a rod end, and how much is the BAND'S OWN WIDTH: the
        turns are laid side by side along the rod, so half of them fall
        each side of the crossing, and past the last one the rod needs an
        end distance to bear on -- one diameter, as a lashing always does.

        4.0 was typed.  It is 2.05 mm on a 1 mm rod, and the difference is
        not cosmetic: this sets the kit's half-width, which sets the
        camera's standoff, which sets the cage's end freedom, which pushes
        the end racks along the gantry's X -- and at 4.0 the largest truss
        the cell is specified to build wants 1403 mm of the brief's 1400.
        """
        from dataclasses import fields as _fields
        if thread_d is None:
            thread_d = next(f.default for f in _fields(Truss)
                            if f.name == "thread_d")
        if turns is None:
            turns = StationB.TURNS
        return float(turns) * float(thread_d) / 2.0 + float(d_rod)

    @classmethod
    def aperture(cls, payload=None):
        """(across the spine, across `up`) of the square hole the lens
        housing passes through, mm.  Cut from the housing, not chosen."""
        p = Payload if payload is None else payload
        return (p.CASE[0] + 2.0 * cls.BOND_GAP, p.CASE[1] + 2.0 * cls.BOND_GAP)

    @classmethod
    def bond_area(cls, payload=None):
        """mm^2 in shear: four aperture walls against four housing flanks.

        A CLOSED aperture is worth having for this alone -- the fin's open
        slot could only touch three sides, and one of those was the housing's
        rear face, which is where the plate met the board."""
        p = Payload if payload is None else payload
        return 2.0 * (p.CASE[0] + p.CASE[1]) * cls.SHEET

    @classmethod
    def seat_l(cls, payload=None):
        """(lo, hi) of the plate along the viewing direction, mm from the
        module's centre.  It seats on the board's FRONT FACE -- that is what
        squares the camera to the truss -- and must finish inside the height
        the housing stands proud, or the aperture's walls are not all in
        contact with it."""
        p = Payload if payload is None else payload
        lo = p.BOX[1] / 2.0 - p.CASE_PROUD
        return (lo, lo + cls.SHEET)

    @classmethod
    def ring_half(cls, payload=None):
        """(half across the spine, half across `up`) of the ring of metal
        round the aperture."""
        a = cls.aperture(payload)
        return (a[0] / 2.0 + cls.WALL, a[1] / 2.0 + cls.WALL)

    @classmethod
    def grid_half(cls, payload=None, d_rod=1.5, clear=None):
        """(|x|, |up|) of the four grid rods in the camera's frame, mm --
        and so of the four crossings the struts land on.

        ONE CLEARANCE OUTSIDE THE MODULE'S OWN SILHOUETTE, on every side.
        That is not tidiness, it is what makes the mount buildable: the
        camera looks out through a FACE of the truss, so one chord lies
        directly behind it, and a strut from that chord can only reach the
        grid without passing through the board if it stays outboard of the
        board in x the whole way.  It starts outboard (the chord ends are
        `standoff` back, and the standoff is half the board plus a
        clearance); it stays outboard only if the crossing it runs to is
        outboard too.  Inboard of this the mount is drawn through the PCB.
        """
        p = Payload if payload is None else payload
        c = Process.SEAT_CLEAR if clear is None else clear
        return (p.BOX[0] / 2.0 + c + d_rod / 2.0,
                p.BOX[2] / 2.0 + c + d_rod / 2.0)

    @classmethod
    def plate_half(cls, payload=None, d_rod=1.5, clear=None):
        """(half across the spine, half across `up`) of the plate's outline,
        mm: the grid, plus enough metal for the rod to lie wholly on it."""
        gx, gu = cls.grid_half(payload, d_rod, clear)
        return (gx + d_rod / 2.0, gu + d_rod / 2.0)

    # THE FLANGE, and why a flat plate will not do.  A 1.5 mm frame reaching
    # 15 mm from the aperture to a crossing is 149 N/mm out of its own plane
    # against a strut's 5616 -- thirty-eight times softer, which is the same
    # failure the module's own circuit board was rejected for.  Bent BACK
    # along the module's flanks (outboard of the board, so it fouls nothing
    # and stays behind the lens) the same sheet becomes a channel, and the
    # stiffness goes as the cube of the fold.  `flange_h` solves for it.
    # AND THE TRADE SAYS DO NOT FOLD IT.  With the ring carrying the band's
    # real section, the collar's own bending costs 0.001 of the yaw budget
    # and every millimetre of fold costs 0.011 in mass:
    #
    #     fold 0.0 mm   2.49 g    149 N/mm    budget 0.815
    #     fold 3.0 mm   3.97 g   2156 N/mm    budget 0.848
    #     fold 4.9 mm   4.91 g   6125 N/mm    budget 0.869   <- the rule's answer
    #     rigid, at 3.97 g                    budget 0.849
    #
    # The last row is the point: a plate assumed INFINITELY stiff at the
    # folded plate's mass is no better than the folded plate, so what the
    # fold buys is already worth nothing.  The stiffness rule the fillet
    # uses -- be stiffer than the strut you hold -- asks for 4.9 mm here and
    # is simply the wrong rule for a part whose mass is a tenth of the head.
    # check_mount re-runs the trade rather than trusting this comment.
    FLANGE      = 0.0          # mm, chosen by that trade and no other way
    FLANGE_STEP = 0.1          # mm, `flange_h` solves to this

    @classmethod
    def flange_room(cls, payload=None):
        """How deep the fold may be, mm: from the plate's seat back along
        the module, no further than the module itself."""
        p = Payload if payload is None else payload
        return cls.seat_l(payload)[0] + p.BOX[1] / 2.0

    @classmethod
    def band_I(cls, d_rod=1.5, flange=0.0):
        """Second moment of the band's section about the axis in the sheet,
        mm^4 -- a strip of sheet with a fold at its outer edge."""
        w, t, h = cls.band_w(d_rod), cls.SHEET, float(flange)
        a1, y1 = w * t, t / 2.0
        a2, y2 = t * h, t + h / 2.0
        if a2 <= 0.0:
            return w * t ** 3 / 12.0
        yb = (a1 * y1 + a2 * y2) / (a1 + a2)
        return (w * t ** 3 / 12.0 + a1 * (y1 - yb) ** 2
                + t * h ** 3 / 12.0 + a2 * (y2 - yb) ** 2)

    @classmethod
    def band_A(cls, d_rod=1.5, flange=0.0):
        """Area of the band's section, mm^2 -- the strip plus its fold."""
        return cls.band_w(d_rod) * cls.SHEET + cls.SHEET * float(flange)

    @classmethod
    def flange_h(cls, k_strut, payload=None, d_rod=1.5, clear=None):
        """The least fold that would keep the PLATE from being the
        compliance, mm -- the answer the fillet's rule gives, kept so
        check_mount can price it and show it is not worth buying."""
        room = cls.flange_room(payload)
        h = 0.0
        while h < room:
            if cls.corner_k(d_rod, payload, clear, h) >= k_strut:
                return h
            h += cls.FLANGE_STEP
        return room

    @classmethod
    def band_w(cls, d_rod=1.5):
        """Width of the frame's band, mm: a rod and a wall either side.  A
        rod bonds along the band, so this is the width of the bond, not a
        clearance."""
        return d_rod + 2.0 * cls.WALL

    @classmethod
    def layer_l(cls, i, payload=None, d_rod=1.5):
        """Centre of grid layer i along the viewing direction, mm from the
        module's centre.  Layer 0 lies on the plate's front face; layer 1
        lies on layer 0 and is wound to it where they cross."""
        return cls.seat_l(payload)[1] + (i + 0.5) * d_rod

    @classmethod
    def area(cls, payload=None, d_rod=1.5, clear=None, flange=0.0):
        """mm^2 of sheet actually cut: the band, four ribs, the ring, and
        the fold that is bent back off the outline."""
        ax, au = cls.plate_half(payload, d_rod, clear)
        rx, ru = cls.ring_half(payload)
        apx, apu = cls.aperture(payload)
        w = cls.band_w(d_rod)
        band = 4.0 * (ax * au - (ax - w) * (au - w))
        ring = 4.0 * (rx * ru - apx * apu / 4.0)
        ribs = 2.0 * w * max(0.0, (ax - w) - rx) + 2.0 * w * max(0.0, (au - w) - ru)
        fold = 2.0 * (2.0 * ax + 2.0 * au) * float(flange)
        return band + ring + ribs + fold

    @classmethod
    def mass(cls, payload=None, d_rod=1.5, clear=None, flange=0.0):
        """g, computed from the cut, not guessed."""
        return cls.area(payload, d_rod, clear, flange) * cls.SHEET * cls.RHO

    @classmethod
    def corner_k(cls, d_rod=1.5, payload=None, clear=None, flange=None):
        """N/mm at a crossing, out of the plate's plane -- the frame's own
        stiffness where a strut lands on it, and the link the frame model
        carries between a landing and the camera's mass.

        The corner of a rectangular frame loaded normal to its plane bends
        the two bands meeting there; taken as two cantilevers of a half-side
        each, which is the soft reading.  It is NOT a check that the plate
        passes or fails -- it is the number spine prices, because a plate
        stiff enough to ignore and one soft enough to matter differ by a
        fold and nothing else."""
        ax, au = cls.plate_half(payload, d_rod, clear)
        I = cls.band_I(d_rod, 0.0 if flange is None else flange)
        return sum(3.0 * cls.E * I / L ** 3 for L in (ax, au))


class StationB:
    """The SUB-ASSEMBLY STATION: it makes the camera's head kit.

    WHY THERE ARE TWO MACHINES.  The mount's four tic-tac-toe rods are
    wound to each other at four crossings, with the same thread the truss's
    joints use -- that is what makes them a joint and not a dab.  The main
    cell cannot do it: its ring is 40 mm across in a raceway 54 mm across,
    and by the time the mount goes on, the crossings sit inside the end
    triangle with the camera behind them.  There is no approach.

    So the crossings are wound BEFORE the camera ever reaches the truss, on
    a station whose only job is that one part.  It is a small machine
    because the part is small: the whole kit fits in 40 mm.

    WHAT IT MAKES, and it is exactly what `mount.solve` expects to find:
    the module, the collar bonded round its lens housing, and the four grid
    rods laid on the collar in two layers and wound at their four
    crossings.  `stationb.Kit` derives that from the same `Bracket` numbers
    the mount does, so the two cannot drift apart.

    WHAT IT DOES NOT DO.  The finished kit is taken out of B and put into
    A's receptacle BY HAND.  That is not a gap in the automation -- a
    wound, bonded, cured sub-assembly carrying a camera is exactly where a
    QC step belongs, and a person is already there to do it.
    """
    # where the station sits in the cell's own coordinates, mm
    ORIGIN      = (0.0, -520.0, 0.0)
    # its gantry: small, because the part is
    # AS BUILT, and `reach` computes what the layout needs; check_stationb
    # holds these against it, the way check_geometry holds the cell's.
    X_TRAVEL    = 260.0
    Y_TRAVEL    = 260.0
    Z_TRAVEL    = 120.0
    V_MAX       = {"x": 60.0, "y": 60.0, "z": 40.0}
    A_MAX       = {"x": 400.0, "y": 400.0, "z": 300.0}
    SETTLE_S    = 0.10
    STALL_N     = {"x": 60.0, "y": 60.0, "z": 60.0}
    # the nest that holds the module, lens UP
    NEST_WALL   = 2.0
    NEST_H      = 6.0
    # the winder.  A ring again, and much smaller: what it has to pass over
    # is a crossing of two rods, not a cluster of five.
    RING_ID     = 14.0
    RING_OD     = 22.0
    RING_W      = 3.0
    RING_GAP    = 70.0         # deg of open mouth, to admit the rod
    RING_RPM    = 90.0
    RING_SPINUP_S = 0.4
    TURNS       = 14           # per crossing [VERIFY on the joint rig]
    # the gripper: the same jaws, because the rods are the same rods
    LIFT_CLEAR  = 3.0
    # THERE IS NO PLACE CLEARANCE.  A tool that hovers a millimetre over
    # where the part goes leaves the part a millimetre out, because the
    # keeper welds it where the tool left it -- and the frame collected that
    # millimetre twice, once onto the jig and once onto the collar.  The
    # tool lands the part; the stroke ends when it stops.
    # ...AND A VACUUM HEAD, because the collar is not a rod.  It is a flat
    # frame 1.5 mm thick lying face up; parallel jaws can only take it by an
    # edge, and an edge grip cannot be turned face-down again without an
    # axis B does not have.  Suction on the face is what a machine picks a
    # flat part up with -- and on THIS part, four pads on the ring round the
    # aperture, which is the only metal at its centre.  See `vac_pads`.
    # WHERE EACH TOOL SITS ON THE CARRIAGE, mm from the winder's centre.
    # The plan has to aim the TOOL, not the carriage; the cell's own plan
    # does the same with Head.grip_x().  Left out, B drove its carriage to
    # each rack slot and closed its jaws 34 mm away from the rod -- and the
    # frames showed four rods that never left the rack.
    TOOL_CLEAR  = 2.0          # mm between a tool and the winder's rim
    VAC_KPA     = 60.0         # kPa of vacuum at the cup [device]
    VAC_STROKE  = 40.0
    # THE JIG: where the tic-tac-toe is built and wound, off the camera.
    # Hardware, both of these -- a plate and four turned posts.  WHERE the
    # posts stand is not hardware and is not here; `Kit.jig_posts` solves
    # it against the winder's own swept solid.
    POST_D      = 3.0          # mm, jig post
    JIG_BASE_T  = 3.0          # mm, jig base plate

    # ...and where each tool sits, DERIVED: just clear of the winder's own
    # rim, on three sides of it.  34 and 30 were numbers I wrote down.
    @classmethod
    def grip_off(cls):
        return (cls.ring_r_out() + Gripper.BODY_W / 2.0 + cls.TOOL_CLEAR, 0.0)

    @classmethod
    def disp_off(cls):
        return (-(cls.ring_r_out() + Dispenser.BODY_W / 2.0 + cls.TOOL_CLEAR), 0.0)

    # ...AND THE VACUUM HEAD IS FOUR PADS, not a cup.
    #
    # A CUP NEEDS FLAT METAL AND THE COLLAR IS MOSTLY HOLE.  The one piece of
    # it at the plate's own centre is the RING round the aperture -- a
    # square annulus one WALL wide -- so the head is four pads on that ring.
    # Centred, so the plate lifts balanced; and outside the aperture, so it
    # clears the lens housing standing through it.  A solid cup inside the
    # aperture was what was drawn, and it rode up on the housing and left
    # the collar 1.6 mm proud of its seat -- measured, and visible in the
    # frames as a plate floating over a camera.
    @classmethod
    def vac_pads(cls, payload=None):
        """((cx, cy), (hx, hy)) of the four pads, mm, in the collar's own
        plane."""
        ax, au = [v / 2.0 for v in Bracket.aperture(payload)]
        rx, ru = Bracket.ring_half(payload)
        w = Bracket.WALL / 2.0
        return (((0.5 * (ax + rx), 0.0), (w, au)),
                ((-0.5 * (ax + rx), 0.0), (w, au)),
                ((0.0, 0.5 * (au + ru)), (ax, w)),
                ((0.0, -0.5 * (au + ru)), (ax, w)))

    @classmethod
    def vac_half(cls, payload=None):
        """(x, y) half-extent of the head, mm -- the ring's own outline."""
        return Bracket.ring_half(payload)

    @classmethod
    def vac_hold_N(cls, payload=None):
        """What the head can lift, N, at its own vacuum over its own pads."""
        a = sum(4.0 * h[0] * h[1] for _c, h in cls.vac_pads(payload))
        return cls.VAC_KPA * 1e3 * a * 1e-6

    @classmethod
    def vac_off(cls):
        return (0.0, cls.ring_r_out() + cls.vac_half()[1] + cls.TOOL_CLEAR)

    @classmethod
    def tool_lift(cls, kit):
        """How far above the winder's own centre each tool's tip is seated
        when it is retracted, mm.

        THE TOOLS SHARE A CARRIAGE WITH THE RING, and when the ring is
        winding, its centre is ON the crossing -- so a tool whose tip sits
        at the carriage's own height is at the crossing's height too, and
        the dispenser's nozzle stands 20 mm away in x, which on this kit is
        directly over a grid rod.  A tool has to be seated clear of the
        tallest thing the ring straddles.

        The gripper's pads reach PAD_UNDER below its grip point, so that
        comes off the same budget: seat them all by the worst of the
        three."""
        over = kit.work_above_crossing()
        return over + Process.SEAT_CLEAR + Gripper.PAD_UNDER

    @classmethod
    def tool_stroke(cls, kit):
        """How far a tool has to be able to reach below its seat, mm.

        The carriage flies at the height the WINDER needs and every tool
        works from there, so the stroke is the whole drop from the cruise
        height to the lowest thing a tip has to touch.  40 was a number."""
        return (kit.cruise_z() + cls.tool_lift(kit) - kit.lowest_tip()
                + cls.LIFT_CLEAR)

    @classmethod
    def reach(cls, kit):
        """(x, y) half-extents the CARRIAGE must cover, mm -- every place a
        tool has to be, offset by that tool's own seat.  What the travels
        are held against."""
        pts = []
        for tool, off in (("grip", cls.grip_off()), ("disp", cls.disp_off()),
                          ("vac", cls.vac_off())):
            for _k, _i, a, b in kit.rack_slots():
                pts.append((0.5 * (float(a[0]) + float(b[0])) - off[0],
                            0.5 * (float(a[1]) + float(b[1])) - off[1]))
            for q in kit.crossings():
                pts.append((float(q[0]) - off[0], float(q[1]) - off[1]))
            for r in kit.rods:
                pts.append((float(r.mid[0]) - off[0], float(r.mid[1]) - off[1]))
            pts.append((-off[0], -off[1]))
        return (max(abs(p[0]) for p in pts), max(abs(p[1]) for p in pts))

    @staticmethod
    def ring_r_in():
        return StationB.RING_ID / 2.0

    @staticmethod
    def ring_r_out():
        return StationB.RING_OD / 2.0

    @classmethod
    def bore_margin(cls, d_rod):
        """How much the winder's bore clears the crossing it wraps, mm.

        The crossing is two rods at right angles, one lying on the other,
        so what has to pass through the bore is d_rod deep and d_rod wide
        -- a circumradius of d_rod/sqrt(2) about the contact."""
        return cls.ring_r_in() - d_rod * sqrt(2.0) / 2.0


# ============================================================ THE PRODUCT
class Load:
    """The stereo rig's load case and budgets (brief 2.2, 2.3, 6).

    The spine is centre-mounted, so each half is a cantilever with a camera
    head at its tip.  The budget is ANGULAR: relative yaw between the two
    camera faces, which is bending slope at the tips and nothing a
    software calibration can absorb (brief 2.2).
    """
    # ONE CAMERA HEAD.  This was a flat 50 g, carried from the brief, and
    # it is the most consequential number in the design: it sets the tip
    # force, dominates the Rayleigh mass, and so fixes both the angular
    # budget and the first mode.  The module is 4 g.  Derived from the part
    # now, so it cannot drift away from it again.
    BRIEF_TIP_MASS  = 50.0     # g, the brief's assumption -- kept because
                               # its published 228 Hz is reproducible only
                               # against the head it was computed with
    LATERAL_G       = 3.0      # manoeuvre load, multiples of gravity
    G               = 9.81
    SLOPE_BUDGET    = 0.005    # deg, total angular drift, both faces
    # A DESIGN MARGIN, NOT A TUNING: the brief's own worked truss sits at
    # half the budget (0.0025 of 0.005), and half is what is left for the
    # thermal soak, the joints' creep and the mount.  The optimiser designs
    # to SLOPE_BUDGET / SLOPE_SF.
    SLOPE_SF        = 2.0
    F1_MIN          = 200.0    # Hz, first bending mode with the tip masses
    BLADE_PASS      = (200.0, 330.0)   # Hz, 5-7 in props at 6-10 krpm
    # The spine's own mode may sit in that band -- the brief soft-mounts
    # it for exactly that reason -- but a MEMBER mode must sit above it: a
    # diagonal ringing at blade-pass is a joint being fatigued at 300 Hz,
    # and one below the band is crossed on every spin-up.
    MEMBER_F_MIN    = 330.0
    # The joint recipe (turns, tension, band) is qualified by the bench
    # DoE at one geometry; a diagonal angle outside this range is a joint
    # nobody has pulled to 50 N.  Also the range within which a mitre is a
    # mitre rather than a scarf.
    ALPHA_RANGE     = (35.0, 55.0)
    MASS_MAX        = 70.0     # g, 1 m truss acceptance (brief 6)
    MASS_MAX_300    = 25.0     # g, the 300 mm truss (target 19)
    # The airframe mount.  A deeper section is always stiffer and lighter
    # per joint, so without an envelope the optimiser runs to infinity; the
    # envelope is a fact about the product, not about the truss.  The
    # brief's own design is a 90 mm triangle.
    SECTION_MAX     = 100.0    # mm, largest triangle side the mount takes
    BUCKLE_SF       = 5.0      # chord Euler load over its working load
    TEST_FORCE      = 1.5      # N at the cantilever tip (brief 6)

    @classmethod
    def tip_mass(cls):
        """g, one camera head: the module plus what terminates on it."""
        return Payload.MASS + Payload.HEAD_EXTRA


# ================================================================ THE TASK
@dataclass(frozen=True)
class Truss:
    """One truss: what the machine is asked to make.

    Warren, triangular section, three continuous chords, zigzag diagonals
    on each of the three faces, no verticals (brief 3.1, 4.2).  The joint
    recipe rides with it because a joint is part of the product.

    THE FACES INTERLEAVE.  Each chord carries the diagonals of two faces.
    If both zigzags put a node at the same x the joint would take FOUR
    mitred ends, which the ring cannot wind past and the brief forbids
    ("two diagonals meet at each joint").  So face f's nodes sit on one
    chord at even multiples of the run and on the other at odd, and every
    chord ends up with a joint every `run`, alternating faces.

    `alpha` is the angle of the diagonal's CENTRELINE to the chord, and
    `run` follows from it and the lateral span the centreline actually
    crosses: the chord-to-chord side minus one chord diameter, because the
    diagonal's ends lie against the chords' surfaces, not on their axes.
    """
    length:     float           # mm, chord length
    side:       float           # mm, chord axis to chord axis
    alpha:      float           # deg, diagonal centreline to chord
    d_chord:    float = 3.0
    d_diag:     float = 2.0
    end_margin: float = 25.0    # mm of chord beyond the last joint, each end
    n_chords:   int   = 3
    # the joint recipe (brief 3.2) -- the bench DoE owns the real values
    turns:      int   = 18
    band:       float = 8.0     # mm, wound band width
    thread_d:   float = 0.15    # mm, Kevlar
    thread_rho: float = 1.44    # g/cm^3
    tension:    float = 2.0     # N, winding tension [VERIFY by DoE]
    joint_mass: float = 0.15    # g, thread + resin, the target
    name:       str   = "truss"

    # ---------------------------------------------------------- section
    @property
    def R(self):
        """Circumradius: chord axes sit on this circle."""
        return self.side / sqrt(3.0)

    @property
    def s_eff(self):
        """Lateral span of a diagonal's centreline, surface to surface."""
        return self.side - self.d_chord

    @property
    def run(self):
        """Axial pitch of the joints on any one chord."""
        return self.s_eff / tan(radians(self.alpha))

    @property
    def n_nodes(self):
        """Joints per chord, all faces counted."""
        return int(floor((self.length - 2.0 * self.end_margin) / self.run)) + 1

    @property
    def x0(self):
        """x of the first joint; the grid is centred on the chord."""
        return (self.length - (self.n_nodes - 1) * self.run) / 2.0

    @property
    def n_diag(self):
        return self.n_chords * (self.n_nodes - 1)

    @property
    def n_joints(self):
        return self.n_chords * self.n_nodes

    @property
    def L_diag(self):
        """Centreline length, tangent plane to tangent plane."""
        return sqrt(self.run ** 2 + self.s_eff ** 2)

    @property
    def L_cut(self):
        """Rod length as CUT, tip to tip along the longest generatrix: each
        mitre adds half a diameter over the tangent of the angle."""
        return self.L_diag + self.d_diag / tan(radians(self.alpha))

    @property
    def mitre_face(self):
        """Length of the flat the mitre presents along the chord."""
        return self.d_diag / sin(radians(self.alpha))

    def bind_half(self, thread_d=None):
        """Half-width of the band that actually BINDS, mm.

        A diagonal touches the chord only at the joint; a hoop laid `dx`
        along the chord finds it standing off by dx*tan(alpha) less its own
        half-section across the chord, d_diag/(2 cos alpha), so the two
        members are within a thread of each other only while

            |dx| <= d_diag / (2 sin alpha)  +  d_thread / tan alpha

        and a hoop laid outside that wraps the CHORD ALONE, passing under
        the diagonals.  Measured, wound, in check_ring: hoops at 3 mm from
        a 45-degree joint sat at 1.24 mm radius where the members' convex
        hull reaches 6.4 -- the thread does not bridge, it beds.  So the
        recipe's 8 mm band binds over 1.9 mm of its width and the rest is
        thread on a chord; the resin and the keeper hold the rest.
        """
        a = radians(self.alpha)
        d_t = self.thread_d if thread_d is None else thread_d
        return self.d_diag / (2.0 * sin(a)) + d_t / tan(a)

    # -------------------------------------------------------------- mass
    @property
    def mass_chords(self):
        return self.n_chords * self.length * Stock.rho_lin(self.d_chord) / 1000.0

    @property
    def mass_diags(self):
        return self.n_diag * self.L_cut * Stock.rho_lin(self.d_diag) / 1000.0

    @property
    def mass_joints(self):
        return self.n_joints * self.joint_mass

    @property
    def mass(self):
        return self.mass_chords + self.mass_diags + self.mass_joints

    def joint_x(self):
        """The joint grid along any chord."""
        return [self.x0 + i * self.run for i in range(self.n_nodes)]


# ============================================================ THE MACHINE
@dataclass(frozen=True)
class Mesh:
    """A solved gear mesh: what Ring.mesh() found (all mm, MPa)."""
    m:         float        # module
    n_ring:    int          # teeth on the rim
    n_pinion:  int
    r_pitch:   float        # ring's pitch radius
    r_pinion:  float        # pinion's pitch radius
    centre:    float        # ring centre to pinion centre
    tip_r:     float        # how far the pinion's tip reaches from the ring centre
    sigma:     float        # MPa in the pinion's tooth root at DRIVE_TORQUE

    @property
    def ratio(self):
        """Ring turns per pinion turn."""
        return self.n_pinion / float(self.n_ring)


_RING_MEMO = {}


class Ring:
    """The winding head: a gapped ring in a raceway, driven on its teeth by
    phased pinions.

    WHY IT IS DRIVEN FROM ITS EDGE.  A ring that encircles a rod cannot
    have a shaft through it -- the rod is where the shaft would go -- so
    the drive acts on its rim.  That is an orbital welding head, scaled
    down, and the mechanism is not in doubt.  What was wrong was the
    detail, and three faults were measured in the first version:

      * THE SPOOL AND THE DRIVE WANTED THE SAME SURFACE.  The spool block
        swept 20 to 32 mm of radius on the rim; a 6 mm friction wheel
        pressed on that rim occupies 20 to 32 mm too, and sat axially on
        the 4 mm ring inside the spool's own 14.  The orbiting spool
        struck each drive wheel once a revolution.  Nothing caught it
        because both were lumped into one head solid and a head is not
        checked against itself.
      * NOTHING LOCATED THE RING.  Two friction wheels are a drive, not a
        bearing, and no guide roller was ever specified.
      * THE FRICTION HAD NO MARGIN.  The thread tension alone asks about
        0.022 N.m about the ring's axis against a slip torque of 0.03 that
        was itself a guess, and friction slips silently, which is why the
        turns had to be counted by a fiducial rather than known.

    WHAT REPLACES IT, and what the geometry refused on the way.  Closing
    the gap for winding was tried first: a gate of the gap's own arc,
    slid aside to admit the rod.  The clearance solver refused it, and the
    reason generalises -- parked aside, the gate still spans the ring's
    full radial depth pointing at the work, so on the way down it scrapes
    the chord, and moved radially instead it fouls the pin arm.  There is
    nowhere clear for a gate to park.  So the gap stays open, and what is
    fixed is the drive:

      * TEETH, NOT FRICTION.  The rim is toothed and driven by pinions, so
        the turns are known at the motor rather than inferred, and the
        torque margin is a tooth's, not a coefficient's.
      * THREE PINIONS, PHASED, ON ONE BELT.  Spaced wider than the gap, so
        at least two are always meshed, and rigidly synchronised so a
        pinion re-enters the teeth in phase after the gap has passed it.
        One motor, not three: three independently commanded shafts geared
        to one ring are an over-constrained closed loop, and check_drive
        jammed with all three saturated and the ring turning backwards.
        They are most of the bearing as well as the drive -- the raceway
        cannot locate the ring in the mouth's own direction, so what does
        is the pinions (race_mouth, capture_wander, RUN_OUT).
      * THE GAP IS A WHOLE NUMBER OF TEETH.  Otherwise the far side of the
        gap arrives out of phase and the re-entering pinion butts a tooth
        instead of finding a space.
      * THE MOUTH IS AS NARROW AS THE WORK ALLOWS.  Written wide enough to
        contain the gap, it left a dead arc that let the ring wedge; see
        race_mouth for what that cost and why the premise was false.
      * THE RING IS ITS OWN SPOOL.  The whole metre truss takes 7.8 m of
        0.15 mm thread, which is 139 cubic millimetres, less than a drop.
        It is wound into a GROOVE IN THE RING'S OWN WEB, the way a
        toroidal winder's shuttle carries its wire.  Nothing protrudes,
        the rim is left for the drive, and the head's swept radius falls
        from 32 mm to the rim itself -- which is what let the cage's spine
        grow from 3 mm to 8.
    """
    OD          = 40.0
    ID          = 20.0
    GAP         = 60.0         # deg, open arc: how the rod gets in
    # A THIN PLATE, NOT A DRUM.  The ring sweeps the whole band as the x
    # axis feeds, so its body reaches band/2 + W/2 from the joint, where
    # the diagonals have risen toward the rim: at 10 mm wide no truss in
    # the qualified angle range fits a 20 mm bore (measured, -0.36 mm at
    # the band's end); at 4 mm the metre truss fits with 0.2 mm to spare.
    W           = 4.0          # mm, axial width of the ring body
    # the thread leaves the ring here, on a guide inside the rim
    EXIT_R      = 11.0
    # ---- the thread, wound into the ring's own web
    GROOVE_R    = 15.0         # mm, mean radius of the channel
    GROOVE_D    = 2.0          # mm, radial depth
    GROOVE_W    = 2.0          # mm, axial width
    PACKING     = 0.6          # of the channel, wound thread
    # ---- the drive: teeth on the rim, three phased pinions.
    # NOTHING BELOW IS A TOOTH COUNT.  The first version of this drive wrote
    # one: 72 teeth on the rim and a 12-tooth pinion of 6 mm pitch radius.
    # Those are module 0.556 and module 1.0, and two gears of different
    # module do not mesh -- the drive could not have turned.  Nothing caught
    # it, because a tooth count is exactly the kind of number that is only
    # ever wrong silently.  So the counts are SOLVED (Ring.mesh) from the
    # facts below, and check_geometry re-solves them.
    MODULES     = (0.2, 0.25, 0.3, 0.4, 0.5, 0.6, 0.8, 1.0, 1.25, 1.5, 2.0)
    PRESSURE_ANGLE = 20.0      # deg, standard involute
    BEARING_OD  = 6.0          # mm, an MR63 -- the smallest the pinion can
    BEARING_W   = 2.5          # mm, its width; two of them straddle the ring
    PINION_WALL = 0.8          # mm of metal between the bearing and the root
    PINION_SIGMA = 60.0        # MPa allowable in the pinion's tooth root
    PINION_SF   = 3.0          # on that, before a module is acceptable
    DRIVE_TORQUE = 0.12        # N.m the pinions can deliver at the ring
                               # [VERIFY: a NEMA 8 direct -- the number
                               # check_drive measures the demand against]
    ENCODER_CPR = 4000         # counts per turn on the pinion shaft
    # THE MOTOR IS A NEMA 8 AND THIS IS NOT A FREE CHOICE.  check_drive was
    # swept over rotor inertia at a fixed 4:1 and the cliff is at a factor
    # of TWO: 2.0e-7 passes 16/16, and 4.0e-7, 7.0e-7, 1.4e-6 (NEMA 14) and
    # 5.4e-6 (NEMA 17) all fail the same check -- the one that shifts all
    # three pinions half a pitch and asserts the free ring turns half a
    # tooth and meshes.  A heavy armature on the pinion joints leaves the
    # mesh nothing to jiggle into and the drive wedges at full torque.
    # Rotor inertia varies WITHIN the frame, so a long-body NEMA 8 (8HS30,
    # ~4.0e-7) is already over.  Buy a short one: 8HS15-0604S.
    MOTOR_INERTIA = 2.0e-7     # kg.m^2, a NEMA 8 rotor.  BOM J6.1/J6.2
    # AND THE REDUCTION IS 1:1, NOT THE BRIEF'S 4:1.  Swept with the NEMA 8
    # rotor, 1:1, 2:1, 3:1 and 4:1 ALL pass 16/16, so the gearbox was never
    # load-bearing -- it is an assumption inherited from the brief, and the
    # plate cad.py draws has one motor pulley in the four-pulley loop and no
    # room for a gearbox anyway.  What the reduction would buy is small,
    # because the rpm penalty nearly cancels the ratio:
    #     1:1  motor 160 rpm, holds ~100%  ->  0.107 N.m at the ring, 2.2x
    #     4:1  motor 640 rpm, holds ~35%   ->  0.149 N.m at the ring, 3.1x
    # and it costs resolution nothing that matters: 0.675 deg per full step
    # at the ring against STOP_TOL 3.0, and the encoder's 0.0338 deg does
    # not depend on the reduction at all.  Any value 1..4 is validated, so
    # this is reversible if a rig ever wants the torque.
    REDUCTION   = 1.0          # motor to pinion shaft -- direct
    STEP_DEG    = 1.8          # a 200-step hybrid stepper, at the motor
    # ---- the raceway the pinions and their idlers are carried in
    RACE_T      = 3.0          # mm of rail either side of the rim
    RACE_CLEAR  = 0.05         # mm, an H7/g6 running fit at 40 mm (0.009
                               # to 0.050)
    # HOW FAR THE RING'S CENTRE ACTUALLY MOVES, measured by check_drive with
    # the pinions in place and re-measured by it every run.  The clearance
    # is not the answer on its own: the mouth and the gap leave an arc where
    # no rail can touch the ring, so it travels until rail half a dead arc
    # away catches it (capture_wander bounds that at 0.30).
    #
    # THIS NUMBER IS WHY THE MOUTH IS SOLVED AND NOT CHOSEN.  With the
    # mouth at 100 degrees the dead arc was 160, the catch was 80 degrees
    # oblique, and a 2 N thread became 7 N on the rail: the drive JAMMED
    # every time the gap crossed a pinion, at any clearance under 0.12, and
    # only ran at all at 0.15 or looser -- where the ring travelled far
    # enough to fetch up against a pinion instead.  A design that needs a
    # LOOSE fit to turn is a design being held by the wrong part.  With the
    # mouth solved (60.5) the dead arc is 120, and it turns at every
    # clearance from 0.05 to 0.20, at RPM_MAX, at twice the tension.
    RUN_OUT     = 0.08         # mm, measured 0.076
    RACE_MU     = 0.15         # rail friction, dry [VERIFY: a real one runs
                               # on a film and is nearer 0.05]
    RPM         = 60.0         # winding speed
    RPM_MAX     = 150.0
    SPINUP_S    = 0.5          # 0 -> RPM
    STOP_TOL    = 3.0          # deg, how well the gap can be parked
    MASS        = 22.0         # g, ring + thread
    # The structure above the ring -- the raceway, the pinions, their motor,
    # the carriage plate -- as a box in the ring's frame, z up from the ring
    # centre: (x half, y half, z0, z1).
    HEAD_BOX    = (22.0, 30.0, 24.0, 90.0)

    @classmethod
    def groove_capacity(cls, thread_d):
        """Metres of thread the ring's own channel holds."""
        arc = 2.0 * pi * cls.GROOVE_R * (360.0 - cls.GAP) / 360.0
        vol = arc * cls.GROOVE_D * cls.GROOVE_W * cls.PACKING
        return vol / (pi * (thread_d / 2.0) ** 2) / 1000.0

    @classmethod
    def _sig(cls):
        """Everything mesh/race_mouth/pinion_az read, as a cache key.

        THESE ARE SOLVERS AND THEY ARE CALLED FROM INNER LOOPS.  pinion_az
        scans 18000 candidate spacings and mesh calls it once per module;
        approach.head_distance calls mesh on every sampled obstacle point,
        which is thousands of times per station.  Uncached, check_approach
        went from 4 minutes to over 50.  Keyed on the inputs rather than
        cached outright so that a rig which changes RACE_CLEAR (or a rim
        that is not this one) re-solves instead of getting a stale answer.
        """
        return (cls.OD, cls.ID, cls.GAP, cls.W, cls.MODULES, cls.PRESSURE_ANGLE,
                cls.BEARING_OD, cls.PINION_WALL, cls.PINION_SIGMA, cls.PINION_SF,
                cls.DRIVE_TORQUE, cls.RACE_CLEAR, cls.RACE_T)

    @classmethod
    def mesh(cls):
        """Solve the rim/pinion mesh.  Returns a Mesh, or raises.

        The ring's TIP circle is its rim -- the rim is the head's swept
        radius and nothing may stand proud of it -- so the pitch radius is
        OD/2 minus one addendum, and the module then fixes the tooth count.
        A module is admissible when

          * the rim takes a whole number of teeth, AND the gap spans a whole
            number of them, so the far side of the gap arrives in phase and
            a re-entering pinion finds a space rather than a tooth;
          * the smallest pinion that avoids undercut (2/sin^2(alpha) teeth)
            also clears its own bearing;
          * THE DRIVE DOES NOT COST ENVELOPE.  A pinion hangs below the
            ring's centre by its azimuth, and the head has to get down over
            a chord: the rule is that the RIM decides how far the head
            reaches down, not the drive.  This is what rules out the coarse
            modules -- 1.25 puts a pinion 21.4 mm down against the rim's 20.

        Of the admissible ones the drive takes the COARSEST, because that
        is the strongest tooth and nothing else discriminates: the pinion's
        tip radius varies by 0.4 mm over the whole admissible set and the
        rim sets the envelope regardless, so spending margin on a finer
        tooth buys nothing.  (Measured over the standard modules: 0.2
        admissible at 18.3 MPa, 0.5 at 9.9, 0.8 at 6.2; 1.25 and 2.0 are
        stronger still and refused on envelope.)
        """
        key = ("mesh",) + cls._sig()
        if key in _RING_MEMO:
            return _RING_MEMO[key]
        best = None
        n_undercut = int(ceil(2.0 / sin(radians(cls.PRESSURE_ANGLE)) ** 2))
        for m in cls.MODULES:
            r_pitch = cls.OD / 2.0 - m           # tip circle IS the rim
            n_ring = 2.0 * r_pitch / m
            if abs(n_ring - round(n_ring)) > 1e-9:
                continue
            n_ring = int(round(n_ring))
            gap_teeth = n_ring * cls.GAP / 360.0
            if abs(gap_teeth - round(gap_teeth)) > 1e-9:
                continue
            # the pinion: big enough not to undercut, and big enough that
            # its tooth root stands outside its own bearing
            n_p = n_undercut
            while n_p * m / 2.0 - 1.25 * m < cls.BEARING_OD / 2.0 + cls.PINION_WALL:
                n_p += 1
            r_p = n_p * m / 2.0
            # Lewis at the root: tangential load from the drive torque over
            # the ring's pitch radius, on the rim's own face width.  Y is
            # the 20-degree full-depth fit 0.484 - 2.87/N.
            F = cls.DRIVE_TORQUE / (r_pitch * 1e-3)
            Y = 0.484 - 2.87 / n_p
            sigma = F / (cls.W * 1e-3 * m * 1e-3 * Y) / 1e6
            if sigma * cls.PINION_SF > cls.PINION_SIGMA:
                continue
            M = Mesh(m=m, n_ring=n_ring, n_pinion=n_p, r_pitch=r_pitch,
                     r_pinion=r_p, centre=r_pitch + r_p, tip_r=r_pitch + r_p + m,
                     sigma=sigma)
            if cls.pinion_depth(M) > cls.OD / 2.0 + 1e-9:
                continue                          # the drive would cost envelope
            if best is None or m > best.m:
                best = M
        if best is None:
            raise ValueError("no standard module meshes a %.1f mm rim with a "
                             "%.0f degree gap" % (cls.OD, cls.GAP))
        _RING_MEMO[key] = best
        return best

    @classmethod
    def pinion_depth(cls, mesh=None):
        """How far the deepest pinion and its bearing block hang below the
        ring's centre, with the mouth aimed straight down."""
        M = cls.mesh() if mesh is None else mesh
        r_block = max(M.r_pinion + M.m, cls.BEARING_OD / 2.0)
        return max(M.centre * cos(radians(az)) + r_block
                   for az in cls.pinion_az(M))

    @classmethod
    def teeth_in_gap(cls):
        return cls.mesh().n_ring * cls.GAP / 360.0

    @classmethod
    def contact_half(cls, mesh=None):
        """Degrees of RING arc one pinion can have its teeth in: the arc its
        tip circle subtends at the ring's centre."""
        M = cls.mesh() if mesh is None else mesh
        return degrees(asin(min(1.0, (M.r_pinion + M.m) / M.centre)))

    @classmethod
    def pinion_az(cls, mesh=None):
        """Where the three pinions go, in degrees from the mouth's centre.

        Two constraints, both in degrees, so they trade against each other
        directly:

          * every pinion's contact arc stays off the mouth -- there is no
            raceway there to carry it, and the work comes in through it;
          * adjacent pinions are further apart than a gap plus two contact
            arcs, or one gap can unmesh two of them at once and the ring is
            left held by a single roller.

        The problem is symmetric about the mouth, so the family is one
        pinion opposite the mouth and two at +-s, and the solver takes the s
        that maximises the SMALLER of the two margins.  (The hand-picked
        110/205/300 had 48 degrees of mouth margin and 11 of spacing: it
        spent margin where it was already rich.)
        """
        ch = cls.contact_half(mesh)
        key = ("az", cls.race_mouth(), cls.GAP, ch)
        if key in _RING_MEMO:
            return _RING_MEMO[key]
        floor_ = cls.race_mouth() / 2.0 + ch
        need = cls.GAP + 2.0 * ch
        best, best_s = -1e9, 120.0
        for i in range(1, 18000):
            s = i * 0.01
            mouth = (180.0 - s) - floor_
            spacing = min(s, 360.0 - 2.0 * s) - need
            v = min(mouth, spacing)
            if v > best:
                best, best_s = v, s
        out = (180.0 - best_s, 180.0, 180.0 + best_s)
        _RING_MEMO[key] = out
        return out

    @classmethod
    def pinion_margin(cls, mesh=None):
        """The margin, in degrees, that pinion_az achieved."""
        az = cls.pinion_az(mesh)
        ch = cls.contact_half(mesh)
        floor_ = cls.race_mouth() / 2.0 + ch
        need = cls.GAP + 2.0 * ch
        mouth = min(abs(((a + 180.0) % 360.0) - 180.0) for a in az) - floor_
        sp = sorted(az)
        spacing = min(sp[1] - sp[0], sp[2] - sp[1], 360.0 - (sp[2] - sp[0])) - need
        return min(mouth, spacing)

    @classmethod
    def race_mouth(cls):
        """The opening in the raceway, degrees.  Solved, not chosen.

        WHAT THE MOUTH IS ACTUALLY FOR.  It was written 100 degrees so the
        ring's 60-degree gap would fit inside it, on the reasoning that the
        work comes in through both.  That is not the requirement.  Only the
        CHORD ever reaches the raceway's radius, and only at one azimuth:
        the diagonals at the ring's own x-window are inside 5 mm of the
        chord's axis (r_in_needed) and never see the rail at 23.  A 3 mm
        chord subtends 8.6 degrees at the rail.  So the mouth does not have
        to contain the gap, and the 100 degrees was 40 degrees of dead arc
        bought for nothing -- dead arc being what lets the ring wander and
        wedge (capture_wander, wedge_torque).

        What does pull the other way is depth: the rail's lowest point sits
        at rail_r_out * cos(mouth/2), and a narrow mouth hangs it below the
        rim, which is what the head has to get down past.  So the mouth is
        the NARROWEST that still costs no envelope -- the rim decides how
        far the head reaches down, the drive does not -- and that is
        2 acos(rim / rail).
        """
        return 2.0 * degrees(acos(min(1.0, (cls.OD / 2.0)
                                      / (cls.OD / 2.0 + cls.RACE_CLEAR + cls.RACE_T))))

    @classmethod
    def chord_at_rail(cls, d_chord, clear):
        """Degrees of mouth a chord of this diameter needs at the rail."""
        return 2.0 * degrees(asin(min(1.0, (d_chord / 2.0 + clear) / (cls.OD / 2.0))))

    @classmethod
    def wedge_torque(cls, force):
        """Rail friction when a side load pushes the ring into the dead arc,
        as a torque about the ring's axis, N.m.

        The catch is oblique: the ring is held by rail half a dead arc away,
        so a load F is carried by normals F / (2 cos phi) each and the
        friction they make is mu F r / cos phi.  This is the term that took
        the drive's whole rating at a 0.05 mm clearance and a 160-degree
        dead arc, and it is why the mouth is no wider than it has to be.
        """
        phi = radians(min(89.0, cls.capture_arc() / 2.0))
        return cls.RACE_MU * force * (cls.OD / 2.0 / 1000.0) / cos(phi)

    @classmethod
    def inertia(cls):
        """The ring's polar moment about its own axis, kg.m^2 -- a thin
        annulus of MASS between the bore and the rim."""
        r1, r2 = cls.ID / 2000.0, cls.OD / 2000.0
        return cls.MASS / 1000.0 * (r1 * r1 + r2 * r2) / 2.0

    @classmethod
    def drive_armature(cls):
        """The motor's rotor, reflected through the reduction and the mesh
        to the ring's own axis, kg.m^2.

        REAL HARDWARE, AND THE CELL NEEDS IT.  It is six times the ring's
        own inertia, so leaving it out does not just lose a little fidelity
        -- it makes the ring's velocity loop unintegrable.  The cell's
        hinge carried armature 1e-7, a placeholder, and that was survivable
        only while the spool's mass sat out on the rim; with the spool gone
        the ring got light, kv*dt/I went to 2.6, and the servo chattered
        between 15 and 0 rad/s every step.  check_hal saw it as a park that
        never landed.
        """
        return cls.REDUCTION ** 2 * cls.MOTOR_INERTIA / cls.mesh().ratio ** 2

    @classmethod
    def servo_kp(cls):
        """The ring's position loop, N.m per radian AT THE RING.

        A STEPPER IS A POSITION SOURCE, not a velocity one, and that is
        what makes it stiff: its torque runs up to the rating over about
        one full step of lag, so the stiffness is the rating over a step
        and there is nothing to choose.  Referred from the pinion shaft to
        the ring, torque divides by the mesh ratio and angle multiplies by
        it, so the stiffness divides by its square.

        The cell drove the ring as a VELOCITY instead, and any gain soft
        enough for the timestep to integrate was too soft to reject the
        hinge's own damping: the ring ran 340 deg/s of a commanded 360 and
        check_hal read it as a 5.6 per cent speed error.  A position loop
        has no steady error to reject.
        """
        return cls.shaft_kp() / cls.mesh().ratio ** 2

    @classmethod
    def shaft_kp(cls):
        """The same stiffness at the PINION SHAFT, where the motor is:
        N.m per radian.  The shaft carries DRIVE_TORQUE * ratio (power is
        conserved, the ring turns `ratio` of a shaft turn) and develops it
        over one full step of the motor through the reduction."""
        return (cls.DRIVE_TORQUE * cls.mesh().ratio
                / radians(cls.STEP_DEG / cls.REDUCTION))

    @classmethod
    def servo_kv(cls):
        """...critically damped on what that loop actually carries: the
        ring plus the drive's rotor reflected to the ring's axis."""
        return 2.0 * (cls.servo_kp() * (cls.inertia() + cls.drive_armature())) ** 0.5

    @classmethod
    def servo_acc(cls):
        """deg/s^2 the ring's command ramps at: 0 to RPM in SPINUP_S.  An
        acceleration, not a time to whatever speed is asked for."""
        return cls.RPM * 6.0 / cls.SPINUP_S

    @classmethod
    def capture_arc(cls):
        """The widest arc over which the raceway CANNOT touch the ring.

        A contact needs ring at that azimuth and rail at that azimuth.  The
        ring is missing over its gap, which turns; the rail is missing over
        the mouth, which does not.  Worst case they lie side by side, and
        the dead arc is their sum.
        """
        return cls.GAP + cls.race_mouth()

    @classmethod
    def capture_wander(cls):
        """How far the ring's CENTRE can move in the raceway, mm.

        A circle in a channel one clearance larger stops when its rim
        reaches the wall in the direction it moved -- at the clearance, if
        there is wall there.  Pushed into the dead arc there is not, and it
        runs on until the nearest live azimuth catches it, which takes
        clearance / cos(half the dead arc).  Beyond a dead arc of 180
        degrees nothing catches it and the ring leaves the machine, so this
        is the capture criterion as well as the number.

        Measured against the rig at 0.35 mm (check_drive): the pinions,
        which this ignores, are most of what holds the ring.
        """
        half = radians(cls.capture_arc() / 2.0)
        if cls.capture_arc() >= 180.0:
            return float("inf")
        return cls.RACE_CLEAR / cos(half)

    @classmethod
    def pinions_meshed(cls, gap_az=0.0):
        """How many pinions have teeth under them with the gap here."""
        ch = cls.contact_half()
        return sum(1 for az in cls.pinion_az()
                   if abs(((az - gap_az) + 180.0) % 360.0 - 180.0) > cls.GAP / 2.0 + ch)


class Gantry:
    """XYZ on SFU1204 ballscrews, MGN12 rails, NEMA17 direct (brief 4.3)."""
    # AS BUILT HERE, NOT AS THE BRIEF HAS THEM.  The brief's 1200 x +-50 was
    # laid out for a head that only winds; a head that also LOADS needs to
    # reach a chord rack beside the cage (y) and a diagonal rack beyond
    # each end plate (x).  fixture.x_range/y_reach compute the need and
    # check_geometry holds these against it: the metre truss needs 1330
    # of x and 134 of y.  1400 is the brief's own "400 mm beyond the
    # longest truss".
    X_TRAVEL    = 1400.0
    Y_TRAVEL    = 300.0
    # Z'S TRAVEL IS THE RAIL'S, NOT A CHOSEN NUMBER.  Typed, 150 was 5 mm
    # more than the hardware can do: the rail ordered for Z is 250 mm and
    # two MGN12H carriages 60 mm apart occupy 60 + 44.8, leaving 145.2.
    # WHAT SIZES Z IS THE CAGE'S INDEX LIFT, NOT THE RING'S.  The ring
    # lifts 13 mm between joints; the cage has to index under the head,
    # which is 79.1 mm plus the ring's own radius to clear it -- 99.1.  So
    # BOM I2's aside that "Z_TRAVEL could come down to 60 if anything ever
    # needed the room" was wrong by 39 mm, and check_approach says so.
    Z_RAIL      = 250.0        # MGN12 rail, as ordered (BOM I2/I7)
    BLOCK_L     = 44.8         # MGN12H carriage, along the rail
    BLOCK_PITCH = 60.0         # the two carriages, centre to centre (I1a)
    Z_TRAVEL    = Z_RAIL - (BLOCK_PITCH + BLOCK_L)
    PITCH       = 4.0          # mm per screw revolution, X and Y: SFU1204
    # Z IS A LEAD SCREW, NOT A BALL SCREW -- see BOM PART E, decision E2.
    # IT IS A 4-START Tr8x8, BECAUSE THAT IS THE SCREW ALREADY OWNED, and
    # an earlier revision of this comment had it as a self-locking Tr8x2.
    # That was reading a listing wrong: "2 mm pitch" on four starts is an
    # 8 mm LEAD, and the lead is what sets the angle.  Measured below --
    # 19.99 degrees against a POM nut's 11.31 -- Z BACKDRIVES.  So the
    # backdriving requirement E1 carried is back, and Z_COUNTER_N pays it:
    # a spring or counterweight, not holding current, because the reason
    # to care is an E-stop, and a spring still holds when the power is cut.
    # AN ANTI-BACKLASH NUT DOES NOT SUBSTITUTE.  It fixes backlash; the
    # lead angle belongs to the screw and no nut changes it.
    # The 8 mm lead costs resolution -- 0.040 mm per full step against
    # REPEAT's 0.05, so 80% of the budget where the 2 mm lead used 20% --
    # and buys back the rpm that comment was worried about: 40 mm/s is
    # 300 rpm here where a 2 mm lead wanted 1200, so Z's V_MAX goes back
    # up and check_schedule prices the build again.
    PITCH_Z     = 8.0          # the LEAD: 2 mm pitch x 4 starts
    SCREW_D2_Z  = 7.0          # Tr8 pitch diameter, mm
    MU_NUT_Z    = 0.20         # POM on steel, dry -- the nut, not the screw
    # What holds Z up, since the screw will not.  Z's moving mass is
    # ~1.55 kg, so ~15 N.  Zero here would mean "the screw self-locks".
    Z_COUNTER_N = 15.0
    STEPS_PER_REV = 200        # full steps; no microstepping (brief 4.3)
    MM_PER_STEP = PITCH / STEPS_PER_REV     # X and Y; use mm_per_step(axis)
    V_MAX       = {"x": 60.0, "y": 40.0, "z": 40.0}     # mm/s, loaded
    A_MAX       = {"x": 400.0, "y": 300.0, "z": 300.0}  # mm/s^2
    REPEAT      = 0.05         # mm, bidirectional
    SCREW_CTE   = 12e-6        # /K, steel
    DT_K        = 10.0         # K, warm-up over a shift
    SETTLE_S    = 0.15         # after a move, before a process step

    @classmethod
    def pitch(cls, axis):
        """mm of travel per screw revolution, per axis."""
        return cls.PITCH_Z if axis == "z" else cls.PITCH

    @classmethod
    def mm_per_step(cls, axis="x"):
        """One full step, mm.  PER AXIS, because Z's screw is not X's."""
        return cls.pitch(axis) / cls.STEPS_PER_REV

    @classmethod
    def lead_angle_z(cls):
        """Z's screw lead angle, degrees.  atan(lead / (pi * d2))."""
        return degrees(atan2(cls.PITCH_Z, pi * cls.SCREW_D2_Z))

    @classmethod
    def self_locking_z(cls):
        """Does Z hold itself up?  Lead angle under the nut's friction
        angle, and NOTHING ELSE decides it -- not the nut's backlash, not
        its material's cleverness, not the motor.  atan(mu) is the whole
        criterion, so a screw is picked or a counterbalance is bought."""
        return cls.lead_angle_z() < degrees(atan2(cls.MU_NUT_Z, 1.0))

    STALL_N     = {"x": 120.0, "y": 120.0, "z": 120.0}  # thrust at stall


class Head:
    """What rides on the Z carriage, and where.  Tool positions are along
    the carriage's x (the truss axis) from the ring's plane; the dispenser
    and gripper each have their own short stroke so they can reach BELOW a
    ring that is lifted clear -- a single Z cannot serve a ring that must
    be seated on the chord and a nozzle that must be 20 mm under it.

    THE OFFSETS ARE DERIVED: a tool must sit outside the ring's swept
    torus in x, with room for its own width.  Typed here they would move
    the day the spool grew.
    """
    DISP_STROKE = 40.0
    GRIP_STROKE = 40.0
    GRIP_YAW    = 95.0         # deg, either way: a rack rod lies at 90
                               # (measured: a 75-degree range clipped the
                               # pick yaw and the pads landed on the rod)
    TOOL_CLEAR  = 4.0          # mm between a tool and the ring's envelope
    # parked tool tips sit this far ABOVE the ring centre: clear of a chord
    # the ring is seated on, and of the diagonals beside it
    TIP_PARK    = 6.0

    @staticmethod
    def ring_axial_half():
        """Half the axial width of everything on the head at the ring's
        radius: the rim and the rails that carry it."""
        return Ring.W / 2.0 + Ring.RACE_T

    @staticmethod
    def disp_x():
        # the camera bay sits between the ring's envelope and the dispenser
        return (Head.ring_axial_half() + Head.TOOL_CLEAR + Vision.cam_bay()
                + Dispenser.BODY_W / 2.0)

    @classmethod
    def yaw_swing_clear(cls, length, yaw_deg, r=0.0):
        """How far a rod held at its middle clears the head's OWN RING while
        the gripper turns to `yaw_deg`, mm.  Positive is clear.

        THE YAW HAPPENS WITH THE GRIPPER RETRACTED, at cruise height, and
        retracted the grip point sits TIP_PARK ABOVE the ring's centre --
        inside its bore.  A rod swung about that point sweeps its own
        half-length round it, and at some yaws its ends come out of the
        bore and into the annulus.  Measured on the mount rig: a 39.7 mm
        strut turned to -33.7 degrees sat 0.67 mm inside `ring7`, and went
        down 71.6 degrees off its own line with every op reporting success.
        This function reads -0.67 for that case.

        THE YAW SERVO'S STOP IS NOT THIS CONSTRAINT.  -33.7 is well inside
        the +-95 degrees the servo has; what it is outside is the head.
        """
        from math import cos as _cos, sin as _sin, radians as _rad, hypot as _hyp
        psi = _rad(float(yaw_deg))
        ux, uy = _cos(psi), _sin(psi)
        worst, n = 1e9, 64
        for i in range(n + 1):
            s = -length / 2.0 + length * i / n
            x = cls.grip_x() + s * ux
            rad = _hyp(s * uy, cls.TIP_PARK)
            worst = min(worst, max(abs(x) - cls.ring_axial_half(),
                                   rad - (race_r_out() + r),
                                   (ring_r_in() - r) - rad))
        return worst

    @classmethod
    def yaw_stroke(cls, r=0.0, clear=None):
        """How far the gripper must be extended before a carried rod may be
        TURNED, mm.

        Retracted, the grip point is TIP_PARK above the ring's centre and a
        rod swung there sweeps out of the bore and into the annulus.
        Extended past the ring's own outer radius it sweeps in clear air,
        whatever the yaw -- so the rule is not "which yaws are legal" but
        "turn it below the head".
        """
        clear = Process.SEAT_CLEAR if clear is None else clear
        return cls.TIP_PARK + race_r_out() + r + clear

    @staticmethod
    def grip_x():
        return -(Head.ring_axial_half() + Head.TOOL_CLEAR + Gripper.BODY_W / 2.0)


class Gripper:
    """Parallel-jaw, flat pads, on a yaw servo (brief 7.4 made concrete).

    Flat pads rather than V-jaws: the rod is LOCATED by the fixture's
    notches and cradles, never by the gripper, so the gripper only has to
    carry it there.  The yaw servo is what lets one magazine hold every
    diagonal parallel to x and still place them at +-alpha.
    """
    BODY_W      = 12.0         # along the carriage x
    PAD_L       = 10.0         # along the rod
    PAD_T       = 2.0
    PAD_H       = 6.0          # tall, gripping the rod's upper half
    # A rod is gripped at its MIDPOINT, where the racks and the fixture
    # leave it free; anywhere a V sits under the rod, a pad reaching below
    # the axis lands on the flank first (measured: jaws that could not
    # close on a racked diagonal).  fixture.pin_xs keeps the pins off it.
    PAD_UNDER   = 1.0          # how far the pads reach below the grip point:
                               # round the axis of the thinnest rod, since
                               # nothing is under a rod where it is gripped
    FINGER_L    = 22.0
    JAW_OPEN    = 8.0          # gap between pads; rods are 3 mm at most
    JAW_CLOSE_S = 0.3
    YAW_V       = 200.0        # deg/s
    YAW_TOL     = 0.5          # deg, a hobby servo's repeatability


class Cage:
    """The rotating fixture (brief 4.4): a spine on the truss axis, radial
    arms carrying V-notched pins under each chord, cradles at each joint,
    thread posts on the end plates, driven through a worm.

    GEOMETRY IS HELD BY THE FIXTURE, NOT THE ROBOT (brief 4.1).  Every
    location feature is a V, because a V is a kinematic locator that turns
    a millimetre of arrival error into a tenth of nothing -- and check_load
    measures exactly how much.
    """
    THETA_RPM   = 10.0         # worm output
    THETA_TOL   = 0.05         # deg, worm index repeatability
    PIN_PITCH   = 50.0         # brief 4.4: chord straightness governs
    PLATE_SPOKES = 12          # how many radial capsules stand for an end
                               # plate in the approach solver's obstacle set
    PIN_T       = 3.0          # along x
    ARM_W       = 6.0
    NOTCH_ANGLE = 90.0         # included angle of the V
    NOTCH_DEPTH = 2.5          # from the pin's tip to the V's floor
    END_PLATE_T = 6.0
    # the plate stands clear of a ring parked at the post: post offset plus
    # the ring's axial half-extent plus clearance, asserted in CHECKS
    # PLATE FACE BEYOND THE CHORD ENDS, AND THE CAMERA IS WHAT SETS IT.
    # This was 20 mm, which is what the winding head parked at a thread
    # post needs (post_off_min + ring_axial_half + SEAT_CLEAR = 14.5).
    # But the camera mount goes on INSIDE the cage -- its rods are laid by
    # the same gripper and bonded by the same dispenser, and the cage is what
    # presents their angles -- so the module has to fit in there too, and
    # at 20 mm it lands in the end plate: the solved standoff puts a Camera
    # Module 3's outer face 33.9 mm past the chord ends of the chosen truss
    # and 38.0 mm past the largest section the cell is specified to build.
    #
    # The cage is ONE machine built once, so this is a machine fact rather
    # than something solved per truss -- but it is a DERIVED one, and
    # check_mount re-derives it against the payload, the field of view and
    # SECTION_MAX, so it cannot drift away from the camera it was sized
    # for.  It is not free: it pushes the end racks out with it, and the
    # chosen truss then wants 1391 mm of the gantry's 1400.
    #
    # It was 40 while the camera was aimed 30 degrees off a chord and needed
    # 21 mm of standoff to stop photographing it.  Aimed at a face the field
    # costs no standoff at all, and eight millimetres of this came back.
    #
    # AND THEN IT WENT BACK OUT AGAIN, because what the cage has to leave
    # room for is not the module.  It is the head kit station B delivers,
    # and the grid overhangs the board by OVERRUN on every side.  At 32 the
    # kit's outboard edge was a millimetre PAST the end plate's inner face
    # and its inboard edge was 5 mm INSIDE the mandrel -- in the backbone,
    # the torsion shafts and the first arms.  Eight cage parts inside the
    # kit, the worst 4.5 mm deep, measured on the built scene; the camera
    # would not seat because there was something already there.
    #
    # IT WANTED 41.5 AND THE GANTRY ONLY ALLOWS 40.5, and that is what
    # found the last typed number in the kit: `Bracket.OVERRUN` was 4.0
    # where the band it has to carry is 2.05.  Derived, the kit is 1.95 mm
    # narrower each side, the standoff comes back to 18.55 and this to
    # 37.10 -- so the brief's own 1400 mm of X still covers the largest
    # truss the cell is specified to build.  Rounded up from that to 39,
    # which is what the BUILT scene wants: check_mount measures the kit at
    # the pose the plan sends it to against every geom in the cell, and the
    # grid's outboard tips want their process clearance from the end
    # plate's face like anything else.  x_reach is then 1397 of 1400.
    END_FREE    = 39.0
    POST_R      = 1.5          # thread anchor post
    POST_L      = 12.0         # the pin's length, straddling the chord's line
    # WHERE THE POST STANDS IS NOT HERE.  It is a station, and the truss's
    # own camera mount is what decides it: `mount.post_station` scans the
    # window these two bound and `Fixture.post_off` is what the cell reads.
    # This was POST_OFF = 8.0, and 8.0 is exactly what `post_off_min`
    # returns -- the number was right about the ring and had never been
    # asked about the mount, which wants 11.15 on the chosen truss and
    # 13.70 at the thickest diagonal in the rack.  Two struts an end were
    # 0.66 mm inside a pin.
    CRADLE_L    = 6.0          # along the diagonal
    CRADLE_T    = 1.5          # wall
    CRADLE_ANGLE = 90.0
    # THE SPINE IS SIZED BY THE HEAD'S REACH BELOW THE CHORD.  The ring
    # sweeps its own rim round the chord and the raceway's rail reaches
    # deeper still at the mouth's edge; the chord is R from the cage's
    # axis, so whatever tube runs down that axis has to fit in what is
    # left (measured with the old spool on the rim: an 8 mm
    # spine met the spool at the first joint of the 300 mm truss).  So the
    # spine is as thick as the truss allows up to SPINE_R_MAX, and a truss
    # that leaves less than SPINE_R_MIN cannot be wound by this ring.
    SPINE_R_MAX = 8.0
    SPINE_R_MIN = 3.0

    @staticmethod
    def post_off_min():
        """Nearest a thread post can stand to the chord end, mm.

        The head hooks the strand by running a rectangle round the post
        (approach.post_loop), and that rectangle's half-width in x is what
        it takes for the ring's PLATE to pass fully beyond the pin --
        ring_axial_half + POST_R + clearance.  Any nearer and the far leg
        of the loop is inside the chord end."""
        return Head.ring_axial_half() + Cage.POST_R + Process.SEAT_CLEAR

    @staticmethod
    def post_off_max():
        """Furthest, mm: the ring PARKED at the post still clears the end
        plate.  The same expression CHECKS used to hold POST_OFF to."""
        return Cage.END_FREE - Head.ring_axial_half() - Process.SEAT_CLEAR

    @staticmethod
    def spine_r(R):
        return min(Cage.SPINE_R_MAX, R - ring_swept_r() - 2.0 * Process.SEAT_CLEAR)

    @staticmethod
    def nose_spine_r(payload=None):
        """Radius the backbone may be over the NOSE, mm -- and the answer is
        that there is no backbone over the nose at all.

        THE CAMERA CONTAINS THE AXIS.  It is mounted on the spine's own
        axis -- that is the whole point of the mount, since a mass off the
        axis turns a manoeuvre into camera yaw -- and its board is 9 mm
        deep centred on that axis.  So there is no radius a tube can neck
        down to and clear it: not 8 mm, not 3, not 1.

        THIS FUNCTION USED TO RETURN 3.0, from `BOX[1]/2 - SEAT_CLEAR`, on
        the belief that the module's nearest face was 4.5 mm OFF the axis.
        It is not off it; the axis runs through the middle of the board.
        Measured on the built scene, the tube was 4.5 mm inside the board,
        the draw rod with it, and six more cage parts besides -- and the
        camera would not seat, because there was something already there.

        What is left is a stub: the plate's own hub, reaching in from the
        end plate as far as the nose lets it and no further, which
        `fixture.nose_span` says.  Across the nose the end plate is carried
        on the machine's own bearing, and the draw rod's pull is taken off
        the axis, outside the kit's silhouette -- there is a corridor 15 mm
        wide for it between the mount's own struts.  [VERIFY: draw that
        linkage; check_mount holds the rule, not the mechanism.]
        """
        return Cage.SPINE_R_MIN

    # Retention.  A rod in an upward-opening V falls out when the cage
    # turns it downward; the real fixture needs a keeper (spring clip, wax
    # dab).  Modelled as a weld once a rod is seated; check_load reports
    # the force a keeper has to hold, which is the rod's weight and nothing
    # more.
    KEEPER      = "weld"
    ARM_PITCH_MIN = 40.0
    # --------------------------------------------------- THE MANDREL COMES OUT
    # The cage is wound INTO a closed lattice, so it has to collapse before
    # it can leave: three rails on parallelogram arms, one over-centre brace
    # each, one draw rod down the spine's bore to trip all three.  See
    # collapse.py -- these are the mechanism's facts, everything else there
    # is computed from the truss.
    LINK_T      = 3.0          # mm, link plate thickness
    LINK_W      = 8.0          # mm, link plate width
    PIVOT_D     = 3.0          # mm, clevis pin
    PIVOT_FIT   = 0.05         # mm of running clearance in a bore
    PIVOT_SIGMA = 90.0         # N/mm^2 allowable bearing on an ali lug
                               # (a quarter of 6082-T6's yield, the usual
                               # figure for a pin in a plate)
    DRAW_D      = 6.0          # mm, the release rod down the spine's bore
    HAND_F      = 100.0        # N a hand can put on a release lever


class Magazine:
    """Where the loader finds the rods.  Chords lie beside the cage,
    parallel to x; diagonals lie in a rack beyond the +x end, also parallel
    to x, and the gripper's yaw turns them.  Positions are derived from the
    truss in fixture.magazine()."""
    CHORD_PITCH = 12.0
    # wider than the jaw's outer span PLUS the neighbour's flank: a yawed
    # gripper straddles the rod it picks, and its pads' outer faces must
    # clear the next slot's V (measured: at 9 mm a pad landed on it and the
    # jaws closed on nothing)
    DIAG_PITCH  = 11.0
    SLOT_ANGLE  = 90.0
    SLOT_DEPTH  = 2.0
    BLOCK_L     = 12.0         # each of the two V-blocks a rod rests on
    BLOCK_IN    = 15.0         # from the rod's end to the block's centre
    CLEAR       = 40.0         # chord rack from the cage's swept radius
    END_CLEAR   = 10.0         # diagonal racks from the cage's end plates


    @staticmethod
    def blocks(length, pad_l=None, clear=1.0):
        """(offset from the slot's middle, block length) for each V-block
        under a racked rod, mm.

        THE PADS TAKE EVERY ROD AT ITS MIDDLE, so no block may be within
        half a pad of it -- and no block may hang off the rod's end.  For a
        long rod those two rules never meet and the layout is the old one:
        BLOCK_L of block, BLOCK_IN in from each end.  For a SHORT rod they
        do meet, and the blocks have to shrink into what is left between
        the pads and the ends.

        The mount's rods are where this started to matter.  A 42 mm strut
        on the long-rod layout gets its blocks 6 mm from the middle, which
        is under the pads; a 22 mm one gets them past each other.  Racked
        that way they fell on the floor and the jaws closed on nothing --
        measured, in the assembly run.  Below the length at which nothing
        is left between the pads and the ends a rod CANNOT be racked, and
        this returns no blocks rather than a shorter one: that is a finding
        about the part, not a number to shave.
        """
        pad_l = Gripper.PAD_L if pad_l is None else pad_l
        inner = pad_l / 2.0 + clear
        outer = length / 2.0
        # The long layout is only safe while its own block still clears the
        # pads: BLOCK_IN in from the end, BLOCK_L long, and the pads take
        # half a pad plus a clearance either side of the middle.  A 42 mm
        # strut is over the naive threshold and still lands its blocks
        # 0.1 mm from the middle -- measured, as a stalled gripper stroke.
        if length >= 2.0 * (Magazine.BLOCK_IN + Magazine.BLOCK_L / 2.0
                            + pad_l / 2.0 + clear):
            return [(-(outer - Magazine.BLOCK_IN), Magazine.BLOCK_L),
                    (+(outer - Magazine.BLOCK_IN), Magazine.BLOCK_L)]
        bl = min(Magazine.BLOCK_L, outer - inner)
        if bl < 2.0:
            return []
        off = outer - bl / 2.0
        return [(-off, bl), (+off, bl)]

class Dispenser:
    """Syringe on its own short Z, stepper plunger (brief 4.6).  One
    metered drop per joint; the dose is the joint mass budget minus the
    thread, which band.py measures."""
    BODY_W      = 14.0
    NOZZLE_D    = 0.6
    STANDOFF    = 1.0          # nozzle tip above the band when dosing
    DOSE_S      = 1.5
    RESIN_RHO   = 1.15         # g/cm^3, LY556/HY917
    DROP_SPREAD = 0.4          # mm, where a drop lands vs the nozzle [measured by check_effectors]


class Cutter:
    """Hot-wire thread cutter on the head, beside the ring's exit guide."""
    CUT_S       = 1.0
    WIRE_OFF    = 4.0          # from the exit guide, along the strand


class CameraModule:
    """What every camera module in this project has in common.

    THE FRAME.  x runs along the spine (the stereo baseline), y is the
    VIEWING direction, z is up.  So `BOX` is (along the baseline, thickness
    toward the scene, height) and the lens looks along +y.  The housing
    straddles the spine's axis in y and z, so its centre of mass sits ON the
    axis and its optical axis crosses it -- which is not tidiness: an
    off-axis mass turns a manoeuvre into camera yaw, the one error nothing
    downstream recovers.

    NOTHING HERE IS A NUMBER.  The numbers are in the subclasses, one per
    part, each read off that part's own drawing; this is the arithmetic
    that turns them into the units the design budget is written in, so that
    two modules can be compared rather than argued about.
    """

    @classmethod
    def holes(cls):
        """The four mounting-hole centres, (along the baseline, up) from the
        BOARD's centre, mm."""
        hx, hz = cls.HOLE_PITCH[0] / 2.0, cls.HOLE_PITCH[1] / 2.0
        return tuple((sx * hx, cls.HOLES_UP + sz * hz)
                     for sx in (-1.0, 1.0) for sz in (-1.0, 1.0))

    @classmethod
    def f_px(cls):
        """The calibrated focal length, in pixels."""
        return cls.FOCAL / cls.PIXEL

    @classmethod
    def fov_from_sensor(cls):
        """The field the MEASURED image area and the focal length imply,
        degrees (h, v) -- the cross-check on the published field."""
        return tuple(2.0 * degrees(atan(a / 2.0 / cls.FOCAL))
                     for a in cls.IMAGE_AREA)

    @classmethod
    def fov_diagonal(cls):
        """The diagonal field the published H and V imply, degrees."""
        h, v = (radians(a / 2.0) for a in cls.FOV)
        return 2.0 * degrees(atan(sqrt(tan(h) ** 2 + tan(v) ** 2)))

    @classmethod
    def pixel_angle(cls):
        """radians one pixel subtends -- the thing that actually sets depth
        precision, and the one number a bigger sensor does not buy you."""
        return cls.PIXEL / cls.FOCAL

    @classmethod
    def range_error_match(cls, range_m, baseline_mm=1000.0, sigma_px=0.1):
        """m of range error from matching to sigma_px pixels: the STOCHASTIC
        floor.  dZ = Z^2 dtheta / B with dtheta one pixel's angle."""
        return (range_m ** 2 * sigma_px * cls.pixel_angle()
                / (baseline_mm / 1000.0))

    @classmethod
    def range_error_axial(cls, dv_mm, range_m):
        """m of range error from an AXIAL lens shift of dv_mm.

        The lens moving along its own axis changes the image distance,
        which is what a calibration measures as the focal length.  Stereo
        reads Z = f B / d, and a fractional error in f is the same
        fractional error in Z: it does NOT cancel between the two cameras,
        because both focal lengths enter the same way.  An INTRINSIC, and
        the truss cannot help with it.
        """
        return range_m * dv_mm / cls.FOCAL

    @classmethod
    def range_error_yaw(cls, yaw_deg, range_m, baseline_mm=1000.0):
        """m of range error from a relative YAW between the camera faces --
        the truss's own budget, in the same units, so the two compare.
        dZ = Z^2 dtheta / B, and the focal length cancels."""
        return range_m ** 2 * radians(yaw_deg) / (baseline_mm / 1000.0)

    @classmethod
    def case_r(cls):
        """Circumradius of the lens housing, mm -- the largest lever arm a
        mount bonded to it can have."""
        return 0.5 * sqrt(cls.CASE[0] ** 2 + cls.CASE[1] ** 2)

    @classmethod
    def hole_r(cls):
        """...and the lever arm a mount through the four PCB holes gets,
        which is twice as big and goes through FR4 to get there."""
        return 0.5 * sqrt(cls.HOLE_PITCH[0] ** 2 + cls.HOLE_PITCH[1] ** 2)

    @classmethod
    def pcb_stiffness(cls, span_mm):
        """N/mm of the board itself over a span, for comparing with a strut.
        The board is what a hole-mounted strut has to work through, and it
        is not obviously the stiff part."""
        I = cls.BOX[0] * cls.PCB_T ** 3 / 12.0
        return 48.0 * cls.PCB_E * I / span_mm ** 3

    @classmethod
    def half_diagonal(cls):
        """Half the diagonal of the housing's section across the spine --
        the circle the mount's platform triangle has to clear."""
        return 0.5 * sqrt(cls.BOX[1] ** 2 + cls.BOX[2] ** 2)

    @classmethod
    def com_on_axis(cls):
        """True when the module is mounted so its mass straddles the spine's
        axis and makes no moment under a manoeuvre.

        THE OPTICAL AXIS IS NOT THE MODULE'S CENTRE.  The lens sits LENS_UP
        above the board's centre, so a module centred on the spine's axis
        does not look along it, and a module whose lens is on the axis has
        its mass LENS_UP off it.  The mount takes the second: the mass
        offset is a couple of millimetres and makes a moment, where the same
        offset as an aiming error is tens of thousands of microdegrees of
        pointing and would have to be calibrated out.  Both are true of the
        part, not of the design.
        """
        return abs(cls.LENS_UP) < cls.BOX[2] / 2.0
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
