Chandanpanda/ART-Forum-2017-Stan-Tutorial/(commit log)

2026-08-28 Add PyBullet simulation plan for the Rev C two-robot system
    Reads the Rev C source set (rulebook PDF, revC_1 spec, revC drawing set,
    Mechanism Explainer, Explainer) and derives a staged plan for simulating
    both agents in PyBullet.
    Covers:
    - what each source artefact is authoritative for, and what Rev A/B material
    is superseded
    - field geometry and Senior scoring extracted into one table
    - seven cross-document discrepancies that change simulation predictions,
    including Agent B's over-determined belt incline (11 deg vs the 9.9 deg
    the newest artefact actually uses), the revised diverter, the lane-run
    conflict, and the Senior patient-position question
    - a two-tier sim architecture (fas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
2026-08-28 Switch simulation plan to MuJoCo and resolve all source contradictions
    Replaces the PyBullet plan. The engine change is driven by one verified
    fact: MuJoCo has a native conveyor. Checked against mujoco 3.12.0 from
    PyPI (Apache 2.0):
    - <geom surfacevel="..."> is a 6-vector surface velocity in the geom's
    local frame. A 5 g cylinder on an 11 deg belt at 60 mm/s is carried at
    59.2 mm/s; four cylinders queued at a closed gate hold at 0.131 N
    against the spec's hand-calculated 0.116 N. The PyBullet plan's
    contact-force-injection section collapses to one attribute.
    - rangefinder / gyro / accelerometer / touch / actuatorfrc / contact
    cover the sensing suite; insidesite gives the referee's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
2026-08-28 Record source corroboration of R2-R4 in the plan
    The Mechanism Explainer update in 7fb8ca9 explicitly states that the 66
    vane and the lane walls from Yb 108 supersede spec §6.2-§6.3. Note that
    in R2, R3 and R4, along with the fact that the mid-pivot vs +/-18.6
    tip-throw inconsistency persists in the updated file, so the two-thirds
    pivot resolution is still load-bearing rather than superseded.
    Claude-Session: https://claude.ai/code/session_01LXN3VSajK1dQd8hBmAC9Zx
2026-08-28 Add MuJoCo simulation of Agent A with a working conveyor pipeline
    A runnable MuJoCo model of the Rev C Agent A chassis, generated from a single
    parameter file, with four demo scripts. Everything was built and run before
    being committed; README section 2 states honestly what works and what does not.
    Verified working:
    - 11 geometry assertions derived from params.py
    - straight-line drive at 0.9% slip; turn-in-place at 70% (calibrated)
    - conveyor carry: 59.2 mm/s against a 60 mm/s belt on the 11 deg incline
    - passive accumulation: 0.134 N on a closed gate vs 0.118 N predicted
    - single disc floor -> scoop -> belt -> chute magazine at 100-150 mm/s
    - gate stroke posting a disc through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
    [mjcf.py, params.py, referee.py, robot.py]
2026-08-28 Fix multi-disc capture and lab posting; both halves now work
    Pick: 3 of 3 discs off the floor into the chute-magazine (demo_capture.py).
    Place: 3 of 3 lab holes, +45, docking to 0.1-0.3 mm (demo_post.py).
    Full mission: +27, two of three samples placed (was -13).
    Root causes found and fixed:
    - <pair> defaults to solref="0.02 1", far softer than the class defaults, so a
    5 g disc dropping 36 mm tunnelled straight through the closed gate. Every
    contact pair now restates its stiffness.
    - Discs rode the gate out of the chute instead of dropping: MuJoCo combines geom
    friction as the element-wise MAX, so a smooth gate against a 0.6 piece still
    got 0.6. Explicit low-friction pairs added f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
    [mjcf.py, params.py, robot.py, route.py]
2026-08-28 Rebuild the hole chamfer and fix hole 3 docking
    Hole 3 docked at 15 mm and failed to post; it now docks at 1.8 mm and posts,
    matching holes 1 and 2. All three dock to 1.8-2.0 mm in-mission and to 0.0 mm
    from a standing start (demo_post: 3 of 3, +45).
    Chamfer rebuilt. Segments are oriented with xyaxes (tangential x, up-slope y)
    instead of three composed eulers, which is what put the old ones ~30 mm out of
    place and made the chassis rear wall crash into them at 33 N. Measured envelope
    5.4 mm tall, 34.8 mm radius, verified to clear the docked robot's gate (Za 8) and
    rear wall (Za 6). It funnels a disc dropped up to 7 mm off-centre into the slot.
    The cause of hole 3 was not the chamfer. T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
    [mjcf.py, robot.py, route.py]
2026-08-28 Place all three samples: positive feed, escapement, and the intake fixes
    Full mission now scores +50 -- all three samples in the laboratory -- in 7 of 8
    randomised matches, up from +27 (two of three) in every match. Capture is 24/24
    over those 8 seeds with all three pieces properly seated.
    Getting there needed six things, each found by measuring rather than reasoning:
    * Tail roller moved to one disc RADIUS forward of the chute axis (Xa 36 -> 64).
    A piece is supported until its trailing edge clears the tail, so aligning the
    two -- the old F7 -- releases it already half over the bore and it jams
    edge-first. Measured: tail at 36 or 50 never seats, 56/60/64 always do.
    * Raised rear colla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
    [mjcf.py, params.py, robot.py, route.py]
2026-08-29 Fix the mission demo on a fresh clone, and make the belt number reproducible
    Two bugs the Windows run surfaced.
    demo_pick_place.py crashed immediately on any fresh clone. It writes the
    generated scene to sim/models/, but .gitignore excludes sim/models/*.xml and git
    does not track empty directories, so the directory simply is not there. It only
    worked here because an earlier run had created it. Now makedirs first.
    demo_belt.py reported the gate accumulation from a single instant after 8 s, and
    that number is not reproducible: 0.134 N here, 0.219 N on the same commit under
    Windows. Averaging over the following 2 s shows why -- the instantaneous force
    ranges 0.000 to 0.468 N. The queue never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
2026-08-29 Viewer pacing and fixed cameras, plus a script that audits the model
    Three things, prompted by watching it run.
    --speed paces the run against wall-clock time. --gui uses launch_passive, which
    hands the physics loop to the script, so the viewer does no pacing of its own and
    an unthrottled run is ~3x real time. --gui now defaults to 1x; --speed 0.25 gives
    quarter speed. It is a ceiling, not a floor, and it does not touch the physics --
    same seed, same score, verified.
    Three fixed cameras (field / lab / quar) reachable with [ and ] in the viewer.
    The free camera opens framing the whole 2000x1000 arena, at which distance the
    robot reads as one box.
    model_report.py prints the COMPILED model --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
    [mjcf.py, route.py]
2026-08-29 Retire two of the three big stand-ins, and find that the mission misses the match
    Answers the question "how do we know it will work once it is built" by removing
    the assumptions instead of arguing about them.
    THE LAB PLATE IS NOW SOLID (F24, retires F11). It used to sit on its own
    collision bit so the chassis ignored it -- a cheat present in every result so
    far. Re-tested honestly, against a SQUARE 3 mm edge with no approach ramp, the
    robot reverses up it unaided: 16-21 N peak on the rear ball transfers, and the
    full mission still places all three samples in 6 of 6 matches. F11's claim had
    simply stopped being true and nothing re-tested it.
    THE INTAKE HAS A ONE-MILLIMETRE CLIFF (F25). The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
    [mjcf.py, params.py, route.py]
2026-08-29 X-ray toggle, a third of the match back, and the fiction that was propping up the score
    X-RAY. Press X in the viewer to fade the six chassis plates and watch the belt,
    hold-down, chute, collar, escapement and feed plunger work inside; --xray starts
    that way. Rendering only -- geom_rgba does not touch contact, so an x-rayed run
    is bit-identical to a solid one.
    TIME. The match is 120 s and the mission took 158. Now ~105 typical:
    * Depart a hole by driving FORWARD off the plate instead of returning to the
    station it was approached from. That round trip spent an entire 35 s guard on
    one hole and never even arrived, then the next hole set off for a station on
    the other side of the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
2026-08-29 Withdraw F24, and find that the laboratory the rules imply is one this robot cannot dock at
    Went to build the physical-datum docking and found the premise broken, twice.
    F24 IS WITHDRAWN. It claimed Agent A climbs a square 3 mm laboratory edge
    unaided and that F11 had been overtaken. The rig it rested on LAUNCHED the robot
    at initialisation -- it crossed the field in 2 s of a 90 mm/s drive and never
    touched the laboratory at all. On a rig that verifies the robot has settled
    first, the original F11 stands:
    laboratory 1 mm 3 mm 6 mm 9 mm 12 mm
    result climbs BLOCKED BLOCKED BLOCKED BLOCKED
    The mission numbers quoted alongside F24 were real -- they ra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
    [mjcf.py, params.py, robot.py]
2026-08-29 Tail redesign: the robot now posts into a laboratory the rules would accept
    Every result before this was against a 1 mm decal in which a 5 mm sample cannot
    sit (F32). The laboratory is now 6 mm, samples drop right inside it, and the
    robot reaches OVER it instead of trying to climb it. Docking all three slots in
    isolation: 1.9-2.6 mm, 40 s, +50.
    Three changes, and one of them retires a finding that had shaped the whole route.
    THE TAIL OVERHANGS (F31/F33 adopted). Rear ball transfers Xa 40 -> 90, shell
    stepped up to 14 mm aft of them. A O20 ball cannot climb 6 mm -- it needs 2.25x
    the supported weight as push -- so the robot must reach over the laboratory. A
    sloped skid was tried first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
    [mjcf.py, params.py, route.py]
2026-08-29 Fix docking convergence: 10 of 12 matches now place all three samples
    Was 4 of 12 at +50 with a mean of +23; now 10 of 12, mean +41, and 8 of 12
    finish inside the 120 s match. Docks land at 1.4-2.0 mm in 8-19 s.
    Two causes, both about the drive being a pair of steppers rather than a servo.
    F39: THE REAR BALL TRANSFERS HAD ZERO MARGIN. At Xa 90 the arithmetic said 14 mm
    of clearance from the laboratory edge at the dock point; the MEASURED ball
    surface sat at Y 360 -- exactly on it. So each dock was a coin flip, and that is
    the whole bimodal 15-s-or-never result. The frozen state is unmistakable:
    fore=-5.5 left=2.6 herr=-0.3 v=-11.0 w=-8.3 |vel|=0.09 A_ball3/lab_s 13N
    identical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
    [params.py, route.py]
2026-08-29 Fix the escapement: the shelf was closing on the piece it had just released
    The magazine metered 3 of 3 on the bench and still lost samples in the mission,
    which is the signature of a timing bug rather than a geometry one. Watching the
    stack through a release, robot-frame:
    hole 1, works gate out d1(z= 5.4) gate back d1(z=2.5) landed
    hole 2, fails gate out d2(z= 7.2) gate back d2(z=9.1, dy -10.7)
    At hole 2 the released disc was still at Za 7.2 -- barely below the shelf line at
    Za 8 -- when the shelf came back after 0.28 s. The returning shelf caught it,
    swept it 10.7 mm sideways and left it jammed half in the bore, where the
    departure then dragged it along the laborat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
    [route.py]
2026-08-29 Implement the beam task: seal the quarantine, +70 in the rig
    The 70-point task now works end to end -- both beams standing free on their
    walls with the T-joint closed -- but only after six design changes, every one
    of them forced by a geometric fact the Rev C drawings do not show.
    F44 The pockets cannot have outboard walls. The sealed corner is 280x250
    and Agent A is 285 long, so once either beam is down the robot no longer
    fits beside the other. The pocket is now a channel whose outboard face
    IS the beam: inner wall, open bottom, end stop, drop-away lip.
    F45 A beam dragging on the floor cannot cross the 6 mm laboratory, and the
    loaded swept circle is 185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
    [mjcf.py, params.py, referee.py, robot.py, route.py]
2026-08-29 Make the beam phase work from where the mission actually leaves the robot
    The rig scored +70 from one start pose and +25 from the poses the laboratory
    phase really hands over. Four causes, all found by tracing the placed beam:
    * pursue() refuses a target more than 100 deg off the nose and returns
    instantly. After the last dock the robot faces south with the quarantine
    behind its shoulder, so both approach legs no-opped and place_beam was left
    to find its station from 400 mm away on a crab controller. 28 s of a 120 s
    match. Turn onto the bearing first.
    * The withdrawal from beam 2 used to crab onto the dress lane as it went,
    which walks the pocket's inner wall 78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
2026-08-29 Record the twelve-seed result: mean +69 at the buzzer, sealed 10 of 12
    Full-match sweep with both tasks, scored at the 120 s buzzer as the rules
    require. The laboratory gives up two of its three slots to pay for the seal --
    one sample and a closed corner is +79, three samples and no corner is +50.
    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
2026-08-29 Keep BEAM_BUDGET at 56, and write down what the build has to change
    Measured the alternative rather than arguing about it: at 44 s the laboratory
    gets a second slot, worth +18, and the seal then starts 15 s later and misses.
    Over twelve seeds the mean fell from +69 to about +50 with four matches past
    the buzzer and no beams down. The 70-point task has no slack, so it takes the
    clock first.
    README section 7 is now the list of Rev C departures the beam work forced --
    pocket walls, lifting cradles, the retainer length, the end-stop height, the
    clamp -- with why each one is not optional. None of them is expensive; the
    point is that they are all load-bearing.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
    [route.py]
2026-08-29 Halve the beam phase: 52-79 s down to 37-43 s, and +70 from every approach
    Prompted by the question of whether beam 2 should ride the front instead of
    the flank. It should not -- seating a beam endwise against a wall needs its
    long axis along the direction of travel, so a transverse carriage can only
    push broadside and loses the wall datum, and the front face is the intake,
    which has to sweep the samples up before the beams can seal them in. But the
    premise behind the question was right: the cost is manoeuvring, not placing.
    Measured, each placement is 6 s and each approach was 15-42 s.
    * pursue() circles a distant target instead of arriving -- from the third
    slot it spent its whole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
2026-08-29 F55: the robot was bolting itself to the laboratory with its own sample
    Seed 1 now scores +120 at T+111.9 -- three samples, both beams, quarantine
    sealed, inside the buzzer. It was +79.
    The bug is worth stating plainly because it did not look like what it was. A
    disc that perches on a slot's countersink instead of dropping through ends up
    pinched between that countersink and the escapement shelf returning over it:
    4 N on the shelf, 3 N on the cone. The robot then cannot drive off in any
    direction, and rocking does not free it. The disc still SCORES -- it is inside
    the slot -- so the referee says nothing, and the failure surfaces 20 s later
    and half a field away as a pivot that will not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
    [route.py]
2026-08-29 Run the laboratory to a deadline, and land the beam transit on its lane
    Seed 2 goes +97 -> +120 at T+114.9: three samples, both beams, sealed, inside
    the buzzer.
    * The laboratory ran on a per-slot budget, which has to be pessimistic
    enough for the worst dock and then throws away slots the robot had time
    for -- one match abandoned its third slot with 56 s left and sealed the
    quarantine in 39. It now runs to a deadline and can give up part-way
    through an approach instead, so it spends every second it actually has.
    * The transit waypoint moves to X 192, as far west as the loaded swept
    circle allows. It was 200, and the 8 mm left over was shuffled off by
    hand after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
    [route.py]
2026-08-29 Four failures behind one score: the T-joint, the pivot, the shuffle and the sweep
    Chasing the two seeds that placed both beams and still scored +100 turned up
    four separate defects, three of them invisible in the log.
    REFEREE FIRST, because it was scoring joints that are physically open. The
    T-joint test measured beam 2's centreline ENDPOINT against beam 1's centreline
    SEGMENT and then allowed a whole beam width of slack -- two errors that mostly
    cancelled. When they did not, beam 1 landing 5 mm high left a 7 mm air gap and
    still collected the +20. It now measures the two footprints face to face and
    allows only the 3 mm tolerance. Seeds 6 and 7 were reading +120; honestly
    scored they we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
    [referee.py, route.py]
2026-08-29 Write up F53-F61, and drop the two helpers the new tests replaced
    Nine findings from this round, six of them defects the score was hiding:
    F56 the T-joint test passed joints that are physically open
    F57 the pivot after beam 2 was never legal, and turn_to's recovery hid it
    F58 clearance to a placed beam is one-sided, so shuffles near one must be
    F59 every sweep pass has 62 mm of bulldozer, and north is the fatal side
    F60 the bore rangefinder reads a perched piece as a full magazine
    F61 a sluggish cascade is not fixed by raising its gain
    plus F53-F55, which were carried in code comments and never written down.
    Removes referee._seg_gap (the old T-joint measure) and route's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
    [referee.py, route.py]
2026-08-29 Settle the stack before asking the bore, drop the recovery pass, and record +110.3
    Twelve randomised matches, scored at the buzzer against the strict T-joint:
    seed 1 2 3 4 5 6 7 8 9 10 11 12
    BUZZER +120 +120 +50 +120 +97 +120 +120 +120 +120 +120 +120 +97
    finish 106 115 106 112 103 112 114 119 114 112 112 122
    T-joint 0.8 1.2 - 1.9 1.6 3.0 3.0 1.4 1.0 0.1 2.1 2.9 mm
    mean +110.3 sealed 11/12 all three samples 9/12 over the clock 1/12
    Nine matches at the maximum, against eight before this round -- and those eight
    were counted with a T-joint test that allow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
    [route.py]
2026-08-29 F62: the finger stroke was tried three ways and none of them is an improvement
    F1 says the intake needs an active ~110 deg finger sweep and that the Mechanism
    Explainer's 15.6 deg is nowhere near enough, so stroking the fingers through the
    pass looked like the answer to F59's 62 mm of bulldozer. Modelled it at the
    widest a +/-30 deg hinge can represent and measured it against the seeds that
    fail and the seeds that do not:
    seed parked tips +/-93 tips +/-88 stock +/-82.5
    1 +120 +97 +57 +50
    6 +120 +97 +120 +120
    3 +50 +97 +97 +120
    5 +97 +120 +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
2026-08-30 Camera controls for the viewer: translate, orbit, zoom, follow -- on keys as well as the mouse
    The mouse already did all three Blender operations -- left-drag orbits,
    right-drag translates, scroll zooms -- but ONLY on the free camera, and one
    press of [ or ] puts you on one of the model's four FIXED cameras, where the
    mouse does nothing at all and nothing on screen says so. That is almost
    certainly what "I cannot make the camera see certain parts" was.
    New rfgyc26/view.py::CameraRig, wired into both --gui demos:
    arrows translate over the field
    Page Up/Down raise, lower
    Home/End orbit
    - and = zoom
    1 2 3 top / from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
    [view.py]
2026-08-30 Correct the belt comment that says the intake reaches under the floor
    It has said "top surface 0.3 BELOW the floor plane" since before
    Chassis.BELT_NOSE_Z became 3.0, and the parameter carries the sweep that fixed
    it: <=5 mm captures 24/24 and >=6 mm captures 0/24, because the powered edge
    has to get under the piece's 2.5 mm half-thickness. A reader who trusts the
    old comment concludes the intake is a cheat that still needs designing, when
    what it actually is -- a knife-edge nose bar at 3 mm -- is buildable and
    already modelled. One of the two stand-ins here is real (the shim) and the
    other has not been true for some time.
    Claude-Sessi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
    [mjcf.py]
2026-08-30 F63: built the intake redesign, measured it, and reverted it
    The plan was to delete the sweeper fingers and widen the guide mouth to the
    chassis, on F59's account that a pass collects a ~110 mm band inside a 235 mm
    body so 62 mm either side is a bulldozer. Built all of it. Over the same
    twelve seeds:
    as built -- fingers, mouth 148 +110.3 all three samples 9/12
    fingers removed, mouth 148 +93.5 4/12
    fingers removed, mouth 162 ~ +69 (5 seeds) 1/5
    fingers removed, mouth 175, steeper ~ +77 (4 seeds) 0/4
    Every variant is a regression, so the code is back where it started and what is
    kept i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
    [mjcf.py, params.py]
2026-08-30 F64: the intake is real — knife shim + brush roller replace the powered-surface stand-in
    The locked redesign, built in contact and measured. Engagement: a 0.5
    spring-steel knife (108 wide, skived edge, servo-pressed to the floor,
    servo-lifted 35 deg for transit). Conveyance: a D50 silicone-finger brush
    roller on a sprung swing arm, N20-driven through a velocity actuator capped
    at real stall torque. The old A_belt box reaching the scoop tip at 3 mm with
    surfacevel — the simulator's biggest stand-in since F1 — is deleted; the belt
    now starts at its physical nose, moved forward to Xa 241 on a D10 roller so
    the drum's bite reaches it (no unpowered stretch anywhere; a disc bridges
    every gap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
    [mjcf.py, params.py, robot.py, route.py]
2026-08-30 F65+F66: honest sweep exit and passive-spring fingers — all twelve seeds at +120
    F65: dwell_until_loaded's early exit trusted a single mag_count sample, and
    a piece riding the belt crosses under the bore ray reading like a full
    stack for a few ticks — a sweep could end at T+13.8 with one disc aboard
    (seed 11, measured). The race is timing-sensitive, so it hid inside
    run-to-run variance through every earlier configuration. The exit now
    requires the count to hold at want for 1.2 s.
    F66: the sweeper fingers re-measured under the F64 intake, twelve full
    matches each way with F65 in: fingers +120.0 (12/12 at maximum) vs
    fingerless +108.9 (7/12) — eleven points a match, so they stay. But th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
2026-08-31 M2: score the other 130 points, and admit Agent A currently scores 90
    Mission 2 was outside the model entirely, which quietly flattered every
    number in the README. Three kit destination zones left empty is -10 each
    under the Senior table, so the Mission-1-only robot does not score +120 --
    it scores +90. That is now what the referee returns.
    params.M2 kit plan (6 hospital / 2 PCC-L / 2 PCC-R), 12 patients,
    4 of each colour, and the side-area boxes flagged
    [VERIFY]: the rulebook gives no coordinates for them,
    only "six cylinders on each side". One parameter, not a
    number sprinkled through the code -- F21 and F3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
2026-08-31 Laboratory: see the slot instead of feeling for it (F67-F70)
    The laboratory cost 53 s of a 120 s match for 50 points -- 44% of the clock,
    measured over six seeds -- and Mission 2 is worth 130 with nothing left to
    spend on it. The escapement was never the problem; the DOCK was.
    F67 THE REFEREE WAS SCORING DISCS THAT WERE NOT IN THE SLOT.
    The test allowed 10 mm of radial error and a centre height of
    LAB_PLATE_T + DISC_T, so a disc lying FLAT ON TOP of the plate 9 mm off
    the hole passed both and scored +15. The rules say "completely inside"
    (2.1). Now: radial <= 3.0 (a disc physically inside a O60 bore cannot be
    more than 2.0 off) and the disc's top no higher than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
    [mjcf.py, params.py, referee.py, robot.py, route.py]
2026-08-31 README: the honest +90, and what F67-F70 changed
    Status rewritten around the two numbers that are actually separable -- the
    sweep delivers 34 of 36, the dock places 34 of 34 -- because conflating them
    is what made a dock regression look like an intake one and vice versa.
    Explains why +90 replaces +120: F67's slot test (a disc lying flat ON the plate
    used to score) and the -30 for three empty kit zones that Mission 2 has not
    been built to fill.
    F67-F70 written up in full, including the two findings that came out of
    comparing the sensor model against actual depth renders: the naive hole-centroid
    bias (1.5-2.4 mm, constant with range, signed by viewing offset -- fit the top
    rim instead) and t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
2026-08-31 Mission 2, part one: deliver the kits (+86.6 -> +125.1)
    The kits were 80 points of swing sitting untouched -- three empty destination
    zones is -30, and the full 6/2/2 distribution is +50 -- and none of it needs a
    pick-up, because rules g.1 let the kits start ON the robot. So they are loaded
    into three hoppers before the match and delivery is one MG90S flap per zone.
    MEASURED, twelve randomised matches, scored at the buzzer:
    mean +125.1 (was +86.6), max +175, min +81
    kits delivered on every seed; two seeds take the full 6/2/2
    laboratory phase 32 s for three slots (was 53, then 41)
    Six things had to be found by measuring, and each was invisible until then:
    THE ROUTE. A strai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
    [mjcf.py, params.py, robot.py, route.py]
2026-08-31 Patients were phantoms; make them solid, and stop lying about the fingers (F71/F72)
    Two modelling errors, both mine, both found by asking the simulator a question
    it had never been asked before -- can the intake take a PATIENT?
    F71 THE PATIENTS COULD NOT TOUCH THE INTAKE AT ALL. Samples carry collision
    bits 0-2; the cylinders carried only 0-1, and the whole intake -- knife,
    blade, drum -- lives on bit 2. They were driving straight through it.
    The first answer the rig gave was "10 of 10 bulldozed", which was a
    collision filter and not physics. A finding that is really a mask is the
    most expensive kind, so the fix is asserted in the geometry checks.
    Solid, t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
    [mjcf.py, params.py, robot.py]
2026-08-31 Six intake faults, and the laws that should have caught them (F73)
    Step 2 of "find where the roller goes" could not be answered because the
    model of everything around the roller was wrong. Found and fixed, in the
    order they bit:
    1. The knife's 6 deg servo droop had nothing to stop it. The plate is
    floor-excluded (a razor at floor level is a wall, not a wedge), so
    commanded to droop it simply SANK: tip 3.75 mm under the floor line
    instead of 0.34, ramp 26 deg instead of 20, knife edge effectively
    6 mm aft of where params says it is. F64's "5 of 5 samples" was
    earned by that sunken knife -- with the tip at nominal the rigid drum
    scores 0 of 5 too. The joint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
    [mjcf.py, params.py]
2026-08-31 Standing model tests, and the roller question settled on a bench (F74)
    TWO STANDING TEST SUITES, to be run on every change.
    check_geometry.py re-derives params against each other (48 checks)
    check_model.py BUILDS the scene, settles it, commands the intake to
    collect, and interrogates what actually resulted
    (20 checks)
    The second is new and is the one that matters: every expensive fault so far
    has been invisible to params and obvious in the built model. It asserts the
    knife's edge sits just under the field and not buried; that the servo's droop
    lands on a stop; that razor and plate form ONE unbroken ramp with no step to
    climb; that nothin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
2026-08-31 The patients are a floor problem, not an intake problem (F75)
    THE REFEREE WAS MISSING THE PENALTY, AND IT IS THE WHOLE GAME. Senior
    scoring: +5 for a patient inside its correct destination zone, -5 for one in
    an INCORRECT destination zone (rule 4.4), -3 for one left outside it. All
    twelve start on stickers in the side areas, which are not destination zones,
    so a robot that ignores them does not score 0 -- it scores -36. score_kits
    already applied the Senior -10 for an empty kit zone, so the omission was an
    oversight, not a ruleset choice.
    The honest board, 12 seeds, scored at the buzzer:
    samples 27 of 50
    beams ~40 of 70 (70 in only 5 of 12 seeds)
    kits 24 of 50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
    [mjcf.py, params.py, referee.py, route.py]
2026-08-31 Strip the cylinder work off Agent A -- it is a second robot's job (F76)
    Three mechanisms lived on this robot solely to make a O20 x 20 patient go up
    a knife sized for a O56 x 5 sample. All three are gone:
    UPPER ROLLER (F71) an over-under pair. Measured over twelve matches with
    it fitted: +113.2 against +125.1 without, and the
    laboratory dock fell from 30 samples of 36 to 26.
    TRIP BAR (F71) a bar to lay a standing cylinder down. 0 of 5 standing,
    and it made the lying case worse.
    PLOUGH (F75) pushed 6 of 6 into PCC_R at ~5 s each -- and BLOCKED THE
    SAMPLES, 35 of 36 swept down to 14 a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
2026-08-31 The kit loop drove over the kits it had just dropped (F77)
    Every hopper discharges over a flank, so each drop lands ~140 mm to one SIDE
    of its station -- and all three stations sit on the same y 930 line. Driving
    straight from one to the next therefore runs the robot along the very latitude
    it has just covered in kits.
    Traced, seed 4:
    T+65.5 kit 0 lands at (592, 923) -- INSIDE the hospital
    T+70.0 robot at (663, 767) heading 158, running the diagonal to PCC_L
    T+71.5 kit 0 dragged to (397, 1022) -- 74 mm outside
    Kits 0 and 3 -- the rearmost HOSP column, in both layers -- went out that way
    in eleven of twelve seeds, and took the +20 for the 6/2/2 distribution with
    them. The s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
2026-08-31 Tape the knife: the wall was doing the intake's job (F78)
    Observed in the viewer and then measured: the samples are not being picked up
    by the roller, they are being pushed against the west wall and picked up there.
    Logging every contact on each sample at the instant it leaves the field:
    10 of 15 captured at x 28-30 -- the disc's west edge ON the wall, and
    three of them with wall_w in the contact list
    5 of 15 captured mid-field
    Which is exactly what the wedge law predicts. A piece resting on the field is
    held only by mu_field*W, so the knife gets under it rather than shoving it only
    while ramp + atan(mu_knife) <= atan(mu_field) = 31.0 deg. Bare steel at 0.30
    gives 20.1 + 16.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
2026-08-31 Roller onto the shell line, and belt speed measured rather than assumed (F78b)
    ROLLER AXIS. At 262/25.5 the finger tips stood 2 mm OUTSIDE the 285 shell --
    a build problem, not a simulation one -- and reached 3.7 mm BELOW the knife
    ramp under their own axis, where the ramp carries the brush instead of the
    piece. 260/31.4 puts the tips exactly on the shell line and 1.5 mm clear of
    the ramp, still biting 3.5 mm into a 5 mm sample lying on it. Score-neutral
    (+95.6 -> +95.2, against a seed-to-seed spread of +-50), two checks green.
    The old "drum bite starts below a disc's top face" is now brush-aware: with
    the tubes fitted the collision cylinder is the HUB and the biting surface is
    the tips,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
    [params.py]
2026-08-31 Model check follows params: belt speed is judged by the throw (F78c)
    The model suite still asserted the belt-beats-sweep condition that the
    measurement retired. It now checks the discharge throw, which is what belt
    speed actually decides. 20 of 20 model checks and 48 of 48 geometry checks
    pass.
2026-08-31 Laboratory is 5 mm, per the drawings; demo documents the current model (F81)
    LAB_PLATE_T 6.0 -> 5.0, and it is no longer an inference. The rulebook's
    drawings have the laboratory as a separate wooden structure laid on the board,
    5 mm thick, with the three O60 slots cut clean through -- so its outer edge is
    a 5 mm step and each slot is a 5 mm deep hole down to the board. A 5 mm sample
    dropped in sits exactly flush, which is what "completely inside" means, and a
    sample cannot be SLID in: it has to clear a 5 mm edge and drop.
    That closes the question the cupped-pusher idea rested on. The one piece on
    this robot that must leave the floor is the sample, and it is the bore that
    requires it --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
    [mjcf.py, params.py]
2026-09-01 The HAL: one contract, two machines; robot.py becomes its MuJoCo backend (F83)
    Step 1 of the system-design build order. hal.py is the file both machines
    agree on -- standard library only, no mujoco, no numpy: DriveHAL, DeviceHAL,
    CameraHAL (lands in step 2), LinkHAL with robot 2's v0 wire grammar encoded
    once (V/K/SHAKE, 250 ms dead-man -- robot 2 is a detached actuator of this
    robot, per the decided architecture), and Clock, whose tick IS route.py's
    existing yield-per-20ms convention, formalised.
    robot.py implements it. odometry() replaces odo_steps, which integrated each
    command over ONE physics substep instead of the whole control period it was in
    force -- a 20x under-count that never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
    [hal.py, robot.py]
2026-09-01 Rendered perception: the Pi's pixel pipeline, fed by the sim's cameras (F84)
    Step 2 of the build order. perception.py is pixels-in, robot-frame-out and
    imports neither mujoco nor cv2 -- it is the file that ships to the Pi. The
    slot is measured by its OUTLINE, split onto the two circles it actually is:
    the near arc is the plate's top rim (r 30.5 at z 4.5, the chamfer's grazing
    edge) and the far arc is the far bore wall's BASE (r 30 at z 0) -- the wall
    is plate-coloured, so the far top rim is chromatically invisible, and fitting
    the far arc on the wrong plane is exactly the crescent-centroid bias
    params.Vision warns about. Each arc back-projects onto ITS plane; a circle
    of KNOWN radius give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
    [mjcf.py, params.py, perception.py, robot.py]
2026-09-01 The estimator: odometry + gyro + fixes; mission code reads no ground truth (F85)
    Step 3 of the build order. estimator.py ships to the Pi: a 3-state filter
    whose motion model is what the sensors actually give --
    * commanded-step odometry, with the stopping COAST booked per stop (the
    'scale error' measured in check_hal was v*tau ride-through, tau 15 ms;
    modelling it as a scale would corrupt every short leg);
    * a rate-INTEGRATING gyro for heading (wheels scrub: 0.71 pivot
    efficiency; and sampling a rate gyro at 50 Hz aliased fast transients
    1-2 deg per pivot -- the model now integrates like the part does);
    * StallGuard judged by the estimator, not trusted raw: sustained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
    [estimator.py, hal.py, robot.py, route.py]
2026-09-01 The planner: exact prize-collecting tour replaces every budget; PCC_R rides on robot 2 (F86)
    Step 4 of the build order. planner.py ships to the Pi: the match after the
    sweep is a prize-collecting TSP with precedence over six stations, solved
    EXACTLY by Held-Karp -- check_planner holds the DP against brute-force
    enumeration of all ~2000 orderings, so the optimiser has nowhere to hide --
    over a cost model measured from phase-stamped runs and held against the
    stopwatch by the same suite. BEAM_BUDGET, KIT_BUDGET, HOLE_BUDGET and
    MIN_DOCK are gone: latest_start() is the deadline arithmetic they
    approximated, observe() re-prices a slow dock for the rest of the match
    (the old est=last-dock trick,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
    [mjcf.py, params.py, planner.py, route.py]
2026-09-01 Trajectory: transits that do not stop; the departure pivot that never was legal (F87, F88)
    Step 5 of the build order. trajectory.py ships to the Pi: two primitives
    in the route's generator convention, consuming only rb.pose/rb.drive.
    * track_waypoints -- pure pursuit through corridor knees with corner
    speed caps: slows INTO a known turn (the corner's angle is knowable
    before the target switches; reacting to heading error alone entered
    an 80-degree knee at 210 mm/s, a 200 mm arc that pinned the nose
    corner on the east wall), strict mode for knees whose whole point is
    the detour, reverse mode on back_to's steering law.
    * capture_line -- acquire an approach LINE and ar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
    [planner.py, route.py, trajectory.py]
2026-09-01 Design doc: step-5 landing note -- boards, F88, and the residuals step 6 chases
    Truth board +65.5 (docks 85%, ceiling 134 reached on two seeds); est-nav
    board -2.3 with a green estimator suite, so the flip stays deferred and
    the gap is named as behaviour tolerance, not filter error. Step 6's
    targets written down while the logs are fresh: dock variance, the beam-1
    tail, the est-nav dock/sweep gap.
    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
2026-09-01 Step 6, first increment: docks to 94% -- the step-across was a threshold, not a mode (F90)
    The re-profile chased the plan-vs-actual report's residuals and the dock
    lever paid out. Every step-across the boards ever fired was a 37-45 mm
    miss at the look station -- just past the 36 mm the tracked reverse and
    trim slide could absorb inline -- so reverse_track's crab authority goes
    5 to 8 degrees and the threshold to 46: docks 62/66 (94%) over a 24-seed
    board, all three slots on 18 of 24, five seeds at the full 144-point
    robot-1 subtotal, and the DP funds PCC_L again. Board mean +57.2 x24;
    the beam phase is now the one dominant variance term (b70 x10 / b25 x9 /
    b0 x3, ~25 pts of swing a seed).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
    [planner.py, route.py]
2026-09-01 Robot 2 exists: body, DC plant, LinkHAL sim end, camera-fix controller (F93)
    Step 7, first increment. params.Robot2 + mjcf.robot2_body: a 150x110
    differential-drive body -- NARROW on purpose, because the field's two
    north-south pinches (patients at x 160 vs the plate's west face, the
    plate's east face vs patients at x 983) are 191 mm of air and robot 1
    can thread neither -- with a 120 mm plow pocket for O20 patients, a
    front-low tilted kit tray whose 1.2 mm tail lip overhangs the chassis,
    an ArUco top plate, two velocity-servo wheels whose force cap plays the
    DC motors' stall headroom, and three stiff ball casters (the soft pair
    let the nose sink until the plow dug the floor at full accel -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
    [mjcf.py, params.py, robot2.py]
2026-09-01 Robot 2 plays the match: mission, fleet driver, camera-verified pushes (F94-F96)
    The fleet exists. mission_robot2 runs the whole 120 s: kits into PCC_R
    by T+15, the west sticker columns cleared inside robot 1's keep-out
    windows, the east columns after robot 1 seals. Fleet board over five
    seeds: +1.5 -> +18.5 -> +56.4 -> +77.2 mean across this commit's four
    mechanisms, max +112.
    F94 -- the push catalog is WALL GEOMETRY: every column pushes along
    itself; mid columns take +-65-degree diagonals (the approach's 93 mm
    corner circle needs 11 mm of wall margin); edge-column reds and greens
    are priced adrift, not fought. Within a column, bottom row south and
    top row north cross nothing; the middl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
2026-09-01 The fleet plays whole matches: +63.3 mean, max +126 over 12 seeds (F97-F98)
    mission_robot2 v5, the all-east mission: kits into PCC_R by T+15, the
    east patient columns worked EARLY (they are robot-1-free until the kit
    climb at T+56 -- and working them first means the climb's plow-pile
    holds only what is left), a hold in the north-east dead corner through
    the climb, the pile mopped after T+74 from live re-classification, and
    a verified park where no robot-1 artery ever drives.
    What the boards taught, the hard way:
    * F97: the WEST mid column is mutually locked -- every diagonal's
    approach or sweep lands on a sticker or inside the wall's 93 mm
    corner circle, and every N-push approach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
2026-09-01 Design: robot 2's control architecture, rebuilt as a stack instead of a script
    Watching the fleet play gives an unambiguous verdict, and it is not a
    tuning verdict: robot 1 was built as an autonomy stack and robot 2 was
    built as a script. Every visible failure follows from that.
    * "blind, not reacting" -- the plan is built from a T+0 SNAPSHOT and
    executed to the end; colour is read once and only selects one of a
    few hand-written route templates keyed on sticker column.
    * "gets stuck" -- goto() is a straight-line heading-P pursuit and
    THERE IS NO MAP. The plate, the walls, robot 1 and the other
    eleven pucks exist in no structure the controller can see, so it
    cannot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
2026-09-01 Design correction: plan the fleet ONCE at the gun; the control cascade is missing its inner loop
    Two corrections to section 15, both from the right question being asked:
    "is this a single plan at the start that both robots then follow?"
    FIRST -- no, and the draft was wrong. Section 15.5 had the task layer
    re-solving continuously. The board is FULLY OBSERVABLE at T+0: the only
    randomness the match holds (three sample positions, which colour stands
    on which sticker) is visible from the start line, and everything else is
    fixed by the rulebook. That makes this a deterministic planning problem
    and it deserves the treatment planner.py already gives robot 1 -- solve
    it exactly, once, and execut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
2026-09-01 Rebuild 1-3: the costmap, the A* planner, the encoder inner loop, DWA (F99)
    nav.py -- the map the project never had. A 20 mm costmap (58x60) with the
    walls and the laboratory plate as DATA, obstacle discs for the patients,
    sticky penalties where jams happened, and space-time windows for the other
    robot's corridors. Grid A* over it plans any leg of the board in 1-7 ms and
    simplifies the staircase to knees; a corridor reserved T+58..73 is an
    obstacle to a path that would be there during it and open floor to one that
    would not. Two-stage: strict first, then windows-as-cost, because a robot
    STANDING inside a reserved corridor still needs to be told how to leave.
    This retires the hand-picked w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
    [mjcf.py, nav.py, params.py, robot2.py]
2026-09-01 Rebuild 4-5: push search, the planned mission, survey-driven sweep, check_nav (F100)
    The push planner is real now. nav.plan_push searches the puck's plane --
    16 headings x 7 distances, up to three legs, each action feasible only if
    the costmap says the approach pose is standable, the body sweeps the whole
    push clear, and the release pose is free. Per-heading footprint masks make
    it 0.3 s a puck instead of 3.5 (the point-by-point version cost 40 s of an
    opening plan that has 120 to spend). Three legs, not two: a west green must
    get south past the plate and then 640 mm east, and no two straight pushes do
    that -- every green came back NO PLAN at two.
    mission_robot2 is no longer a script. S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
    [nav.py, robot2.py, route.py]
2026-09-01 Report scores as X/250 -- mean over the full-game maximum, everywhere
    Boards printed raw referee deltas and per-phase codes (+63.3,
    s50b70k14p-38) with no denominator, which hides whether the work is
    winning. mrun_fleet now prints per-seed 'sam 50/50 beam 70/70 kit 50/50
    pat 44/80' and a mean out of 250; section 11 of the design doc states the
    convention and the decomposition it rests on.
    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
2026-09-01 Robot 2: the push approach does not need to be precise (F101)
    Traces showed robot 2 spending 12-20 s per patient and delivering none,
    with "approach blocked" every time. The cause was the mission asking for
    an exact pose 130 mm behind the puck on a 34 mm tolerance, then abandoning
    the patient when the tracker could not nail it.
    A push does not need that. It needs the chassis BEHIND the puck, FACING
    the push line, with the puck inside a 120 mm pocket -- which is the whole
    reason the plow is wider than the body. So: park loosely 250 mm back on a
    70 mm tolerance, turn onto the line, then close the last 120 mm in a
    straight run and let the plow's mouth do the centring. The straight close
    ne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
    [robot2.py]
2026-09-01 Sweep lanes: let the survey choose, but only inside the proven band (F101)
    A/B over 12 seeds, everything else identical: blind lanes and survey lanes
    both scored 38/250 -- with opposite composition. Blind took full sample
    marks on 10 seeds of 12 and left beams and kits starved; survey took them
    on 4, and the time it freed bought back an equal amount in beams and kits.
    So planning the sweep from the survey is right, and the first implementation
    gave the freed time away. 130 and 215 were never arbitrary: they were tuned
    against 24 randomised samples and the sweep's SHOVING behaviour is tuned
    with them -- below ~130 the mouth rides the south wall, above ~215 a pass
    pushes samples out of the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
2026-09-01 The leave-clean invariant: a push may not park a patient in robot 1's way (F102)
    Board v10 reached 58/250 (samples restored to full marks on 9 seeds of 12,
    kits on 4) with one stark hole left: beams at 0/70 on five of twelve. The
    tell was seed 10 -- the BEST patient score on the board and zero beams. When
    robot 2 works patients hardest, robot 1's seal dies.
    It is not robot 2's body: the space-time reservations already keep that out
    of the corridors. It is what robot 2 LEAVES BEHIND. It was obeying the
    reservations with its chassis and then shoving patients straight into them.
    Keeping yourself out of the way is not the same as leaving the way clear.
    That is the leave-clean invariant thi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
2026-09-01 Patients: three bugs, all suppressing the same 80-point column (F102)
    A patient-by-patient ledger for one seed showed robot 2 attempting three
    patients and then QUITTING AT T+48.9 with sixty seconds on the clock,
    announcing that nothing was deliverable.
    * The leave-clean mask forbade correct deliveries. Robot 1's kit corridor
    runs straight through the hospital zone, so parking a red patient in its
    OWN destination read as a corridor violation. Once that rejected every
    remaining patient the mission concluded the board was finished. A
    scored patient is not an obstacle: the four destination zones are exempt.
    * "Nothing deliverable" was treated as terminal. It is not -- r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
    [robot2.py]
2026-09-01 Batch the physics between servo ticks: 2.4x faster, and more honest (F103)
    A 12-seed board was taking ten minutes for twelve 120-second matches, which
    works out at ~1.7 ms per physics step against the ~0.03 ms this model needs
    from the engine. The physics was a rounding error next to interpreter
    overhead: when the wheel servo moved inside the link, it began stepping
    MuJoCo ONE STEP AT A TIME from Python with a servo update wrapped around
    each -- 120,000 iterations and ~2.4M numpy calls per match.
    The servo now runs at SERVO_HZ and mj_step loops in C between ticks. And
    SERVO_HZ drops 1000 -> 200, which is the honest number: a Pico W running a
    PI loop in MicroPython does 100-200 Hz, and pre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
    [params.py, robot2.py]
2026-09-01 The patient deadline is the fleet's arithmetic, not robot 2's (F104)
    Board v12 came back at 51/250, DOWN from v11's 62, and inverted the
    diagnosis behind it. I had called robot 2's early quit at T+49 a bug that
    threw away half the match. It was not: it was accidentally protecting the
    seal. Letting robot 2 work patients to the buzzer moved beams from 0/70 on
    three seeds to eight -- roughly +2 points of patient score for -11 overall.
    The arithmetic robot 2 was not doing: a patient is worth 8 marginal points
    and the seal is worth 70. A robot still moving near the west at T+80
    disrupts the seal WHATEVER the reservations say, because the reservations
    are fixed corridors on fixed windows whil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
    [robot2.py]
2026-09-01 Robot 2 gets a grab: the plow becomes a capture pocket (F106)
    The observation that drove this: robot 2 "has no mechanism to grab, that is
    why it is struggling." Correct, and it explains every symptom. Everything
    robot 2 did was open-loop shoving; the puck squirted out of the pocket on
    any turn, so a delivery had to be decomposed into multi-leg STRAIGHT pushes,
    each leg needing its own standable run-up, and for the sticker columns those
    mostly do not exist. The profiler put a number on the consequence: robot 2
    was STOPPED for 87% of the match, having decided nothing was deliverable.
    A capture needs no extra actuator. A deep U opening forward holds the puck
    on three sides -- two parallel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
    [mjcf.py, nav.py, params.py, robot2.py]
2026-09-01 The pocket made the robot 214 mm long and nobody told the planner (F107)
    The capture pocket put its flare tips at x=136. Every planner in the
    stack still described a 156 mm robot: nav.BODY_PTS stopped the footprint
    at 78, R2Controller._CORNERS agreed, and A* hard-blocked at an inscribed
    radius of 55. So every path was routed for a chassis 60 mm shorter than
    the one that had to fit, and the contact dump says exactly what that
    costs: labcone1_20 x r2_flare_r, 3.51 N, the flare shouldering into the
    laboratory plate's south edge while the planner believed the pose clear.
    Two ways out, and only one of them keeps the robot able to cross its own
    board. Planning at the real 93 mm reach shuts the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
    [nav.py, params.py, robot2.py]
2026-09-01 The capture pocket was welded shut by the robot's own deck (F108)
    Twelve of twelve deliveries came back "capture missed", and the reason was
    not the tracker, the approach, the stand-off ladder or the friction model.
    It was that no patient could physically enter the pocket. The chassis deck
    ran from x -55 to x +95 -- twenty-five millimetres PAST the flare tips --
    at z 9..15, straight through the height band a 21 mm patient occupies. The
    mass block sat in the same band behind it. The funnel opened onto a wall.
    The measurement is unambiguous once you ask for it. Printing the patient's
    position in the CHASSIS frame through a capture:
    capture puck in chassis x 109.8 y -33.9
    cap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
    [mjcf.py, nav.py, params.py]
2026-09-01 Price the board with the referee, and let robot 2 read robot 1's plan
    Three root causes, one theme: two robots sharing a board were each
    reasoning about a world the other one was not in.
    F109 -- THE SCORE IS NOT SEPARABLE ACROSS ROBOTS. planner.py priced each
    station with a hand-set constant and bolted on a special case for the one
    joint bonus it knew about. KL (robot 1's PCC_L kit drop) was priced at
    "2 kits x3 +10 = 16" -- correct only where PCC_R stays empty, which the
    comment beside it admitted in as many words: "PCC_R belongs to robot 2 and
    is not this robot's problem." It is exactly this robot's problem. The kit
    column pays +20 for the distribution 6/2/2 and -10 per EMPTY zone, so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
    [mjcf.py, planner.py, referee.py, robot2.py, route.py]
2026-09-01 Robot 2 stops guessing: verify the kit drop, aim the approach, never pivot loaded
    Fleet 47 -> 75 / 250 over the same twelve seeds (robot 1 alone: 50).
    F115 -- THE KIT DROP WAS FAILING SILENTLY, and it is worth 36 points to
    the fleet, because robot 2's two kits in PCC_R are what turn robot 1's
    PCC_L drop into the 6/2/2 bonus. In isolation the drop works on ten of
    twelve seeds. In a match it did not, and nothing noticed, because nothing
    looked: tracking the two kits through a full match shows them still on the
    tray twenty seconds after the shake, their positions following robot 2's
    exactly from (747, 717) to (1046, 1001), dribbling off one at a time while
    it drove away. So the mission now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
    [nav.py, robot2.py, trajectory.py]
2026-09-01 The seal is worth 70 only if it starts in time (F117); kit drop stands centre
    Fleet 75 -> 81 / 250 over the same twelve seeds.
    THE PLANNER PRICED A SEAL IT COULD NOT FINISH. seal_quarantine places
    beam 2 first and then refuses to begin beam 1 with less than BEAM1_TAIL
    (18.5 s) on the clock -- correctly, since a seal that dies mid-beam-1 drags
    beam 2 off its line with it. But the schedule valued BEAMS at a flat 70
    and budgeted it at its 31 s mean, so it would happily set the seal off as
    late as T+87. Beam 2 then lands around T+105, past the T+101.5 that leaves
    beam 1 its tail, and the match banks 25 where the plan said 70. Three
    seeds of twelve were losing 45 points to that arithmetic.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
    [planner.py, robot2.py]
2026-09-01 capture_approach must check the pose the robot ENDS in (F119)
    It validated the stand-off -- 150 to 185 mm back from the patient, where
    its neighbours are comfortably far away -- and nothing else. The capture
    ends 26 mm from the patient, with a 157 mm chassis among neighbours 80 and
    113 mm apart, and there the TAIL corner lands on the puck behind. Broken
    out stage by stage on the east block: every heading the search offered put
    a corner inside a neighbour, so the turn-out check refused all of them and
    robot 2 reported twelve patients undeliverable on a board where three had
    clean two-second carries to RECOVERY. Same class as F107 and F108 -- a
    planner describing a robot that is not the one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
    [nav.py]
2026-09-01 Speed follows clearance: robot 2 stops wedging itself on the plate (F121)
    THE BOARD GIVES ROBOT 2 TWO WAYS NORTH AND BOTH ARE PINCHES. Between the
    laboratory plate and the east patient column there are 176 mm of gap for a
    chassis A* plans at a 150 mm diameter; the west side is the same. Asked
    for a route at any inscribed radius above 75 there is NO PATH AT ALL out
    of the deployment box -- the pinches are not a shortcut, they are the only
    doors.
    A tracker running at 360 mm/s carries more cross-track error than 26 mm of
    slack allows. Watching robot 2 leave the box in a real match: it clips the
    plate's south-east corner four seconds in and stays wedged there --
    r2_ball_fr on lab_m6 at 2.0 N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
    [nav.py, robot2.py]
2026-09-02 The gate, the fleet executive, and the two ceilings above them
    Robot 2 gets a servo gate on its capture pocket, the two robots get a
    traffic protocol that cannot deadlock, and two hard ceilings on the score
    come down. Measured over twelve seeds, 32 -> 49 / 250 so far, with the
    patient column still to land.
    THE GATE (F114 was a negative result). Passive barbs retained perfectly
    -- IN 6/6, BACK 6/6 through 250 mm of reverse -- and could not release:
    shake, spin, spinrev and wiggle all 0/3, and softening the spring below
    the release threshold drops it below the 0.025 N the floor drag needs to
    retain. Entry and release share one force budget, so no passive geometry
    solves both. An SG90 on a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
    [fleet.py, hal.py, mjcf.py, params.py, planner.py]
2026-09-02 Robot 2 could not leave a capture it could reach (F133), and three more
    The patient column has been -29/80 against a possible +80 -- a 109-point
    hole, and the only column on the board carrying a signal rather than
    noise (paired over twelve seeds: patients +/-2.4 s.e., beams +/-12.7,
    kits +/-10.7). Traced, it was not one fault but four, each of which
    hides the next.
    F128 A RESERVATION IS A PREDICTION, SO IT PRICES A TRANSIT RATHER THAN
    FORBIDDING ONE. Both legs of a delivery were planned strict: a path
    crossing a corridor robot 1 had booked was unavailable, not dear.
    Measured against robot 1's own published plan that is not a
    restriction, it is a shutdown --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
    [fleet.py, robot2.py]
2026-09-02 Robot 1's speed follows its clearance to robot 2 (F137)
    Removing robot 1's fleet veto (F125) fixed the deadlock and introduced a
    worse thing. Measured, robot-to-robot contact over one match:
    seed 1 3511 ticks, peak 38.4 N, T+36.0 to T+37.8
    seed 3 17046 ticks, peak 20.7 N, T+88.3 to T+120.3
    Thirty-two seconds of two chassis grinding together, straight through the
    beam seal's window, at eighteen times the 2.1 N impact that started this
    whole line of work. Not braking for robot 2 is right; driving at it
    unchanged is not.
    The distinction that matters is between a STOP and a SPEED LIMIT. A stop
    is what deadlocks -- two agents that both wait have a cycle in their
    wait-for graph an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
    [fleet.py, robot.py, robot2.py]
2026-09-02 A pinch is a property of a place, not of a route through it (F138)
    Robot 2's delivery cycle measured 28.5 s on the phase rig, of which 18.1
    was transit -- an effective 61 mm/s against a 330 mm/s cap. In a match
    that affords three patients where the column needs eight.
    approach 9.9 face 1.8 capture 4.1 turn 3.1 carry 8.2 release 1.5
    The speed limit that F121 added to stop robot 2 wedging on the laboratory
    plate was computed in goto() from min_clearance over the WHOLE path and
    then applied to the whole drive. So a single 85 mm pinch anywhere along
    900 mm of route put the robot at 110 mm/s for all 900 -- and with eleven
    patients, two walls, the plate and robot 1 all stamped in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
2026-09-02 Robot 1 drove its kit approach through four patients (F141), and threw blind (F140)
    The kit column averages 19 of 50 over 24 seeds and its commonest value is
    14, which is exactly "PCC_L empty". Two faults, both in the leg that
    delivers it, and neither visible from the board.
    F141 PCC_L SITS EAST OF THE PATIENTS, NOT ON THEM. At station x 240 the
    235 mm-wide chassis spans x 122..357 and the west sticker column
    stands at x 160 -- a 47 mm overlap, so every PCC_L approach drives
    THROUGH four patients. Usually it shoves them aside. Measured on
    the kit rig, two runs in six it beached on one: robot 1 sat at
    (202, 761) for twenty-eight seconds, moving three millim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
2026-09-02 A gate must model the behaviour it guards (F145), and three more from one trace
    Traced robot 2 through two matches with its log on. Four faults, each of
    which was hiding points behind a test rather than behind a mechanism.
    F145 _can_turn_out ONLY EVER ASKED ABOUT THE WIDEST ARC. carry_turn now
    tries three radii each way before it borrows room behind (F139), and
    the predicate that decides whether a delivery is worth attempting was
    never told. A gate stricter than the behaviour it guards refuses work
    the robot could do: measured over twelve seeds' opening boards it
    refused 57 of 144 patients -- forty per cent of the column, every one
    of them on this tes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
2026-09-02 The gate raised the carry speed too (F146); and a rig that could not fail
    F146 CARRY_V was 190 mm/s and its reason (F106) was the OPEN pocket: the
    cargo rode against a stop with nothing in front of it, so any lateral
    acceleration walked it out of the mouth -- the same fact that forbade
    the pivot. Shut, the gate is what holds it. Measured on a new rig
    (rig_carryv, a 700 mm dogleg with a patient aboard):
    190 mm/s held 3 of 3 350 mm/s held 3 of 3
    270 mm/s held 3 of 3 420 mm/s held 3 of 3
    with the seated gap growing only from about 25 mm to 35. So the speed
    goes to 300. What has NOT changed is the geometry: carry_turn's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
    [robot2.py]
2026-09-02 Price a delivery by how comfortably it can be left, not just whether (F147)
    F145 opened the turn-out gate to the tighter arcs carry_turn had learned,
    and patients that price per board went from 7.2 of 12 to 9.9. The board
    then went the other way: paired over 24 seeds the patient column fell 6.2
    points, which is significant against its 2.3 standard error. Admitting
    more deliveries is only worth it if they land, and nothing in the pricing
    distinguished a manoeuvre with every margin intact from one with none
    left -- an arc that fits at 130 mm from where the robot stands is what
    these clearances were measured on; one that needs 70 mm after backing
    200 mm out of a sticker column is the same man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
    [robot2.py]
2026-09-02 station.py: the pose solver, replacing four hand-computed answers
    The mission layers carry 460 and 430 numeric literals against 5 in hal.py,
    and a large share of them answer one question in four different voices:
    where do I stand so that when I actuate this thing, the payload lands in
    that region and my body is somewhere legal?
    AgentA.KIT_STATION three poses, chosen with a ruler and a comment
    robot2's shake pose the zone centre, minus a tail offset
    robot2._zone_pt a grid search with its own scoring
    nav.capture_approach a ladder of stand-offs, its own scoring again
    stand_for(region, effector, footprint, costmap) is that question as a
    function. A Footprint is a c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
2026-09-02 CLAUDE.md: never hardcode a pose, never tune a movement constant
    Written because the failure recurs every time context is lost, and it
    recurs the same way: the reasoning behind the architecture goes, route.py
    and robot2.py remain, and 4000 lines carrying 890 numeric literals read as
    "the way this project works". A problem then gets diagnosed correctly and
    fixed by adding one more constant in the surrounding style, the board moves
    a few points inside its own noise, and nothing generalises.
    The document states the rule, two tests for recognising a violation before
    writing it, the worked example that makes it concrete (the PCC_L window I
    derived on paper was wrong, and shipped, because a cons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
2026-09-02 Model checks: 215 of them, one command, 52 seconds
    Asked for an extensive set of tests that confirm the simulation model is
    actually correct, because too often the model has been assumed to be set up
    one way and was not. Two new suites and a runner.
    check_board (29 checks, 1.2 s) tests the thing the robots stand on, which
    nothing tested before: piece counts and sizes, four patients of each colour
    and six a side, every patient on its sticker, the colours reading back as
    they were written, nothing starting outside the field or below the floor or
    inside another piece, the board still after two seconds of nobody touching
    it, the referee's zones agreeing with the rectangles params declares, and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
    [check_all.py, mjcf.py, params.py, robot2.py]
2026-09-02 One robot's chassis was living inside the navigation library
    nav.py declared BODY_PTS -- robot 2's footprint, capture pocket and all --
    and used it in body_masks, capture_approach and plan_push. Every map, mask
    and feasibility test in the project therefore assumed that chassis, whether
    or not the caller had one. A footprint is a property of a machine, not of
    navigation, so it moves to params.Robot2.BODY_PTS and the three entry
    points take it as an argument. There is deliberately no default: a default
    is how this coupling would come back.
    The mask cache had the same fault one level down. body_masks was memoised
    on the costmap alone, so a second robot asking the same map a question
    would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
2026-09-02 Robot 1 solves for where to stand, and drives there on a plan (F148)
    Robot 1 had no map. It never touched nav at all: it drove a script of
    turn-and-drive legs to three poses chosen with a ruler, which is why its
    kit approach spent a season driving through four patients without anything
    noticing. A robot that cannot see the board cannot avoid what is on it.
    Four offenders from CLAUDE.md's list go together, because they were all the
    same missing thing.
    KIT_STATION is gone. route.kit_stand computes the pose every time from
    the zone the kits must land in, the hopper that throws them, the chassis
    that carries it, and a costmap of what is actually on the board. Ties
    break toward the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
    [fleet.py, params.py, robot2.py, route.py, station.py, world.py]
2026-09-02 The zones are the tape, and a refusal needs a fallback (F149-F151)
    Continuing down CLAUDE.md's offender list. robot2.ZONES, EDGE_HARD and the
    bespoke grid search in _zone_pt are gone; place_stand calls the same solver
    robot 1 uses for its hoppers, with the pocket described as a
    station.Effector.
    F149 THE CARRY TOLERANCE IS NOT A PROPERTY OF THE ZONE. Every destination
    rectangle was carried around pre-inset by 40 mm so a carry stopping
    inside its tolerance still landed inside the line, and _zone_pt then
    inset it again by its own 12. Two different things were being added
    together: what the POCKET does when it lets go, which is a mechanism,
    and how close the T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
    [check_all.py, params.py, robot2.py, route.py, station.py]
2026-09-02 The doors are found, not drawn (F152)
    fleet.py carried eight rectangles typed from a drawing, and the two that
    matter -- "the two pinches, 176 mm of gap for a chassis planned at 150" --
    are the whole reason its reservation protocol exists. They were also wrong
    in a way worth understanding: a door here is not a fact about the field, it
    is a fact about the field PLUS the twelve patients standing in it. On a
    cleared board there is no pinch at all, and the patients move all match.
    world.widest_path finds them instead. Of all the routes from the south
    half to the north, take the one whose TIGHTEST point is as wide as possible
    -- the bottleneck-shortest-path problem, which is Dijkstra with max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
    [fleet.py, robot2.py, world.py]
2026-09-02 A 5 g cylinder is not a wall to a 4 kg robot (F153)
    Giving robot 1 a costmap (F148) put the twelve patients on it for the first
    time, as hard obstacles, and robot 1 promptly declared both kit zones
    unreachable. It is right to: the sticker columns leave 80 mm gaps and
    robot 1 is 235 mm wide, so as walls there is NO route to the hospital at
    all. Measured over 24 seeds that is the whole kit collapse --
    v38 -> v39 kits 17.0 -> -17.4 (both zones skipped outright)
    v39 -> v40 kits -17.4 -> -16.6 (the fallback did nothing, and cost
    the beams 17 points driving to
    tight poses that led nowhere)
    -- and F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
    [route.py, world.py]
2026-09-02 morphology: the chassis outline as a packing + board problem
    Robot 1 is 285 x 235 mm and neither number was derived. 235 is an
    assertion in params.py that the chassis width EQUALS two carried beams;
    285 is where a 280 mm beam ends when a tail stop pushes it. The
    beam-carrying subsystem was allowed to set the vehicle's outline, and
    every route the robot plans pays for it.
    morphology.py asks the size question the other way round:
    Module what must be INSIDE, from the mechanism parameters. The
    length is one conveyor line -- intake, belt, magazine -- so
    those runs add; the drive, cameras and sweep sit above or
    below it and only spend width.
    Cargo wha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
    [check_all.py, morphology.py]
2026-09-02 A* plans for a disc, and neither robot is one (F154)
    v41 came back at 8/250, the fourth fall in a row from v37's 58.3. The
    columns say where it went: kits 22.6 -> -7.4 and beams 34.6 -> 25.0, with
    samples untouched at ~20. Traced on seed 2, both are one fact.
    The kit dispatch starts on the dock line facing SOUTH with the zones to
    the north. nav.plan returned a 1180 mm path and priced it at 5.1 s; the
    schedule budgeted 11.7 from its table; the leg took 18.3 s. Rigged in
    isolation the tracker drove 38 mm, put its nose -- 142 mm ahead of the
    axle -- into the south wall, and sat there until the watchdog fired 2.5 s
    later. The guard, sized as TRAVEL + DUR + 8 = 23.7 s, then cut the leg
    2.6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
2026-09-02 Robot 1 is 230 mm long, and the length is one dial (F154)
    285 was never derived. It is where a 280 mm beam ends when a tail stop
    pushes it, and the intake was then laid out in absolute tail-referenced
    millimetres against that -- so the chassis inherited the beam's length,
    and with it a swept radius of 185 mm against a corridor that offers 170.
    check_morphology packs what actually has to be inside and gets 174 x 180:
    the slack was 111 mm of length doing nothing but making the robot too big
    to turn round.
    A_LENGTH one dial, above both Chassis and AgentA because both need
    it. 230 leaves the belt 122 mm (a disc needs 56) and brings
    the swept circle to 164 -- i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
    [mjcf.py, params.py]
2026-09-02 The kit dispatch drives the plan it made (F154), and keeps off its own pile
    nav.plan_se2 existed but nothing used it. Wired in:
    station.reachable now filters stands with the SE(2) search instead of a
    holonomic A*, so a stand survives only if there is a way to arrive at it
    FACING THE ZONE -- and the seconds it reports are the plan's own, which
    is the travel model the guard has been taking from a table.
    trajectory.follow walks the plan: pivot_to for the legs the search
    proved there was room for, pure pursuit for each same-gear run, with the
    gear the search chose rather than one the tracker guesses at.
    Measured from the dock line, four seeds, the leg that could not start: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
2026-09-02 morphology: the beams ride where the pocket puts them
    Modelling them centred and just outboard of the packing understated the
    loaded swept radius by 5 mm -- enough for this file to certify a turn the
    loaded robot cannot make. Each beam sits against its own end stop, so
    params fixes it fore-and-aft, and POCKET_Y fixes it laterally; a design
    may not bring a beam inboard of what is packed, but where params has
    already placed it, that is where it rides.
    Loaded envelope now reads 185 mm as built, 164 empty.
2026-09-02 The sweep stops where the KNIFE says, not at 158 (F154)
    The 230 mm chassis dropped the board to -33.3 and took the one column
    that had never moved with it: samples 20.7 -> -5.4, three aboard to zero,
    two of them bulldozed 150 mm east.
    yield from guard(sweep_line(rb, lane, 158.0, want=3), 45.0)
    158 is where the AXLE stops. A sample is only picked up with the west
    wall behind it -- the wedge law says the knife slides under a held piece
    and shoves a free one, and F78 measured 10 of 15 captured against the
    wall against 0 of 5 in open field -- so what the number was really saying
    is "put the knife tip under the centre of a disc resting on the wall":
    28 (a disc's radius) + 129.5 (how f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
2026-09-08 Truss cell, tier 0: the section is derived, and the brief's is 5 Hz short
    A second fixture for the test bench: a gantry winding Kevlar round the
    joints of a carbon-fibre Warren truss (sim/truss). Nothing in it is a
    pose, a station or a lift height typed in; every one is computed from a
    Truss dataclass, the cell's device facts and the fixture derived from
    them. Numpy only -- this tier runs on the controller.
    WHAT THE OPTIMISER SAYS. structure.design() sweeps section side,
    diagonal angle and rod stock against the brief's own rules -- a 0.005
    degree yaw budget at half margin, 50 g heads on 500 mm cantilevers under
    3 g, a 200 Hz first mode, member modes above the 330 Hz blade-pass
    ceiling, a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
    [approach.py, band.py, check_all.py, fixture.py]
2026-09-08 Truss cell, tiers 1 and 2: what contact and a real thread changed
    The cell runs end to end in MuJoCo: 377 ops of the 300 mm truss's plan,
    562 s simulated against 558 planned, every rod seated within 0.005 mm of
    where geometry.py put it, every band 18.0 turns centred within 0.16 mm,
    every drop on its joint, the head touching nothing at the end. 343
    checks in ten suites, 776 s for the full tier.
    What contact changed, each measured:
    * A rod turned to its placing yaw while RETRACTED is inside the ring:
    -0.5 mm at +-alpha, and the sweep stopped at 37 of its 135 degrees
    with the rod slipping in the pads. Extended it clears by 16.5. The
    yaw waits for the extension now, at the hei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
    [approach.py, band.py, cell.py]
2026-09-09 The brief, revised by the model: six figures that changed the design
    truss-automation-spec.md arrived on master as revision 1, written before
    there was anything to measure against. Every number in it has now been
    put to sim/truss, and six came back different. Each is named in the
    document where it sits, with the suite that measured it.
    * 228 Hz is a bending-only first mode. A Warren truss has a real shear
    compliance in its web, and with it the brief's own 90 mm truss is
    195 Hz -- under the 200 Hz rule the same document sets in section 6.
    The optimiser's 92 mm, 40-degree answer reaches 201 Hz at 54.9 g.
    * The 300 mm truss's 40 mm section cannot be built by the machine in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
2026-09-09 The demo opened on a fixed camera, where MuJoCo gives the mouse nothing
    Reported from the viewer: no zoom, no orbit, no pan. The cause is one
    line. demo_cell set the camera to a FIXED viewpoint before the first
    frame, and MuJoCo puts left-drag orbit, right-drag pan and scroll zoom on
    the FREE camera only. Nothing on screen says so, which is exactly the
    trap rfgyc26/view.py was written for next door -- its header describes
    this failure and the demo lost the lesson.
    The viewer now opens free, framed on the cell, so the mouse is live from
    the first frame. The frame is computed: the fixture's x range, its y
    reach and the cage's swept radius, so a 300 mm cell and a metre one both
    arrive fill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
    [check_all.py, view.py]
2026-09-09 The spine, judged by what the camera loses: a frame model and a sweep
    sim/truss asks whether the cell can build a spine. sim/spine asks whether
    the spine is worth building, and answers in the only currency the product
    has: metres of range error at a stated range. A stereo pair reads range
    from disparity, so a relative yaw of dtheta between the camera faces costs
    Z^2 dtheta / B -- the focal length cancels -- and a stretched baseline
    costs Z dB / B. Stiffness, temperature and resonance therefore add up in
    one number, and a lattice and a tube can be compared inside one solver.
    Not MuJoCo: it has no beam element, and a lumped-spring stand-in would
    need stiffnesses derived analytically first,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
    [check_all.py]
2026-09-09 The cell builds the design the sweep chose, and an end plate was a ball
    demo_optimal.py runs the same cell, the same head and the same process
    against the geometry sim/spine picked by solving what the CAMERA needs: a
    115 mm section on 40 degree diagonals with a 1.5 mm web. Simulated end to
    end: 24 of 24 joints wound and dosed, 24 of 24 rods seated, 21.9 minutes
    against 21.6 planned, and it prints what the truss is worth when it is
    finished -- 0.82 m of range error at 100 m, 94% of the yaw budget, 45.5 g.
    Against the geometry the cell was first built around that is 16% lighter,
    34% truer, inside the budget rather than 42% over it, and three joints
    fewer, so it builds in two and a half minute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
    [fixture.py, spec.py]
2026-09-09 The ring's drive, measured: a mesh that could not mesh, and a mouth that wedged
    The head was reviewed after the obvious question -- where does the motor
    shaft go, if the rod is on the axis? -- and every step of the written
    answer was wrong. Tier 2 (truss/drive.py, check_drive) builds the ring as
    a FREE BODY: no hinge, no weld, six degrees of freedom, held by a C-channel
    raceway and three pinions with real involute teeth, and turned against the
    thread. Sixteen checks. What it found, in order:
    * 72 rim teeth and a 12-tooth pinion at 6 mm pitch radius are module 0.556
    and module 1.0. Two gears of different module do not mesh; the drive
    could not have turned. Ring.mesh() solves the cou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
    [approach.py, cell.py, check_all.py]
2026-09-09 The sweep did not know what the cell can build, and the bore is the binding constraint
    Re-ran the design sweep against the current model, to check chosen.py's
    provenance. Every number it records still holds -- 45.5 g, 0.82 m at 100 m,
    0.94 of the budget, 199 Hz -- and the sweep's ANSWER has moved, because the
    sweep was answering a different question.
    WHAT THE SWEEP DID NOT KNOW. The bore a joint needs scales as tan(alpha),
    so the winding head limits the WEB ANGLE, and the web angle is what buys
    accuracy. Left out, the sweep named warren 120/45/3.0/1.5 as the lightest
    design holding the accuracy budget. 28 designs held that budget and NOT ONE
    of them could be made: every one wants a 45 d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
2026-09-09 The camera mount is a third of the error budget, and where its mass sits decides it
    The spine model closed the end triangle with a `bracket`: massless, 20 x 3
    mm, infinitely stiff, and holding the camera's mass out on the three chord
    ends. That was a placeholder for a mount nobody had designed, and it hid
    the whole problem. Replaced with a real six-strut nose -- 12 rods an end,
    3 end battens, 6 struts, 3 platform rods, every joint an epoxy fillet --
    the answer turns on ONE number:
    camera bonded end-on, mass half a housing outboard 1.84 of the budget
    camera's mass IN the platform's plane 0.70
    the massless rigid placeholder it replaces 0.94
    So the mou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
    [model.py, mount.py, spec.py]
2026-09-09 The camera was photographing its own truss, and the standoff is what fixes it
    The enclosure is rigid and load-bearing, so it IS the platform: the six
    struts bond straight to it, the three platform rods are gone, and the mount
    is nine rods an end. That is worth more than the rods it saves -- with
    nothing reaching round the front, nothing of the mount can enter the lens's
    field -- and it costs almost nothing, 0.81 of the yaw budget against 0.68
    for three carbon rods surrounding the whole module at 29 mm. The lever arm
    is second order once the mass is in the plane, which was the earlier
    finding, and the enclosure is centred on the lens, so bonding to it puts the
    mass AND the optical axis on t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
    [mount.py]
2026-09-09 The camera weighs 4 g, not 50, and every answer downstream of it moved
    The tip mass was a placeholder carried from the brief. The vendor's own
    comparison table weighs a Camera Module 3 at 4 g, and the modules it
    supersedes at 3. Tip mass sets the tip force, dominates the Rayleigh mass,
    and therefore fixes both the angular budget and the first mode -- so an
    order of magnitude of it had been setting the design.
    Re-swept with the real head, the mount modelled, and every rule the cell
    and the members impose applied together (1470 candidates, 60-160 mm
    sections, 30-60 degree webs):
    said is
    the budget cannot be met inside 100 mm met at 85 mm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
    [fixture.py, geometry.py]
2026-09-09 The cell could not pick up a camera, and could not be made to
    Asked of the machine rather than of the geometry, and the first answer was
    no. The gripper's jaws open 8 mm, sized for a 3 mm rod with clearance. A
    Camera Module 3 is 11.3 mm through its thin way and its metal enclosure is
    10.8 mm square. The only thing on the module inside 8 mm is the 5.75 mm
    lens barrel, which is the one part a machine must not touch.
    AND OPENING THE JAWS IS NOT THE FIX, which is the finding. The magazine's
    slot pitch is bounded below by JAW_OPEN/2 -- a rod has to clear the pads
    that straddle its neighbour -- the diagonal racks pitch along x, and the
    gantry is nearly full. Jaws wide enough for the enclosur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
    [check_all.py, fixture.py, mjcf.py, mount.py, spec.py]
2026-09-09 Camera Module 2, because the one with the moving lens cannot hold a stereo pair
    The part changed and the reason is measured, not preferred. Module 3
    focuses with an open-loop voice coil whose postural difference is +-50 um
    at a FIXED drive current -- 1.06% of the image distance, and so 1.06% of
    every range it reports. At 100 m that is 1.06 m against the 0.84 m that is
    the entire inter-camera budget this whole structure exists to hold, from
    inside one camera, with nothing bent. Locking the focus does not remove it:
    the postural term is what the coil does at a fixed current. Module 2's lens
    is set on a thread and stays where it is put.
    WHAT THE SWAP COSTS, and it is not nothing: 3.04 mm o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
    [mount.py, spec.py]
2026-09-09 A photograph of the part settles what the top view could not
    The mechanical drawing is a top view, so the one dimension it does not give
    is how far the lens housing stands proud of the board -- and that is the
    dimension the six struts bond to. A photograph shows the assembly is a LOW
    SQUARE BASE with a tall round barrel standing on it, so the base is a
    minority of the module's eight millimetres of stand-off, not the five that
    was placeheld.
    SWEPT, AND THE STRUCTURE DOES NOT TURN ON IT. Over 1.5 to 8 mm -- more
    range than it could plausibly have -- the yaw budget moves from 0.6415 to
    0.6540, two per cent, and the solved standoff and the field clearance do not
    move at all. That is now a ch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
    [spec.py]
2026-09-09 The camera was aimed 30 degrees off a chord, and the check compared two numbers
    Found by drawing it. look_azimuth() returns 150 degrees and the check that
    forbids aiming at a chord compared that SCALAR against the chords' azimuths
    -- 60 degrees clear, and it passed for as long as it has existed. But
    solve() assembled the look VECTOR as (0, sin az, -cos az) while every chord
    direction comes from radial(phi) = (0, cos phi, sin phi). The two frames are
    90 degrees apart, so the camera was actually pointed 30 degrees off chord 0
    -- the exact thing look_azimuth's own docstring says must never happen, and
    the reason the field clearance was a razor-thin +0.04 mm.
    A NUMBER AGAINST A NUMBER CANNOT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
    [mount.py, spec.py]
2026-09-09 One strut of three was landing on nothing, and the mount needs a collar
    Found by being asked how six rods hold a camera at ninety degrees. Drawing
    the answer was enough to see that the landings were placed on a ring centred
    on the SPINE's axis, and a ring centred there only lies on the lens housing
    if the housing straddles it. It does not: it is a shallow block on the FRONT
    of the module. Two landings of three came out on it and the third came out
    off the back of the board, in mid air, at every end of every truss this model
    has ever solved.
    The check meant to catch it compared platform_radius() with case_r() -- a
    radius against a circumradius, a number against a number -- and never asked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
    [mount.py, spec.py]
2026-09-09 The collar was inside the camera, and the fixture could not get out
    TWO FINDINGS FROM LOOKING AT A RENDER, both of parts that cannot be made.
    THE COLLAR WAS A FIN STANDING ON EDGE, in the plane perpendicular to the
    spine -- which is where a hexapod's platform wants to be, and is the one
    plane a plate bonded to the lens housing cannot lie in. Measured against
    the module's own solid:
    collar 0 4.50 mm inside the PCB grid 5 4.50 mm inside
    collar 2 4.50 mm inside grid 6 4.50 mm inside
    strut 14 1.74 mm inside strut 16 1.74 mm inside
    6 of 19 elements at one end
    Nothing static asked. Every check about the mount asked whether a feature
    was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
    [check_all.py, collapse.py, fixture.py, mjcf.py, mount.py]
2026-09-09 The cell builds the whole thing now, cameras included, and the rails had to move twice
    WHAT RUNS. One plan, from racks a person has filled by hand to a truss with
    a camera on each end, through the same schedule.plan the checks use and the
    same process.Executor against the same MuJoCo cell:
    955 ops, 21.2 min simulated, 45 min wall
    9 rods loaded and seated, 9 joints wound, 9 bands dosed
    28 mount parts placed, 52 epoxy fillets laid
    <truss 9/9 joints, 9 rods seated of 9, 1.35 g on the joints>
    `demo_assembly.py` runs it and writes the film and a still per phase. The
    mount is a phase of the plan now, not a drawing hung on the cage: thirteen
    rods an end plus the camera on its ca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
2026-09-09 The demo names the file it actually wrote, and groups the stalls it saw
    46 of the 955 ops overran their planned duration, all of them `axes settle`
    or `stroke settle` in the mount and bond phases: the head presses on
    something as it works inside the cage. The plan completes and the inspector
    passes the truss, so this was easy to miss in a wall of identical lines --
    `--stalls` lists them and the run now prints them grouped by phase and kind.
    That is the next thing to fix, and it is one thing: the approach solver plans
    the ring's descent onto a joint and nothing plans the gripper's descent onto
    a mount pose.
    Also: write_video returns the path it wrote, so a run without ffmpeg stops
    claiming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
2026-09-10 --gui on the assembly demo opened nothing
    The flag existed and only skipped the headless GL context: there was no
    viewer behind it, so `--gui` ran the same silent loop and printed a report
    twenty minutes later. It drives MuJoCo's passive viewer now, the same way
    demo_cell does -- the same camera rig and keys, the bands growing as the
    fiducial counts the turns, ops printed as they complete, and the window
    outliving the cycle, because what the demo is for is the thing it made.
    `--speed` now means what it means in demo_cell -- wall-clock pacing, 20x
    being the one to watch -- and the film's own pacing moved to `--vspeed`.
    Docstring carries the Windows invocation: `python`, not `python3`, from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
2026-09-10 Six torsion shafts ran through both cameras, and no number could see it
    LOOK AT IT. The mount phase reported every rod placed within 0.45 mm and
    0.0 degrees of plan. The inspector passed the truss. 955 of 955 ops ran.
    And the thing it built was a mess -- which I only found out because someone
    opened the viewer and said so.
    Every one of those numbers was measuring the model against ITSELF. A number
    can say the machine went where the plan said; it cannot say the plan was the
    design, and it cannot see a part that is somewhere the plan never mentions.
    WHAT THE FRAME SHOWED, once one was rendered and read: the collapsing
    mandrel's six torsion shafts ran the whole length of the cage -- end p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
2026-09-10 Station B: the crossings are wound before the camera reaches the truss
    WHY A SECOND MACHINE, stated as geometry rather than as a preference. The
    mount's four tic-tac-toe rods are WOUND to each other -- the same thread the
    truss's joints use, so the joint is a joint and not resin on a tangent. To
    wind a crossing the head has to encircle it with its bore along the lower
    grid rod, which runs along the SPINE -- so its ring lies in the end
    triangle's own plane, centred 20 mm off the axis:
    the cell's head reaches 27.2 mm to its rim
    there is 15.4 mm from a crossing out to the chord circle
    B's winder reaches 11.0
    The main cell's own rim goes straight through the chords. There is no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
2026-09-10 Station B builds the tic-tac-toe on a jig, and the frames found five faults the numbers could not
    The kit now lands within 0.16 mm of the geometry mount.solve lands its
    struts on, on every rod, with all four crossings wound. It was 11.77 mm
    and 25 degrees. Every one of the five faults between those numbers was
    found by rendering the run and reading it; each was reporting clean.
    WHY THERE IS A JIG. A ring centred on a crossing reaches 11 mm below it,
    and four millimetres down it is already 10.4 mm in along the diagonal --
    over a plate 30 mm across, on a board 25 across, in a nest. Measured on a
    rig, the ring touched the board 78,000 times and turned 0.02 of a turn.
    Nothing orbits a joint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
2026-09-10 The cell stops laying the grid, and a rig finds four struts a truss laid 47 degrees off their own line
    Station B makes the tic-tac-toe, so the cell must not also try to. It laid
    its own four grid rods per end AND drew the camera with a solid plate where
    the grid goes -- both at once, so it was planning against a part that does
    not exist. It now fetches ONE part: module, collar and the wound frame, and
    `attach_mount` says why it does not lay the other two.
    WHAT THE PART IS, drawn as the thing that arrives: the module as the two
    boxes `mount.payload_solid` says it is, the collar as the twelve segments
    `mount.collar_segments` says it is, and the four grid rods. Nineteen geoms
    where there were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
2026-09-10 The kit would not seat because the mandrel was already there, and four numbers said so once they were measured
    The head kit lands 0.79 mm from where mount.solve puts it. It was 25.59.
    The whole mount is 4.43 mm and 8.2 degrees, from 30.60; every op reported
    success at both readings.
    WHAT WAS IN THE NOSE. The camera is mounted on the cage's own axis -- that
    is the point of the mount, since a mass off the axis turns a manoeuvre into
    camera yaw -- and the cage's backbone is on that axis too. `nose_spine_r`
    stepped the tube down to 3 mm on the belief that the module's nearest face
    was 4.5 mm OFF the axis. It is not off it: the board is 9 mm deep centred
    ON it, so no radius clears it and none ev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
2026-09-10 The battens were not being pushed by anything: the yaw took the short way round and the servo clamped
    The three battens an end land within 0.02 mm and 0.0 degrees. They were
    4.43 mm and 8.2 degrees. The mount as a whole is 2.17 mm, from 4.43.
    IT LOOKED LIKE A COLLISION AND IT WAS NOT. Five members terminate at each
    chord end at exactly the same point -- the chord, two battens, two struts --
    so the obvious reading was that the second to arrive is pushed by the
    first, and the obvious fix was to stagger them. The trace says otherwise:
    batten 10 reaches its target midpoint to 0.03 mm with NOTHING TOUCHING IT
    at any point in its own ops, and comes to rest 4.43 mm out at its ends. A
    rod at the ri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
    [process.py, schedule.py, stationb.py]
2026-09-10 A thread post was levering the four struts, and where a post stands was never a number
    rig_mount, TRUSS_300: struts 13/15/22/24 came out 2.17 mm and 6 degrees off
    their own line with plan 0.00, dcage 0.00, dyaw 0.04 and track 0.04-0.17 --
    every axis where it was told, on a rod sitting 0.00 mm and 0.00 degrees in
    its rack, held by a weld an isolated rig measures at 0.00 degrees. The
    tilt appears in one tick, immediately after the keeper takes the rod:
    110.12 off its own line 0.04 deg
    111.52 off its own line 5.92 deg
    Contacts sampled every tenth tick reported an empty list. Every tick
    reported post0 / rod13_g, for four ticks -- eight milliseconds. Measured
    as pure geometry a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
2026-09-11 The mount's magazine wanted 1766 mm of a 1400 mm axis, and the check that would have said so built a fixture with no camera on it
    Racked beyond the end racks -- on the diagonals' own pitch, each kit's nest
    padded by the constant the chord rack stands off the cage by -- the mount's
    twenty parts put the chosen truss at 1766 mm of X against a gantry with
    1400, and TRUSS_1M at 1722. The cell could not have reached its own
    magazine. Nothing said so because check_mount measured `x_reach` on a
    fixture with no mount attached (1397 of 1400, which is true and is not the
    question), and because every simulation this project has run is the 300 mm
    truss, which fits in 822.
    THE FLANKS ARE EMPTY AND THE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
    [fixture.py, mjcf.py, mount.py, schedule.py, spec.py]
2026-09-11 The far nose's kit was racked at the wrong end of the cell, and a flush slot read as an overlapping one
    A MOUNT PART IS FETCHED AND CARRIED BACK, so the phase costs twice each
    part's distance from its nose and the ORDER it is laid in cannot change
    that -- only where it lies can. Filled from one end of the bench, the far
    nose's kit was racked 1124 mm from the nose it goes on, at the wrong end of
    the cell, and three of the 300 mm truss's parts were on the wrong nose too.
    Every part now goes to the free station NEAREST the nose it is laid at, on
    the flank where it stands closest to the axis, without making the loader
    reach further in y than the truss's own racks already do -- and only if no
    su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
    [fixture.py]
2026-09-11 The Windows command line in demo_assembly's docstring was mangled, and the check for it could not fail
    Run on Windows, `demo_assembly` prints
    SyntaxWarning: invalid escape sequence '\d'
    at the operator before it does anything else, and that is the QUIET half of
    the fault. The docstring documents the Windows command line, which has
    backslashes in it, and was not raw -- so `\t` became a TAB and ate the `t`
    of `truss`. What the file actually handed a Windows user, as stored:
    python scripts<tab>russ\demo_assembly.py --gui --speed 20
    `\t` is a valid escape and says nothing; only the `\d` warned. From Python
    3.12 that warning is a SyntaxWarning rather than a DeprecationWarning, and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
2026-09-15 The 1 m procurement limit put on the diagonal, and what the BOM does not yet say
    A 1 m rail and ballscrew cannot serve a cell that needs 1400 mm along the
    truss axis, and the diagonal placement is the right answer -- but not for
    the reason it first appears to, and with less margin than it looks.
    MEASURED, AND THE TRAP IS THAT S IS NOT 1000. An SFU1204-1000 with its
    BK10/BF10 journals, its ball nut and end-of-travel safety gives about 880
    mm of usable stroke, so the diagonal reach is 1245 mm rather than 1414.
    Against that, what the cell must reach along the truss axis:
    as built, diagonals in end racks 1397 no
    diagonals also beside the cage 1246 by 1 mm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
2026-09-15 Z stays on a rail and a ball screw, and the decision is recorded with what it costs
    Asked whether the Z axis, which carries little, could drop to a lead screw
    and smooth rods. Decided to keep the MGN12H rail and the SFU1204 ball
    screw, and the document now carries a decision log so the alternative is
    visibly costed rather than merely absent.
    MEASURED WHILE COSTING IT, and worth keeping whatever was decided: Z is a
    COARSE positioner -- the gripper and the dispenser each have their own 40 mm
    stroke and it is that stroke, not Z, which makes the final approach -- and
    what Z resists is a MOMENT rather than a weight, since the tools stand 15 to
    30 mm off the column and the yaw servo's reaction i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
2026-09-16 The drive as files to send a printer, and the two faults that only a picture and a ray found
    The printable geometry is GENERATED from Ring.mesh() rather than drawn, and
    check_cad (63 checks) re-derives it: the module, both tooth counts, the
    solved mouth, the three azimuths, and the axial chain from the ring's own
    4 mm out to the plate. Two real faults came out of it, neither visible in
    a table of dimensions:
    THE PINION WINDOW WAS DERIVED FROM THE WRONG FEATURE. The gear's tip
    reaches ring-radius 18.4, inside the back wall's 20.05, so the teeth pass
    under the wall and only the hub looked like it needed a window: 14.93
    degrees. But a pinion is a DISC at r 26.4, and the further roun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
    [base.dxf, pinion.stl, plate.dxf, race_long.stl, race_short.stl, ring.stl, vjig_chord.stl, vjig_diag.stl]
2026-09-16 A standoff hole 1.2 mm from a slot edge, found by drawing the part
    The rig's files now come with labelled diagrams generated from the same
    geometry, and drawing them found what 63 numeric checks had not.
    THE PLATE HAD A 1.2 mm WEB. `standoff_az` rejected any hole whose CENTRE
    fell within 2 mm of the rod slot's edge, which reads as a clearance and is
    not one: a 3.40 hole at 9.9 mm from the axis leaves 1.2 mm of 6 mm acrylic
    between its edge and the slot's. That is a crack, not a web. The rule now
    keeps the hole's own radius plus 5 mm clear and the thinnest web is 4.97;
    the check measures the web rather than the centre.
    Three more that the pictures decided:
    A PERSPECTIVE RENDER IS THE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
    [plate.dxf, ring.stl]
2026-09-16 The division of labour: five actuators, not nine, and three cuts a truss
    A question about how the thread gets from the ring to the rod exposed that
    the winding PROCESS was nowhere described. The simulation planned the
    motion in detail and the mechanism was a duration with a name. Working it
    out moved four operations off the machine and found one error.
    THE ANCHOR AND THE CUT ARE THREE PER TRUSS, NOT THIRTY, and this was
    already in schedule.py unread: "the thread is continuous along a chord".
    The plan loops four legs round a post on the fixture, runs 2718 mm of
    thread through all ten of a chord's joints carrying 97.7 mm between bands,
    and cuts once at the far post. Three anchors, three cu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
    [approach.py]
2026-09-16 Z self-locks for 162 s of the clock, and a trolley may arrive 2 degrees crooked
    Z REVERTS TO A LEAD SCREW (E2). E1 kept a ball screw on four legs and PART
    F voided one: "dose is the single accuracy-critical op that approaches its
    height from ABOVE". With the dispenser off the machine every remaining Z op
    descends, so backlash is taken up in one direction and does not appear. A
    Tr8x2 is self-locking -- 5.2 degrees of lead angle against a 5.7 degree
    friction angle at mu 0.10 -- which DELETES the backdriving requirement E1
    had to carry as a live item: no holding current, no brake, no counterbalance,
    and cutting motor power on an E-stop no longer drops the head onto the work.
    Tr8x4 would have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
    [cell.py, spec.py]
2026-09-16 The trolley's position need not be good, and its orientation cannot be fixed
    I had PART H's architecture backwards and it is corrected in place.
    WHAT WAS WRONG. H invented a "+-25 mm" accuracy requirement for the mecanum
    base and then recommended a passive straightedge to hold its yaw. Neither
    belongs. Two linear stages plus Z cancel a translation EXACTLY, so the
    coarse position may be off by anything up to the stage travel less the
    working envelope -- there is no accuracy requirement on the wheels at all.
    What the stages cannot do is change an ORIENTATION: they are three degrees
    of freedom out of six, and knowing the trolley's yaw to a thousandth of a
    degree does not correct it.
    So the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
2026-09-16 A yaw stage takes the uncorrected set from three axes to two, and the two left are the floor's
    The fine assembly gets a rotary axis. Three linear stages cancel a
    translation exactly and cannot touch an orientation, so they leave three
    degrees of freedom uncorrected -- and yaw is the large one, because it is the
    mecanum drive's own free axis where pitch and roll are merely whatever the
    floor gives. One rotary stage turns the uncorrected set from {yaw, pitch,
    roll} into {pitch, roll}, which is the difference between a degree of freedom
    the base controls badly and two a bench controls well.
    The mecanum's job collapses to one sentence: get the joint inside the
    250 x 250 square. Nothing else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
2026-09-16 Roll costs nothing, and pitch's expensive half is a displacement the stages already cancel
    I had lumped pitch and roll together as "floor flatness; absorbed", which
    was pessimistic and hid the two facts that decide the architecture. They
    are three different cases. Measured over all 30 joints against the 1.91 mm
    a perfect pose gives:
    yaw pitch ROLL
    1 deg 1.81 mm 1.74 mm 1.91 mm
    2 deg 1.71 1.58 1.91
    3 deg 1.61 1.41 1.91
    5 deg 1.41 1.09 1.69
    ROLL IS FREE, for a reason worth keeping. It is a rotation about the ring's
    OWN axis, so it does not tilt the ring's plane at all -- it only turns the
    ring with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
2026-09-16 The rail count is set by an angle, and one rail clears it by forty times
    PART I revises the parts list for the coarse-fine architecture. It
    supersedes section 1 and parts of 2 and 3; the original stays because PART A
    reviews it and the history is worth keeping.
    ONE RAIL WITH TWO BLOCKS, NOT TWO RAILS -- on X, on Y and on Z. The
    question is not what the stack carries, it is how much it may TILT, because
    the ring stands about 400 mm above the X carriage and every milliradian is
    amplified by that lever. The 0.45 mm translation budget over 400 mm is
    1.125 mrad, and the worst moment is small: three kilos above the carriage at
    A_MAX 400 mm/s^2 is 1.2 N, which at 400 mm is 0.480 N.m, plus the r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
2026-09-16 A 250 mm screw has 111 mm of stroke, which is one joint per park
    Two corrections, both from a question about a catalogue page.
    A NOMINAL SCREW LENGTH IS NOT A STROKE, and using it as one made PART H's
    park arithmetic wrong. The machined ends, both supports and the nut's own
    body come off before anything moves: 45 + 34 + 20 + 40 = 125 mm of a
    SFU1204 with BK10/BF10 and a flange nut. Against a 97.7 mm joint pitch and
    ten joints to a chord:
    nominal stroke joints per park parks per truss
    250 mm 111 mm 1 30
    300 mm 161 mm 2 15
    400 mm 261 mm 3 12
    500 mm 361 mm 4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
2026-09-16 Z commands 37 mm of stroke, so 250 is four times the travel and 500 is a taller lever
    Z: TAKE THE 250. Measured off the plan rather than assumed -- the 891-op
    build commands z from 49.1 to 86.1 mm, a stroke of THIRTY-SEVEN
    MILLIMETRES. Not the 150 of Z_TRAVEL and not the 145 a 250 mm rail leaves.
    The reason it is so small is that Z moves the head and the GRIPPER's own
    40 mm stroke does the reaching into the racks, so Z never dips for a rod;
    its whole duty is the ring's 13 mm per-joint lift plus the cruise between
    phases.
    250 mm rail, two blocks spanning 105 145 mm 3.9x what is needed
    250 mm Tr8x2 less nut, bearing, coupler 187 mm 5.1x
    500 mm rail, two blocks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
2026-09-16 Two blocks cost no usable travel, and if a rail is ever doubled it should be Y
    Answering why two blocks per axis rather than one, with the travel it costs.
    IT COSTS NOTHING USABLE, because on every axis something else binds first.
    On X and Y the ball screw leaves 361 mm and a 500 mm rail with two blocks at
    60 mm pitch leaves 395, so the second block is free. On Z the rail does
    become the limit -- 145 mm against the screw's 187 -- but 145 is 3.9x the
    37 mm the plan actually commands, so it is free there too.
    What they buy is a square law: two blocks resist pitch and yaw through the
    lever between them, so tilt under the same moment falls as 1/span^2 --
    1.00 for one block, 0.25 for two touch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
2026-09-16 A second Y rail closes the half that was already 8x inside, and cannot reach the other
    Y is the right rail -- it is the only axis whose un-resisted direction is a
    rotation the ring cares about. But the ring's pitch has TWO independent
    sources and a rail reaches one of them.
    SOURCE 1, COMPLIANCE IN THE STACK. The Y carriage rolls about its own rail
    under the head's overhang: 2.5 kg at 120 mm is a constant 2.94 N.m. Taking
    an MGN12H at about 10,000 N.m/rad in roll (inferred from a rating, not a
    datasheet):
    two blocks, one rail 20,000 N.m/rad 0.147 mrad 0.059 mm at the ring
    two blocks, two rails 296,000 0.010 mrad 0.004 mm
    Against the 0.45 mm budget one rail is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
2026-09-16 "2 mm pitch" is an 8 mm lead, and the nut's material carries the self-locking
    Two traps in buying a lead screw, both found on a shop listing, and both
    recorded in E2 because between them they un-do the decision.
    TRAP 1. The common T8 screw is sold as "Trapezoidal 4 START Lead Screw 8mm
    Thread 2mm PITCH", and its own diagram spells out the catch: for a
    multi-start screw the lead is the pitch times the starts. Lead = 4 x 2 =
    8 mm, which on a 7.0 mm pitch diameter is a 19.99 degree lead angle -- the
    "no" row of E1's own self-locking table. A screw bought on the word "pitch"
    gives back everything E2 was for.
    starts lead lead angle mm/step self-locking
    1 2 mm 5.20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
2026-09-16 The Z screw on the shelf is 4-start, so it backdrives and the build gets 162 s back
    Z's lead screw is one already owned: a Tr8 whose listing says "2 mm pitch"
    and means 2 mm of pitch on FOUR starts, so the lead is 8 mm. The comment
    in spec.py said Z was a self-locking Tr8x2 -- 5.2 degrees of lead angle
    against 5.7 of friction -- and that had been wrong since the screw was
    picked. Measured on the real thread: 19.99 degrees of lead angle against
    11.31 for a POM nut at mu 0.20. Z sinks with the power off and drops on an
    E-stop.
    An anti-backlash nut does not touch this. It fixes backlash; the lead
    angle belongs to the screw. Z_COUNTER_N = 15 N does touch it, and a spring
    holds when the pow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
    [cad.py, spec.py]
2026-09-16 Coarse-fine is locked, which makes baseline length a count of parks and not a machine size
    Recorded as a decision rather than a proposal, because it is the one that a
    compaction keeps re-opening. The consequence worth writing down is not the
    rail that is no longer bought, it is that the fine stages never see more
    than one park -- 361 x 361 mm on the 500 mm screws -- so truss length only
    changes parks per truss: 3 for the 300 mm, 9 for the metre, 18 for two
    metres, with no line of the parts list different between them.
    PART B and C1-C10 go with it; they existed only to fit a 1397 mm rail into
    a 1000 mm purchase.
    Gantry.X_TRAVEL and Y_TRAVEL still describe the deleted gantry and are
    flagged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
2026-09-16 One procurement table, and it surfaced a motor the plate cannot take
    Consolidating every part into PART J turned up three things the per-section
    reviews had each half-seen:
    The head plate cuts a NEMA 17 footprint -- 42.3 mm square, 31.0 bolt
    circle, 22.0 boss -- while spec.Ring models a NEMA 8 rotor through 4:1,
    inherited from the brief that predates the 48T-rim-and-belt head. A NEMA 8
    with a gearbox will not bolt to that plate and no suite compares the two.
    Torque settles nothing: both clear the measured 0.0489 N.m peak, and the
    belt is 20T to 20T so any reduction has to be a gearbox. Left as a
    decision rather than changed, because REDUCTION and MOTOR_INERTIA feed the
    drive's inertia and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
2026-09-16 A NEMA 17 jams the ring drive, and the margin on rotor inertia is under 2x
    The updated cart carries three NEMA 17s, which looked like it settled the
    open question of what turns the ring -- three plus the two owned is exactly
    X, Y, Z, head yaw, ring. It does not. Probing check_drive with
    Ring.MOTOR_INERTIA and Ring.REDUCTION patched in memory, nothing else
    touched:
    rotor kg.m^2 at 4:1
    NEMA 8 (8HS15 class) 2.0e-7 16/16 pass
    - 4.0e-7 1 fail <- the cliff
    - 7.0e-7 1 fail
    - 1.0e-6 1 fail
    NEMA 14 1.4e-6 1 fail
    NEMA 17 5.4e-6 1 fail
    and reduction i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
2026-09-16 A stepper has no supply voltage, and the 40 W supply is enough only if the drivers microstep
    Asked whether the ordered steppers are the right voltage. They have none:
    a bipolar stepper is a current-mode device, and the "rated voltage" on its
    datasheet is just I_rated x R_phase -- about 4.8 V for the 1.2 A motors.
    The rail is deliberately far above that to force current through the
    winding inductance, which is where high-speed torque comes from; 32*sqrt(L)
    puts the ideal rail at ~85 V. So 24 V on a nominally 4.8 V motor is
    correct, and it is also the ceiling, because a TMC2209's absolute maximum
    VM is 29 V and a 24 V SMPS off-load sits at 25-26 with regen on top.
    What has to be set rather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
2026-09-16 40 A not 40 W: the power question dissolves and a fault-current one replaces it
    The supplies are 24 V, 12 V and 5 V at 40 A each, not 40 W; the previous
    commit read them as watts and spent a table on a budget that does not
    exist. Five steppers at full current in full-step mode draw 62.8 W, which
    is 6.5% of a 960 W rail.
    What survives the correction is the motors' own heat, and it is the better
    argument anyway: 11.6 W of copper loss sits inside a 42 mm frame, five of
    them hold continuously through an 18.5 s wind, and a winding at 70-80 C has
    higher resistance and less torque exactly where J2.1 found the margin thin.
    So standstill current reduction and microstepping are still wanted -- for
    t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
2026-09-16 The ring's 4:1 was never load-bearing: every ratio passes, so the gearbox comes out
    J6.1 swept rotor inertia at a fixed 4:1 and found the cliff. It never
    swept the RATIO with the NEMA 8 rotor, and that was the measurement that
    decided anything:
    NEMA 8 rotor (2.0e-7), check_drive
    1:1 direct 16/16 pass
    2:1 16/16 pass
    3:1 16/16 pass
    4:1 16/16 pass
    So REDUCTION is a free parameter, and nothing in this design ever said what
    would provide the 4:1. The belt is 20T to 20T, so not the belt; no
    gearbox, shaft or second stage appears in any list. It came from the
    original brief -- "a NEMA 8 operating through a 4:1 mechanical reduction" --
    and the head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
    [spec.py]
2026-09-16 About 2 kg, and with nylon thread the joint fails before the rod does
    Asked in kilograms rather than newtons: what will the metre truss hold in
    its weakest direction. Loaded to failure with the spine FE -- a 1 N load,
    and since the response is linear the buckling margin under it IS the
    failure load:
    cantilever 1 m, load on the far end 20.8 N 2.1 kg <- weakest
    simply supported, load at mid-span 37.8 N 3.9 kg
    clamped mid-mount, load on both ends 41.5 N 4.2 kg
    axial compression 1,766 N 180 kg
    axial tension 31,806 N 3,243 kg
    The truss weighs 45.1 g, so that is 47x its own weight on a metre
    cantilever and 72,000x i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
2026-10-01 Calibrated per unit, an IMU bat knows its sweet spot to about a centimetre
    Monte Carlo of a consumer-MEMS IMU in a bat (sim/batline/imu_fusion_sim.py,
    1500 trials a case; a model, not a measurement). The phone camera anchors
    the bat at a slow moment, the end of the stance or the top of the backlift,
    and the IMU alone carries it to contact. Error across the ball's line at
    contact, median / 95th percentile, stance anchor:
    calibrated per unit datasheet only
    kid drive 6.5 / 13.2 mm 30.2 / 61.0 mm
    adult drive 6.4 / 13.4 24.8 / 51.9
    hard drive 5.8 / 12.2 20.8 / 42.6
    adult pull 7.8 / 16.8 38.0 / 78.3
    Th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
2026-10-02 Derived from its envelope, the kid's bat is 214 g and station 1 caps the line at about 970 a month
    M0 of the bat line's MuJoCo plan: the specs, the bat derived from them and
    the fast line model, each held by a suite that can fail.
    The kid's bat (770 mm, handle 270, grip 32) comes out at 214 g with two AA
    cells and 168 g as shipped, balanced at 0.26 of its length. Its frame is a
    48 mm triangle of 2 mm chords and 1 mm diagonals, 30 joints and 14 g,
    inside the truss cell's gantry reach (891 x 216 of 1,400 x 300 mm), with a
    buckling margin of 5.1 against the cell's rule of 5 under the accuracy
    study's hardest swing. All 33 fits pass. An adult bat (860 mm) the code was
    never developed on derives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
    [check_all.py, check_bat.py, check_line.py, demo_bat.py, mjcf.py]
2026-10-02 Without hand-cut rods the person works 6.8 minutes a bat, not half of 11.6
    Measured with the event model over four months at 300 a month, with faults
    and the robot outage: 11.6 person-minutes a bat with rods cut by hand, 6.8
    with Line(rods_by_hand=False), and every order inside the promise either
    way. The README said rods bought cut would roughly halve the person's
    time; they take 41% off it.
    Claude-Session: https://claude.ai/code/session_01WCydH6PtCqDuaAywrJu1DX
2026-10-02 Preloaded, the station module lands its tools to 0.035 mm on a travel it never saw
    check_gantry (80 checks, about 5 min on four cores) runs the module in
    MuJoCo on the kid's electronics station (X 1643 mm), where it was
    developed, and on the adult's pack station (X 2728 mm, five tools), which
    it had never seen. Both pass unchanged.
    - Repeatability 0.0001 mm on every axis from both sides (the model's
    floor). Under the largest process force each axis moves 0.0008 mm.
    - A one-way approach did nothing against a rack's 0.094 mm of play,
    because the rotor rings at the end of a move. A constant preload toward
    home does: without it X is pushed across its whole play, while plain
    moves still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
    [check_all.py, check_gantry.py, commission.py, demo_station.py, hal.py, mjcf.py, ops.py]
2026-10-02 Eight solver-placed cameras fix the clamp's pose to 0.006 deg and 0.018 mm with one lost
    M2 of the bat line's simulation plan: station 4's camera rig, derived from
    the bat and the catalogue, placed by a coverage solver, calibrated from a
    certified bar, and run on the kid's bat (developed on) and the adult's
    (never seen), with model cameras and with frames rendered in MuJoCo and
    warped through each camera's true lens. check_cameras: 85 checks pass,
    499 s on four cores.
    Measured:
    - Placement, judged on 576 held-out poses: with any one camera lost both
    rigs keep at least 4 markers seen by 3 cameras (rule: 3), the pose
    fixed to 0.0057 deg / 0.054 mm (kid) and 0.0060 / 0.059 (adult) against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
    [check_all.py, check_cameras.py, commission.py, demo_rig.py, judge.py]
2026-10-02 Read through a certified card under falling light, every band comes back within 0.31 dE
    An adversarial review of M2 (cd3dbb3) confirmed 24 findings. Fixed, with
    what each fix measured in check_cameras (116 checks, from 85; 811 s on
    four cores, MuJoCo 3.14.0):
    Colour was wrong in kind, not in degree. The scene printed sRGB numbers
    as if they were reflectances, the lights did not fall off with distance,
    a sensor channel could read negative light that was then clipped at zero,
    and the 8-bit canvas was coarser than the 10-bit sensor. Now: colours are
    linear until encoded back, the card is fitted over the cosine and the
    inverse square, the sensor reads on a black level with a positive-only
    colou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
    [check_cameras.py, demo_rig.py, judge.py, mjcf.py, spec.py]
2026-10-03 On 100 kid bats and 20 adult it never saw, the IMU fit puts every group within target, the lever arm worst at 0.34 and 0.39
    Milestone 3: station 4 calibrates the bat's IMU and checks itself each
    line day. Measured in simulation, not on hardware.
    - The plan is designed from the targets and the gimbal's limits: the
    kid's is 79.9 s (three stills, three spins, one closed tour), the
    adult's 118.2 s. Simulated stepper lag stays at 0.280 of the plan's
    0.326 deg bound and at most 62% of the angle that slips a step.
    Station 4 now takes 5.0 min a bat (M2's hand recipe gave 4.6).
    - The 46-parameter fit: pooled NEES 3029 on 2800 dof (kid) and 647 on
    560 (adult), no term biased, no healthy bat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
    [check_all.py, check_calibration.py, check_imu.py, demo_calibration.py, demo_rig.py, fit.py, golden.py]
2026-10-03 At full speed on its dummy pack the bat's circuit never opens and its IMU peaks at 2306 of 3861 dps; the factory iPhone refuses 24 of 30 bats fused with the wrong record
    Milestone 4: station 2's flash and self-test, the factory iPhone's test
    and the full-speed swing rig, each limit derived and each station timed
    by its procedure's own plan.
    Measured in simulation:
    - Station 2: of 200 healthy boards 1 is refused (4 allowed), and each of
    19 planted faults is refused at its own step on the check's board.
    5.51 s a board against 5.55 planned (M2 booked 40 s).
    - The board's hold-up: 206 uF rides a 10 ms bounce at 1.92 V, so 330 uF
    at its low tolerance; 220 uF carries 0.95 ms, because hold-u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
    [check_all.py, check_link.py, check_swing.py, demo_phone.py, demo_swing.py]
